oosan1/OriginalSMU_KKHS/User_Manual/HTML/前面パネル_SMUモード_留意点.png

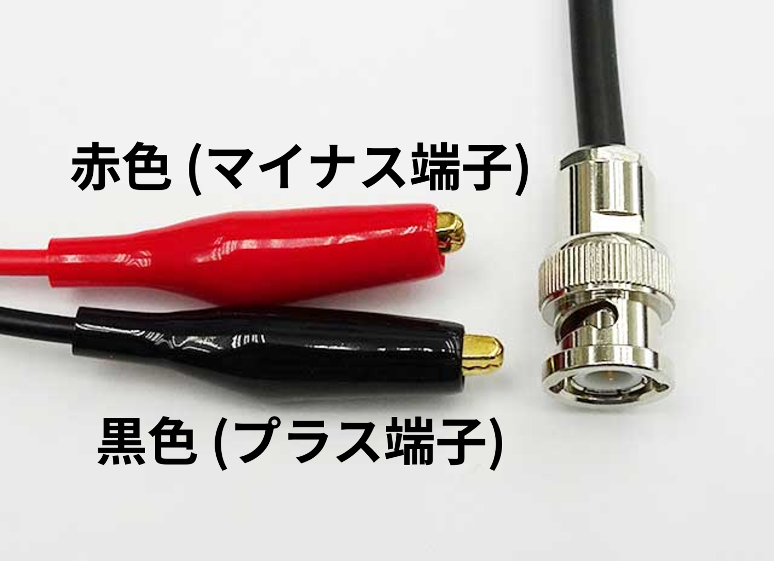
User_Manual/HTML/前面パネル_SMUモード_留意点.png
