oosan1/OriginalSMU_KKHS/User_Manual/HTML/抵抗基盤.jpg

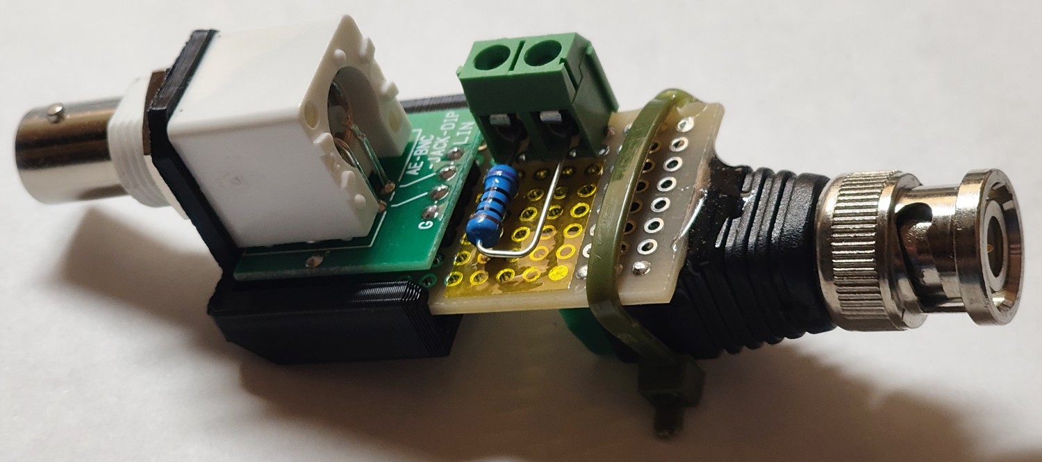
User_Manual/HTML/抵抗基盤.jpg
