oosan1/OriginalSMU_KKHS/Documents/フォルダ・ファイル構造.md

oldと付いているフォルダはもう使われていないデータが入っている。特に説明はしない。

## .gitignore
バージョン管理の対象外フォルダ・ファイルを指定している。
## README.md
githubで表示した時に最初に表示される内容。

# .git
バージョン管理のために自動的に作成されるフォルダ。特に気にしなくて良い。
# Case
ケースの3Dプリント用データが入っている。
# Circuit
回路図全般が入っている。
## PrintedCircuit3
最も新しい回路図とプリント基板用データが入っている。
# Cliant
クライアントに関するプログラムが入っている。
## Web
Webクライアントに関するプログラムが入っている。
# Documents
プログラムなどに関する説明データが入っている。
# microcomputer
ファームウェアに関するプログラムが入っている。
## C_C++
### SMUcontrol
ファームウェアのC/C++版のデータが入っている。最新バージョンで、クライアントとの通信にも対応している。
## python
ファームウェアのMicroPython版のデータが入っている。途中でC/C++に移行したため、基本的なシリアル通信とDAC制御、IVカーブ測定などの機能しかない。ただ、開発初期のプログラムであるということと、シンプルであることから、参考にはなると思う。
# User_Manual
IMPACTの取り扱い説明書のデータが入っている。
## HTML
HTML版
## PDF
PDF版
