oosan1/OriginalSMU_KKHS/Documents/フォルダ・ファイル構造.pdf

フォルダ・ファイル構造.md | 2026-04-03

1 / 2

oldと付いているフォルダはもう使われていないデータが⼊っている。特に説明はしない。

## .gitignore

バージョン管理の対象外フォルダ・ファイルを指定している。

## README.md

githubで表⽰した時に最初に表⽰される内容。

# .git

バージョン管理のために⾃動的に作成されるフォルダ。特に気にしなくて良い。

# Case

ケースの3Dプリント⽤データが⼊っている。

# Circuit

回路図全般が⼊っている。

## PrintedCircuit3

最も新しい回路図とプリント基板⽤データが⼊っている。

# Client

クライアントに関するプログラムが⼊っている。

## Web

Webクライアントに関するプログラムが⼊っている。

# Documents

プログラムなどに関する説明データが⼊っている。

# microcomputer

ファームウェアに関するプログラムが⼊っている。

## C_C++

フォルダ・ファイル構造.md | 2026-04-03

2 / 2

SMUcontrol

ファームウェアのC/C++版のデータが⼊っている。最新バージョンで、クライアントとの通信にも対応して いる。

## python

ファームウェアのMicroPython版のデータが⼊っている。途中でC/C++に移⾏したため、基本的なシリアル 通信とDAC制御、IVカーブ測定などの機能しかない。ただ、開発初期のプログラムであるということと、シ ンプルであることから、参考にはなると思う。

# User_Manual

IMPACTの取り扱い説明書のデータが⼊っている。

## HTML

HTML版

## PDF

PDF版
