oosan1/OriginalSMU_KKHS/Documents/元データ/ドキュメントガイド.md

# フォルダ・ファイル構造
プロジェクトフォルダ全体の構造と役割について書かれている。

# プログラム解説
IMPACTで使用されているプログラムの解説や、他のプロジェクトにも流用できるであろうプログラム上のテクニックが書かれている。 \
Web上の方が色もついていて見やすいのでおすすめ。 \
Web上 - [https://qiita.com/akaharaimori555/private/044836d0a609eaf0e2f4](https://qiita.com/akaharaimori555/private/044836d0a609eaf0e2f4)

# IMPACT開発ガイド
IMPACTの開発を始める手順が書かれている。

# IMPACTシステムフローの見方
名前のまま \
Web上 - [https://viewer.diagrams.net/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](https://viewer.diagrams.net/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)

# IMPACTシステムフロー
IMPACTで使用されているプログラムのフローチャート。ただし、測定に関係する所を抜粋している。
