oosan1/OriginalSMU_KKHS/Documents/0_最初に読む_ドキュメントガイド.pdf

ドキュメントガイド.md | 2026-04-03

1 / 1

# フォルダ・ファイル構造

プロジェクトフォルダ全体の構造と役割について書かれている。

# プログラム解説

IMPACTで使⽤されているプログラムの解説や、他のプロジェクトにも流⽤できるであろうプログラム上のテ クニックが書かれている。
Web上の⽅が⾊もついていて⾒やすいのでおすすめ。
Web上 - https://qiita.com/akaharaimori555/private/044836d0a609eaf0e2f4

# IMPACT開発ガイド

IMPACTの開発を始める⼿順が書かれている。

# IMPACTシステムフローの⾒⽅

名前のまま
Web上 - https://viewer.diagrams.net/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 (https://viewer.diagrams.net/?tags=%7B%7D&lightbox=1&highlight=0000ff&edit=_blank&layers=1&nav=1&dark=auto)

# IMPACTシステムフロー

IMPACTで使⽤されているプログラムのフローチャート。ただし、測定に関係する所を抜粋している。
