oosan1/OriginalSMU_KKHS/Documents/IMPACT開発ガイド.pdf

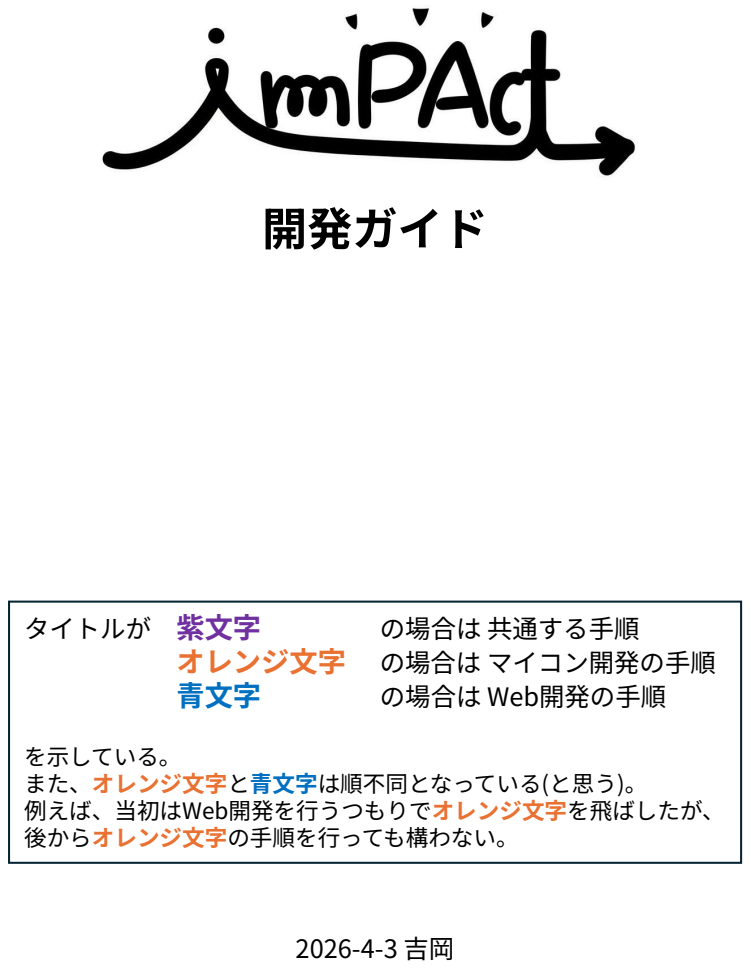
[picture p9: page 1]
タイトルが 紫文字; の場合は 共通する手順; 青文字; の場合は Web開発の手順

オレンジ文字 の場合は マイコン開発の手順

を示している。
また、オレンジ文字と青文字は順不同となっている(と思う)。
例えば、当初はWeb開発を行うつもりでオレンジ文字を飛ばしたが、
後からオレンジ文字の手順を行っても構わない。

0.動作環境
以下から続くガイドはこの動作環境に基づいている。
プロセッサ | Intel(R) Core(TM) Ultra 5 226V (2.10 GHz)
エディション | Windows 11 Home
バージョン | 25H2
インストール日 2026/03/24
OS ビルド 26200.8037
エクスペリエンスWindows 機能エクスペリエンス パック 1000.26100.300.0

注意！！！ ============================================== ユーザー名が日本語の場合、諸ツールのインストールに失敗する。 その場合は別途、ユーザ名が英数字で構成されたユーザーを作成し、そ のユーザーに切り替えて作業を行うこと。
ユーザー名の確認方法↓

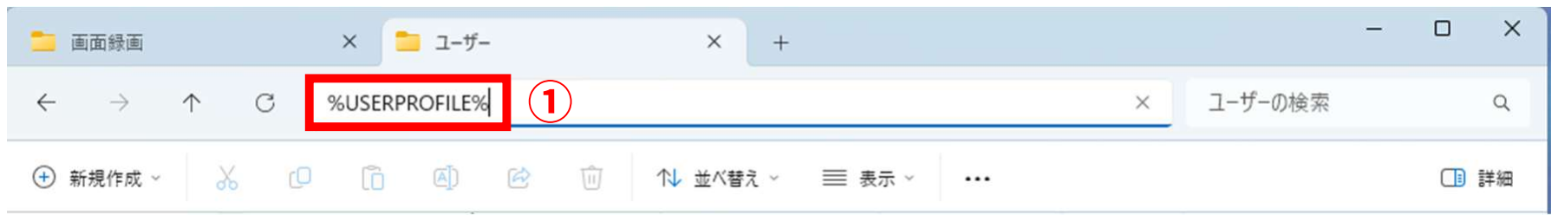
[picture p10: figure]

エクスプローラーに「%USERPROFILE%」と入力してEnterを押す

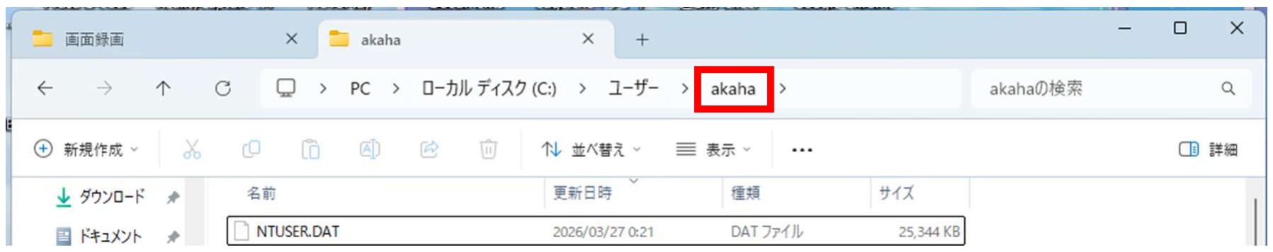
[picture p11: figure]

ユーザー > (ユーザー名) と表示される。この場合であれば「akaha」がユーザー名

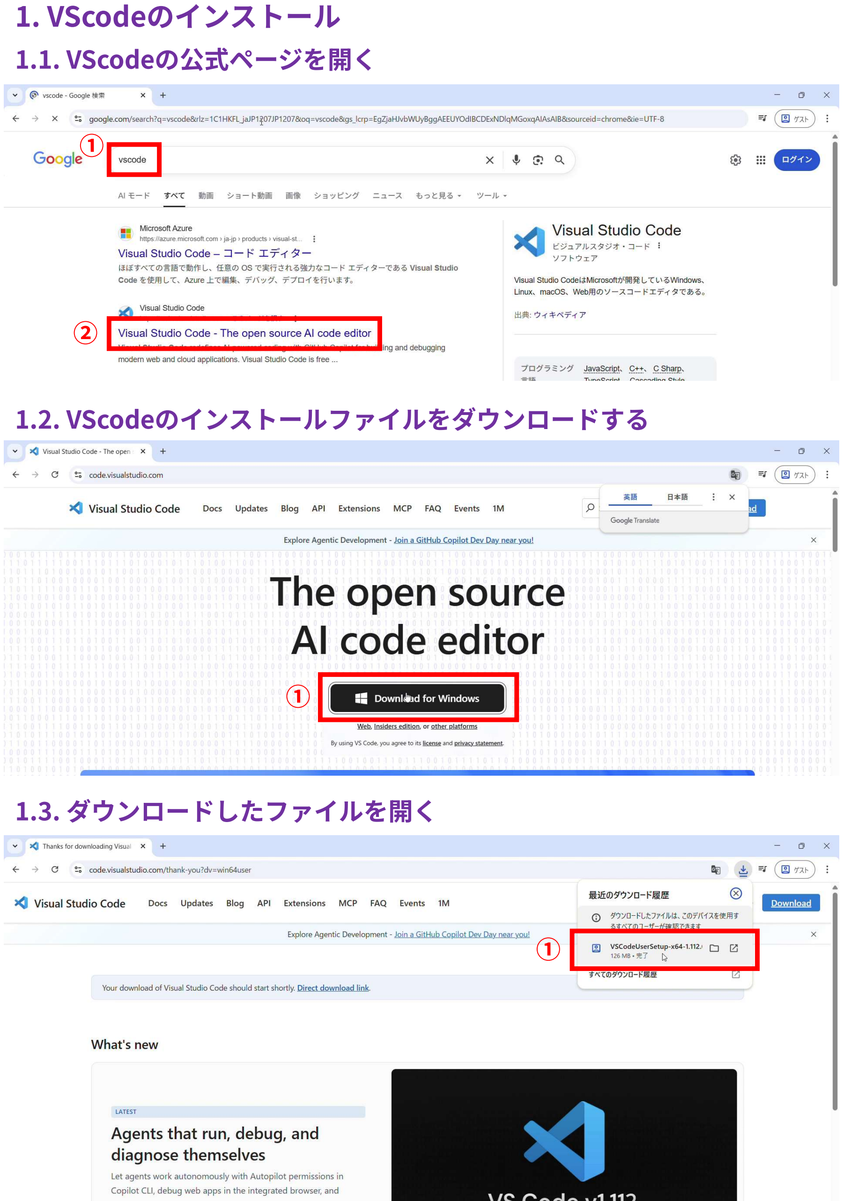
[picture p12: page 3]

### 1. VScodeのインストール

### 1.1. VScodeの公式ページを開く

➀

➁

### 1.2. VScodeのインストールファイルをダウンロードする

➀

### 1.3. ダウンロードしたファイルを開く

➀

1 2

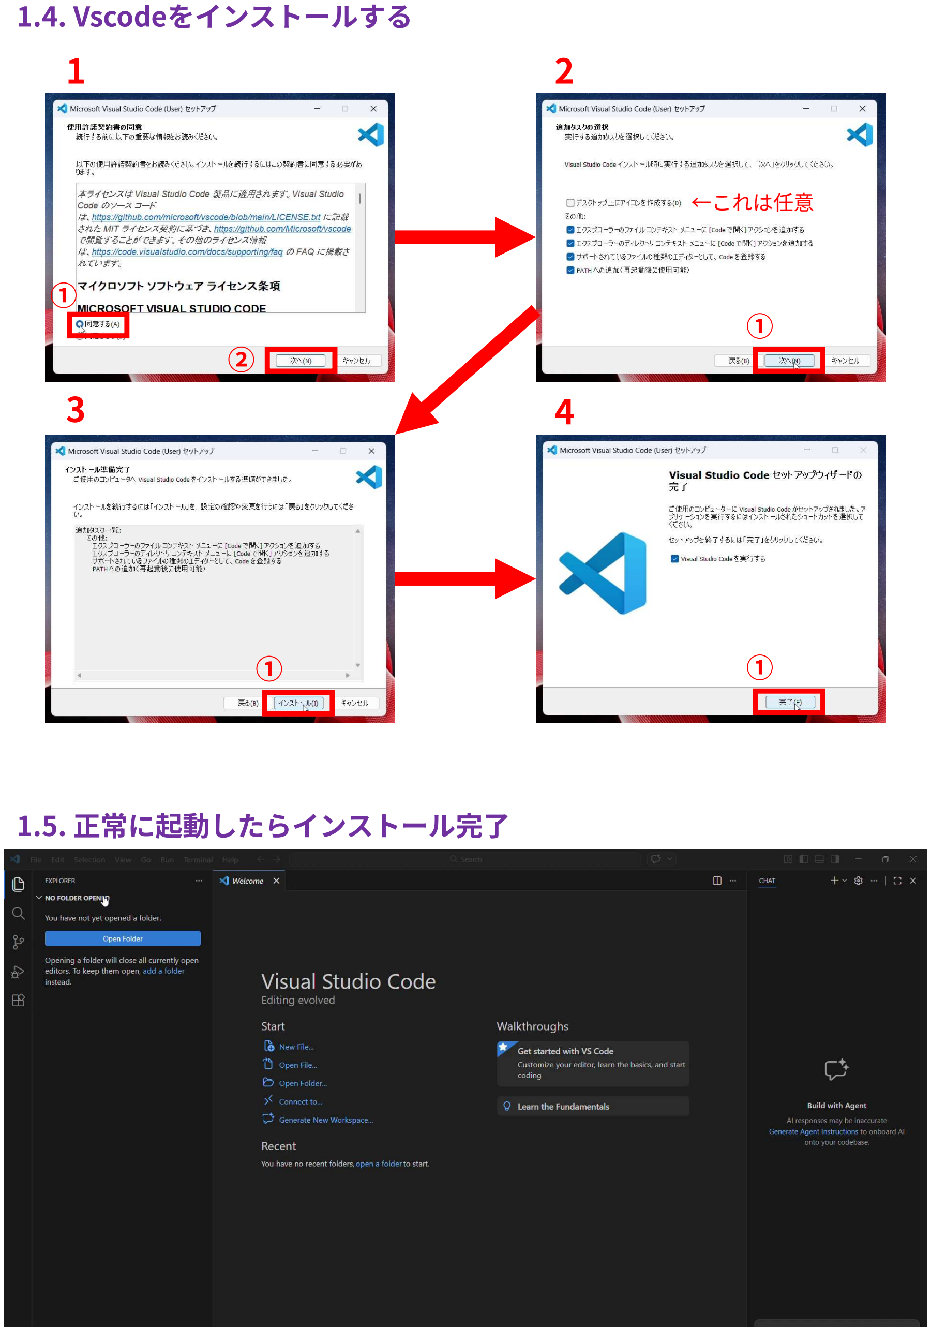
[picture p13: page 4]

### 1.4. Vscodeをインストールする

➀
➁

➀

➀ | ➀

←これは任意

3 4

### 1.5. 正常に起動したらインストール完了

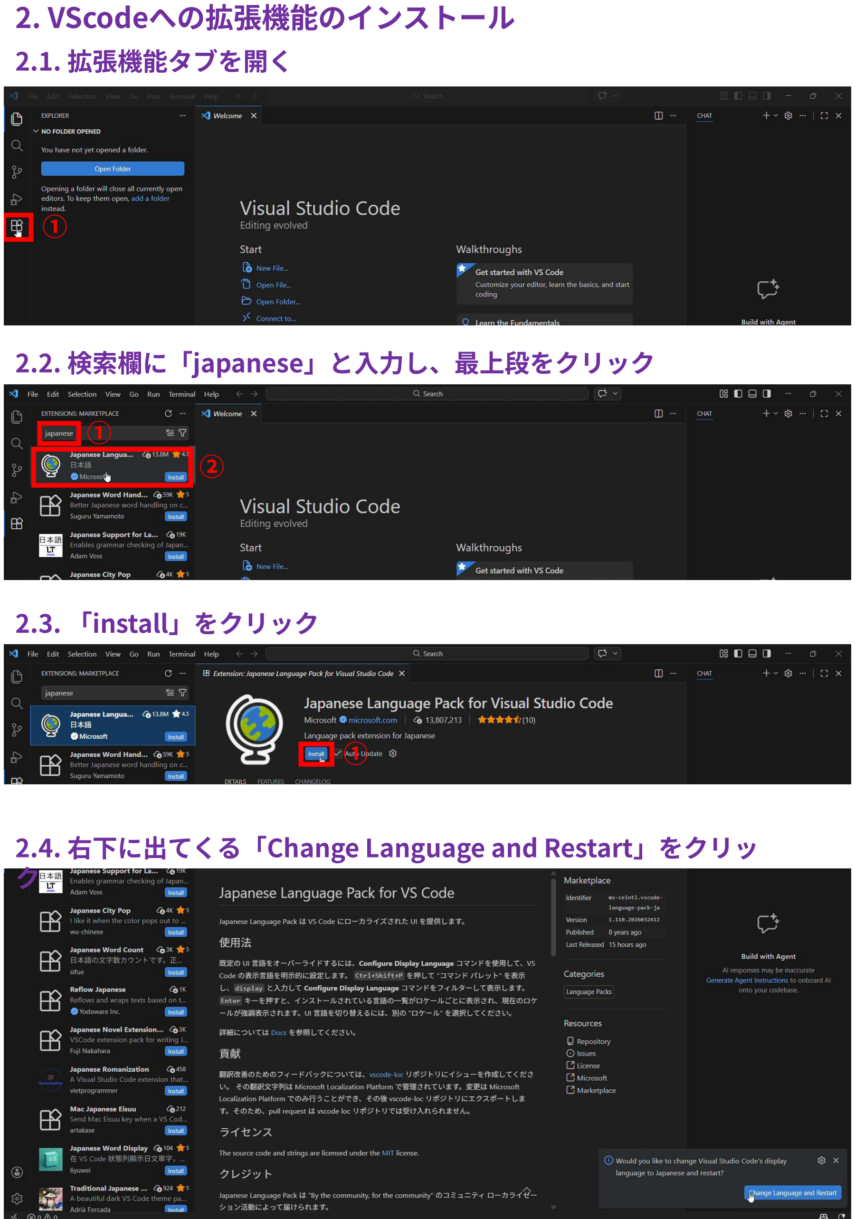
[picture p14: page 5]

### 2. VScodeへの拡張機能のインストール

### 2.1. 拡張機能タブを開く

➀

### 2.2. 検索欄に「japanese」と入力し、最上段をクリック

➀
➁
2.3. 「install」をクリック

➀

### 2.4. 右下に出てくる「Change Language and Restart」をクリッ

ク

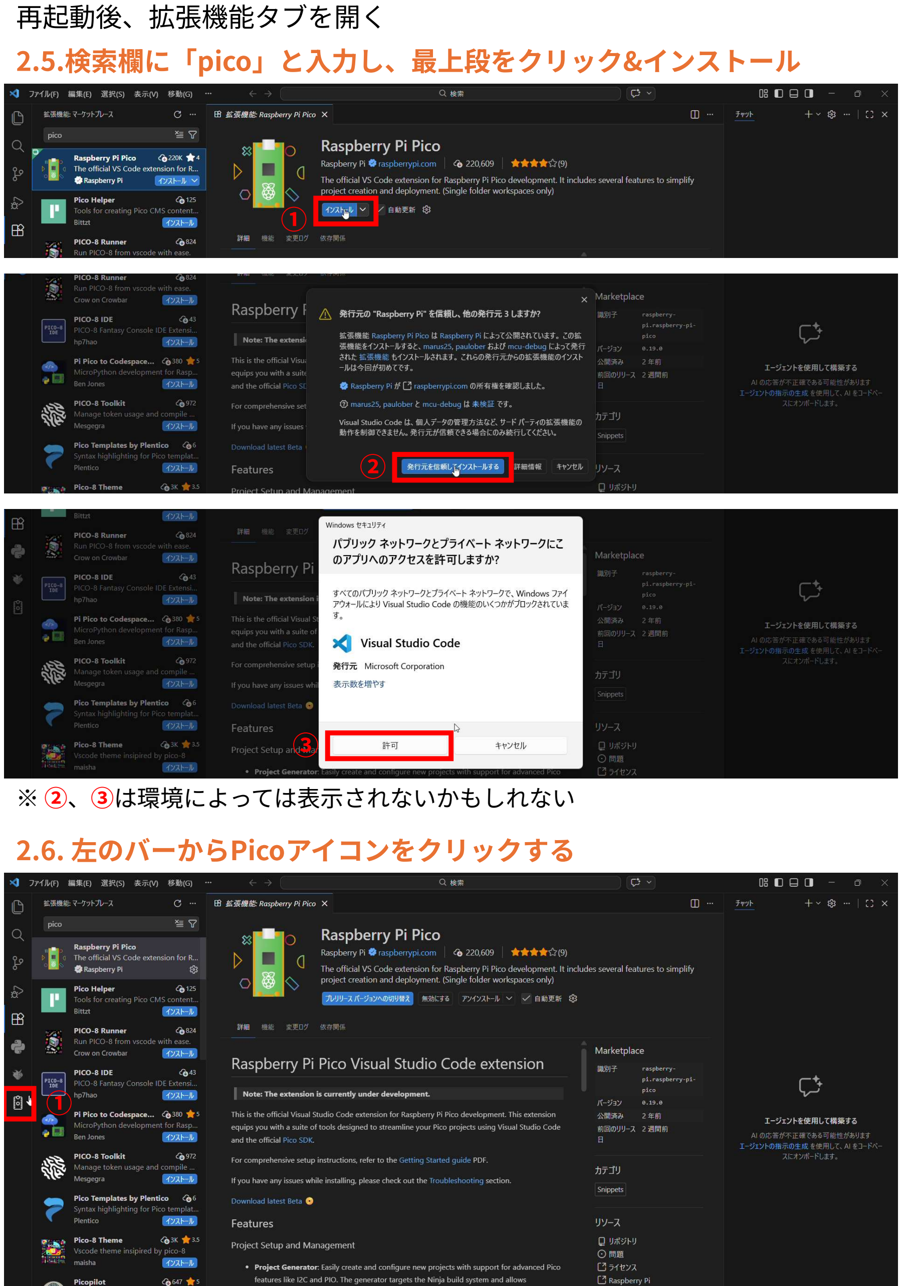
[picture p15: page 6]

2.5.検索欄に「pico」と入力し、最上段をクリック&インストール

再起動後、拡張機能タブを開く

➀

➁

➂
※ ➁、➂は環境によっては表示されないかもしれない

### 2.6. 左のバーからPicoアイコンをクリックする

➀

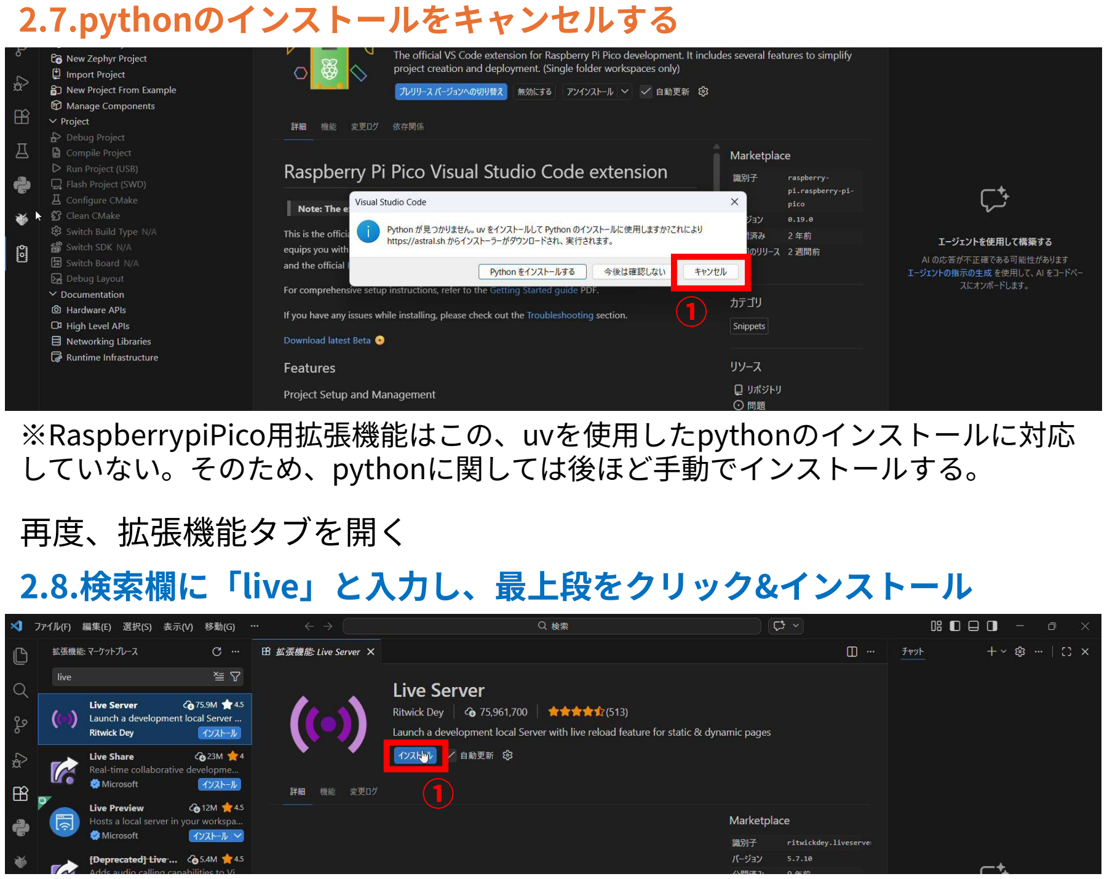
[picture p16: page 7]

2.7.pythonのインストールをキャンセルする

➀

※RaspberrypiPico用拡張機能はこの、uvを使用したpythonのインストールに対応 していない。そのため、pythonに関しては後ほど手動でインストールする。 再度、拡張機能タブを開く
2.8.検索欄に「live」と入力し、最上段をクリック&インストール

➀

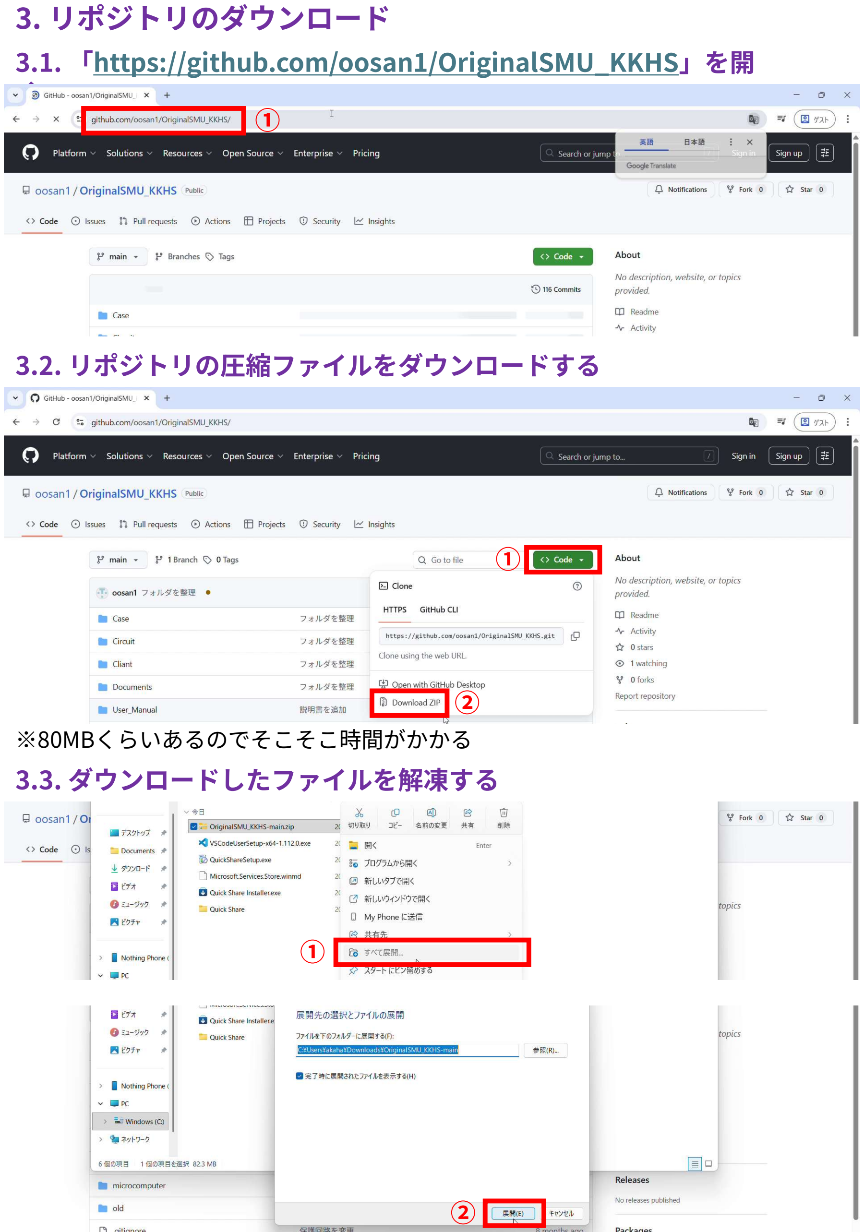
[picture p17: page 8]

### 3. リポジトリのダウンロード

3.1. 「https://github.com/oosan1/OriginalSMU_KKHS」を開 く
➀

### 3.2. リポジトリの圧縮ファイルをダウンロードする

➀

➁
※80MBくらいあるのでそこそこ時間がかかる

### 3.3. ダウンロードしたファイルを解凍する

➀

➁

### 3.4. 解凍したフォルダの”中身”を適当な場所に移動する。

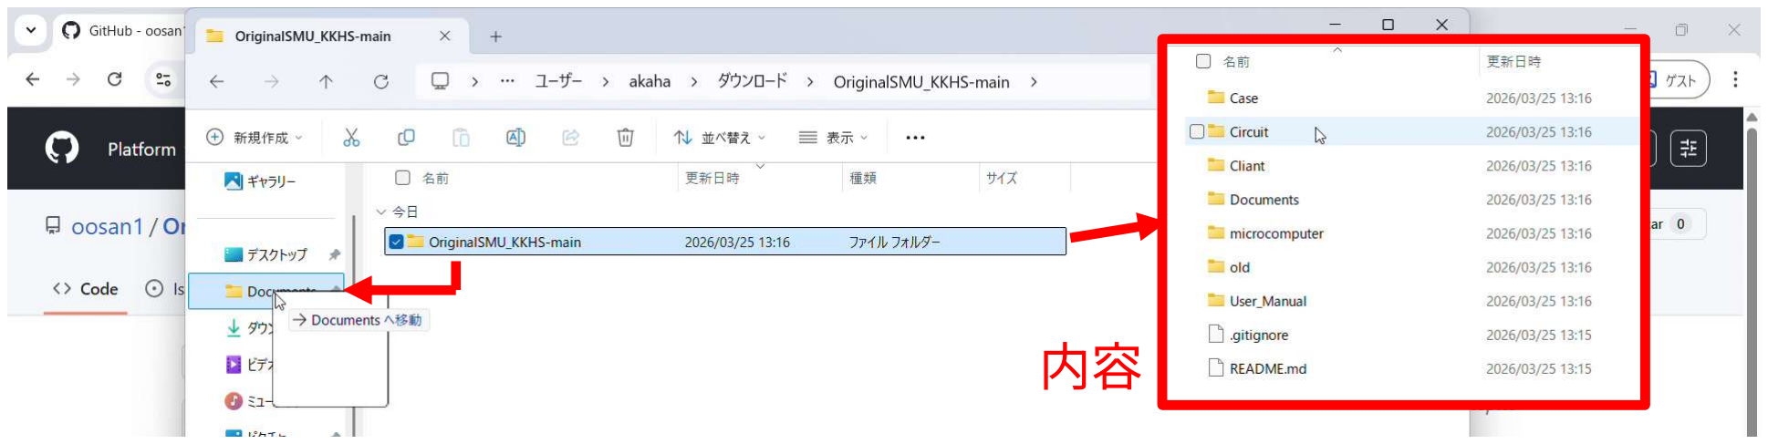
[picture p18: figure]
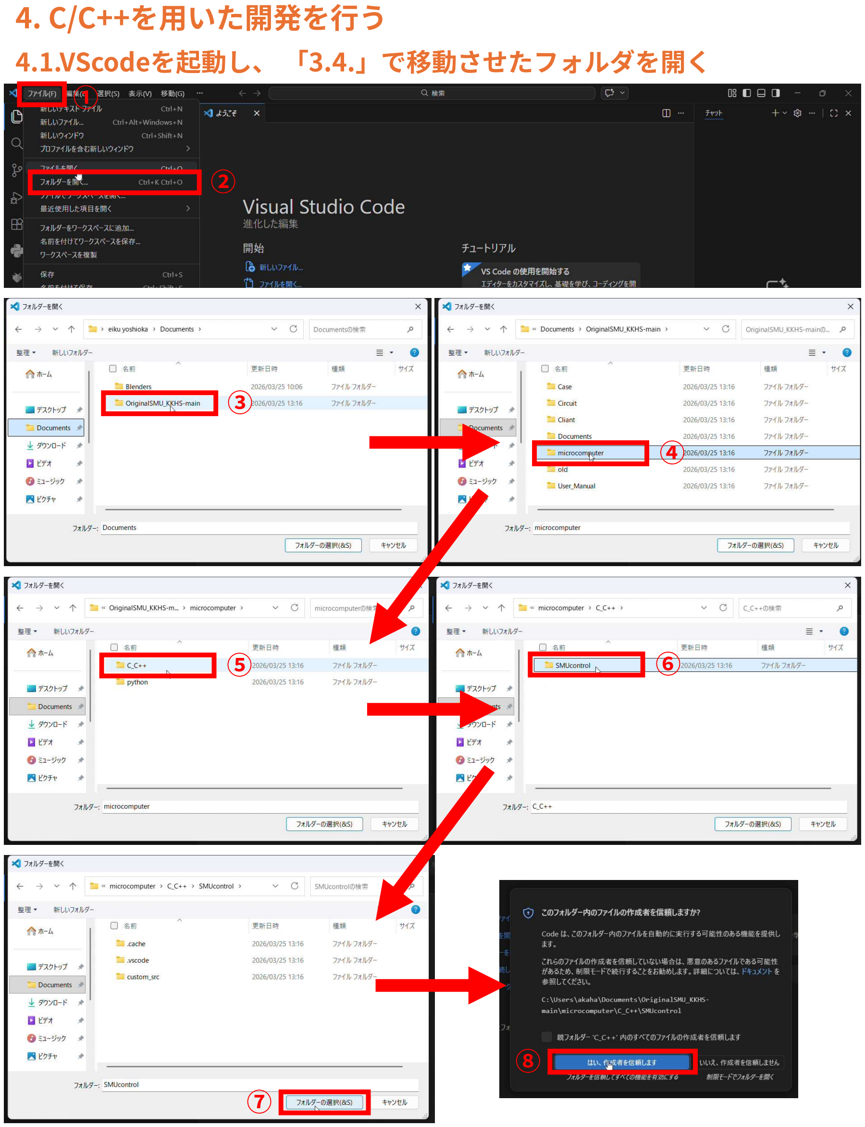
[picture p19: page 10]

### 4. C/C++を用いた開発を行う

4.1.VScodeを起動し、 「3.4.」で移動させたフォルダを開く ➀

➁

➂
➃
➄ | ➅

➆

➇

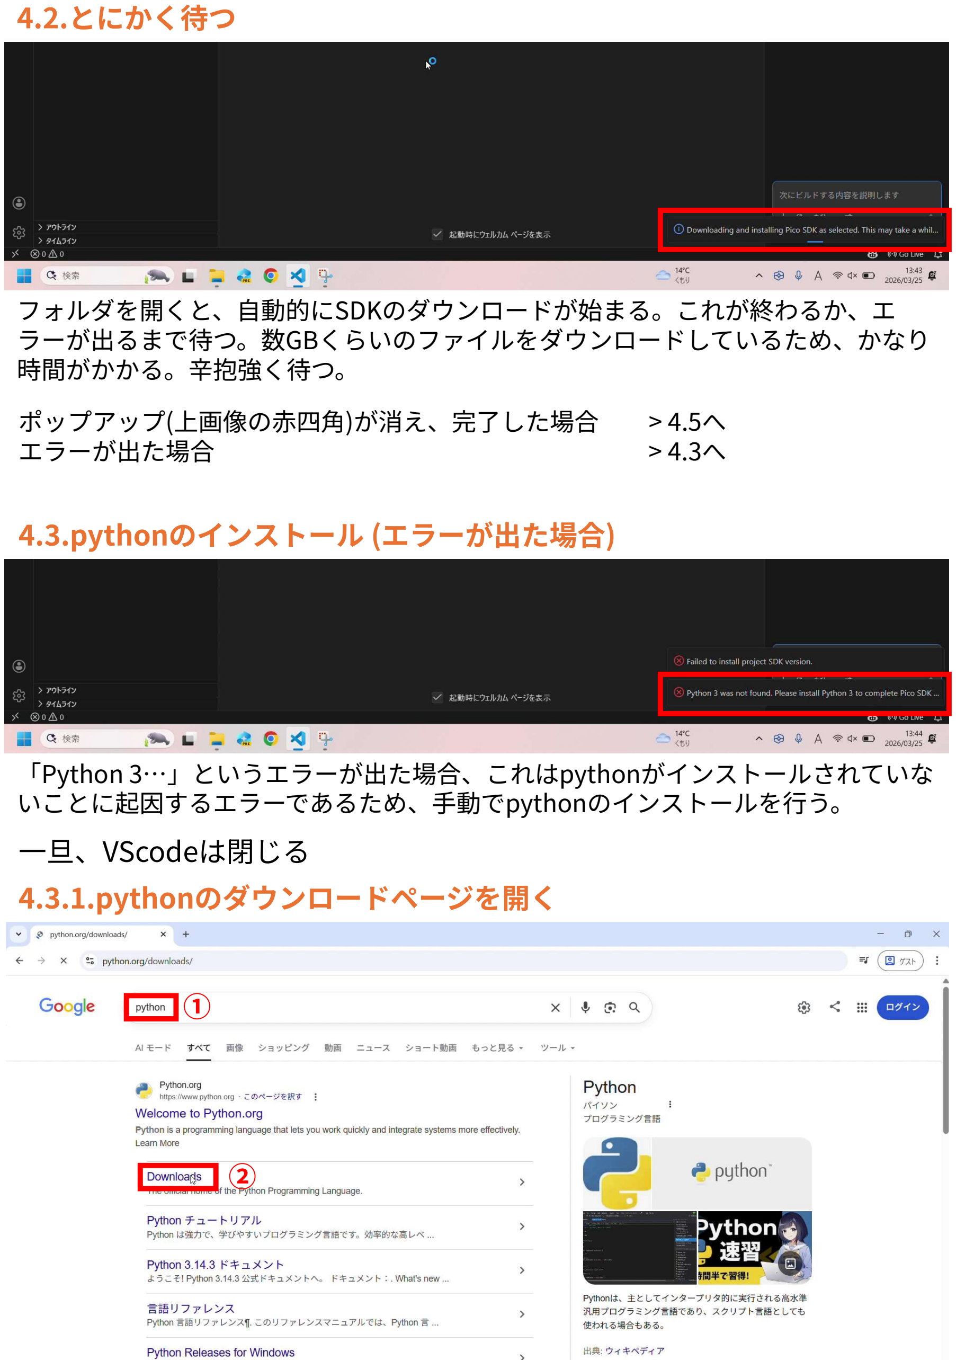
[picture p20: page 11]

4.2.とにかく待つ

フォルダを開くと、自動的にSDKのダウンロードが始まる。これが終わるか、エ ラーが出るまで待つ。数GBくらいのファイルをダウンロードしているため、かなり 時間がかかる。辛抱強く待つ。

4.3.pythonのインストール (エラーが出た場合)

「Python 3⋯」というエラーが出た場合、これはpythonがインストールされていな いことに起因するエラーであるため、手動でpythonのインストールを行う。 一旦、VScodeは閉じる
4.3.1.pythonのダウンロードページを開く

➀

➁

ポップアップ(上画像の赤四角)が消え、完了した場合 | > 4.5へ
エラーが出た場合 | > 4.3へ

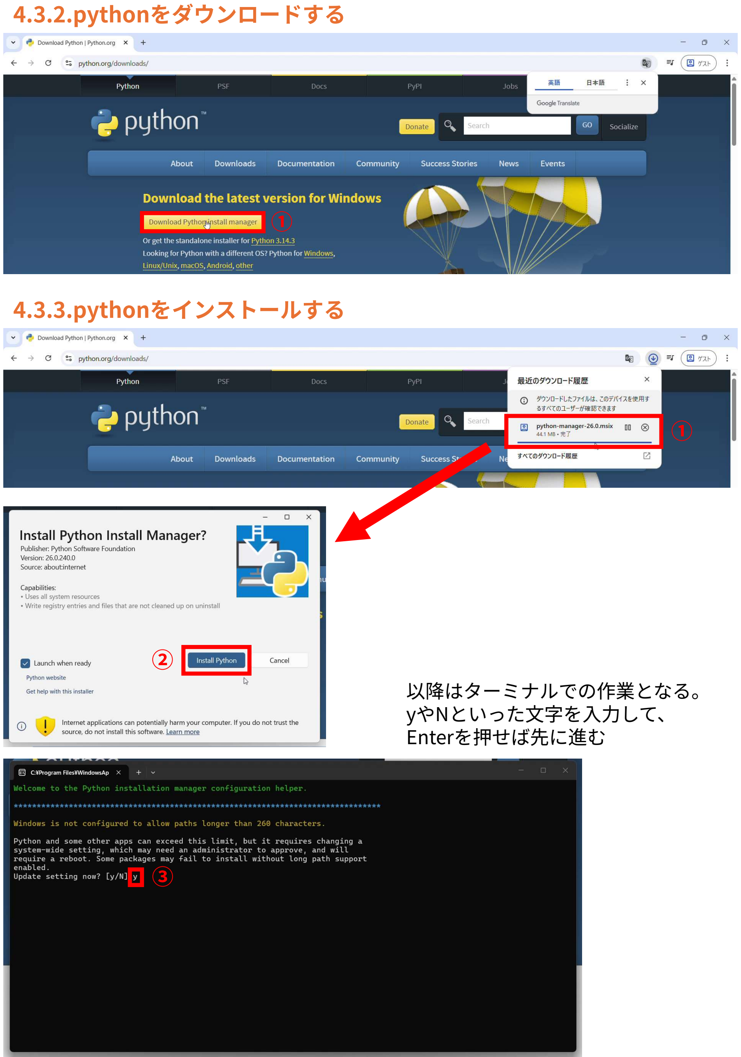
[picture p21: page 12]

4.3.2.pythonをダウンロードする

➀

4.3.3.pythonをインストールする

➀

➁

➂

以降はターミナルでの作業となる。
yやNといった文字を入力して、
Enterを押せば先に進む

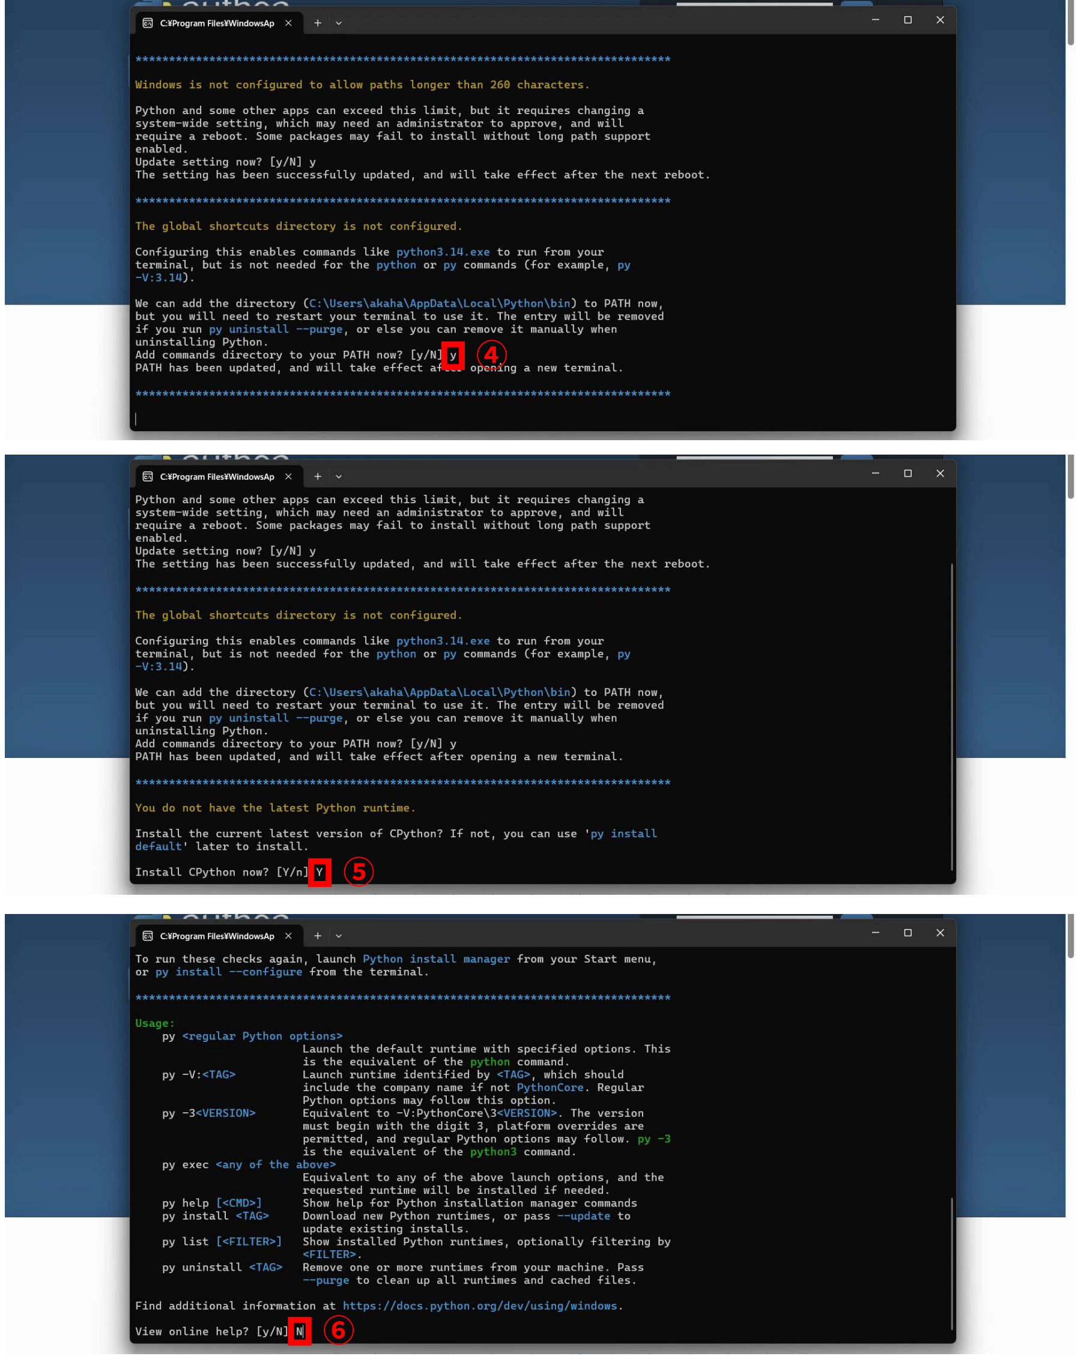
[picture p22: page 13]

➃

➄

➅

4.4.再度、SDKのダウンロードを行う
4.1と同じ手順でフォルダを開き、ひたすら待つ

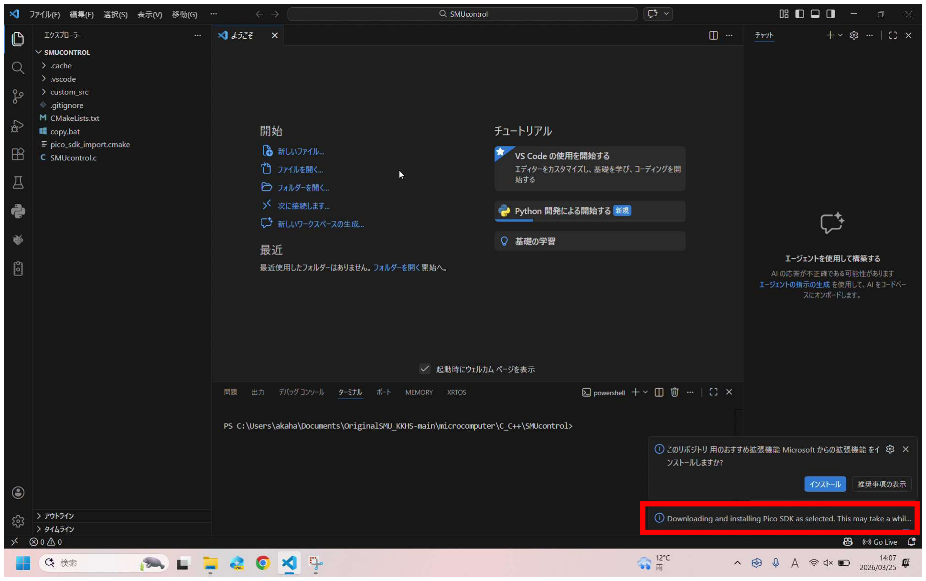
[picture p23: figure]

非常に時間がかかる。 もし、一晩待っても完了していない場合はユーザー名が日 本語でないか確認してほしい(0.動作環境を参照)。
ポップアップ(上画像の赤四角内)が完全に消えれば完了

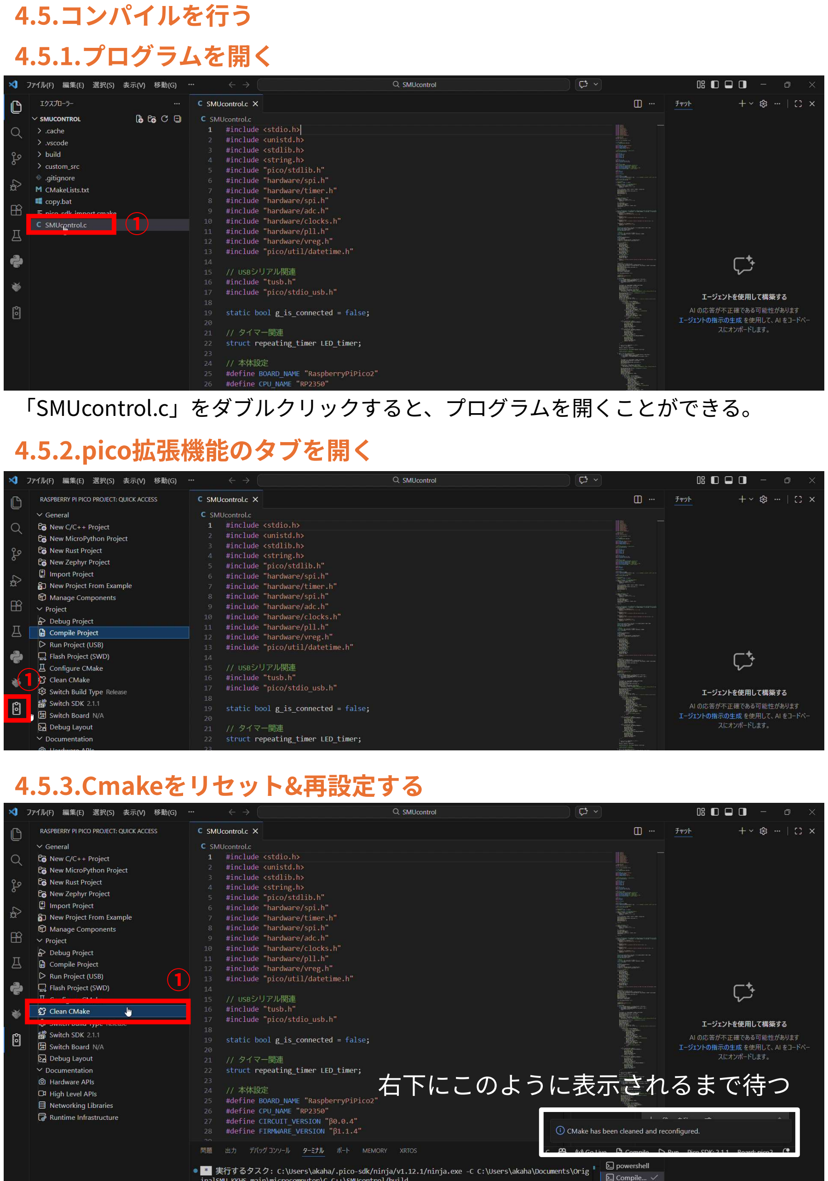
[picture p24: page 15]

4.5.コンパイルを行う
4.5.1.プログラムを開く

➀

「SMUcontrol.c」をダブルクリックすると、プログラムを開くことができる。 4.5.2.pico拡張機能のタブを開く

➀

4.5.3.Cmakeをリセット&再設定する

➀

右下にこのように表示されるまで待つ

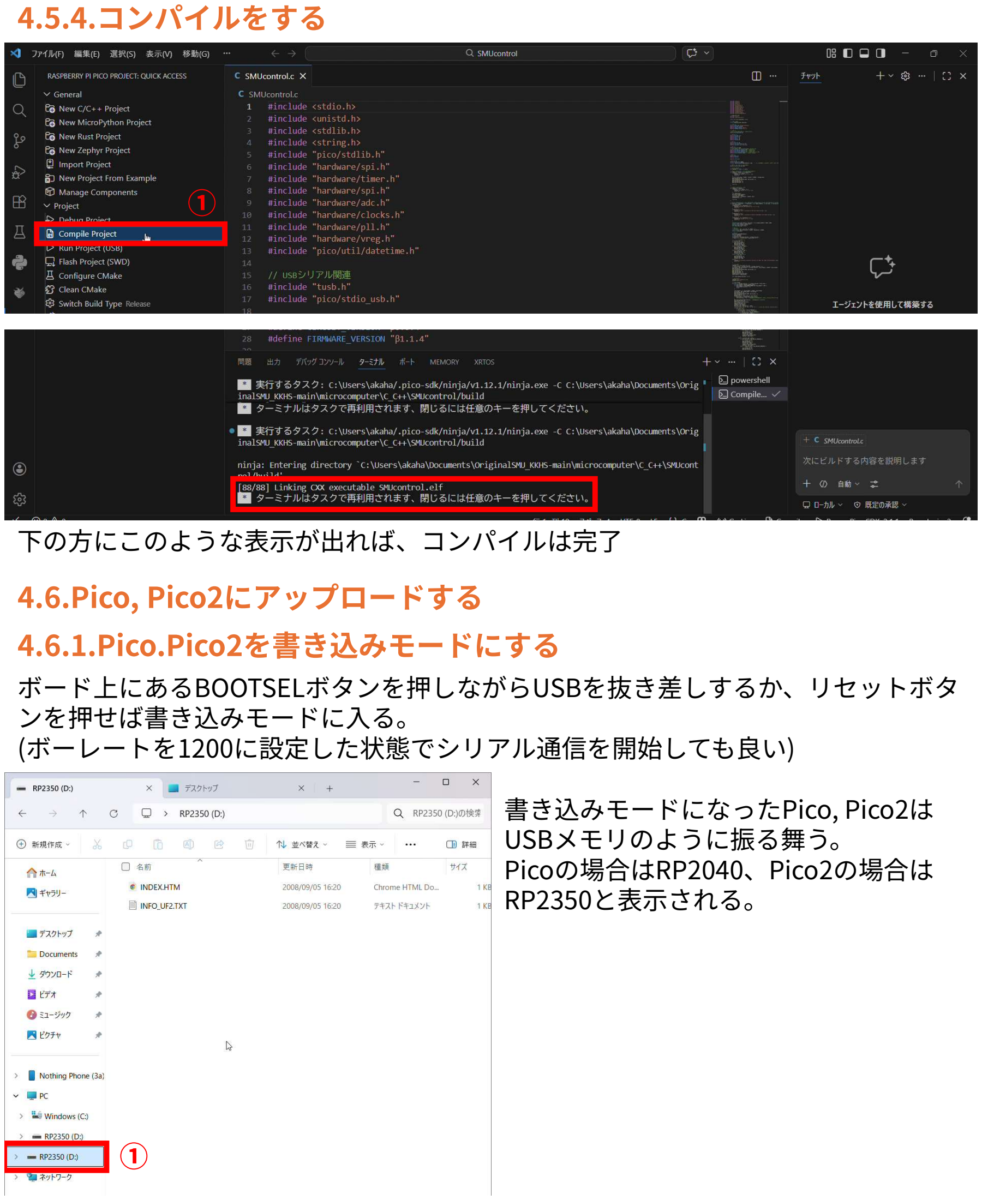
[picture p25: page 16]

4.5.4.コンパイルをする

➀

下の方にこのような表示が出れば、コンパイルは完了
4.6.Pico, Pico2にアップロードする
4.6.1.Pico.Pico2を書き込みモードにする ボード上にあるBOOTSELボタンを押しながらUSBを抜き差しするか、リセットボタ ンを押せば書き込みモードに入る。
(ボーレートを1200に設定した状態でシリアル通信を開始しても良い) 書き込みモードになったPico, Pico2は
USBメモリのように振る舞う。
Picoの場合はRP2040、Pico2の場合は
RP2350と表示される。

➀

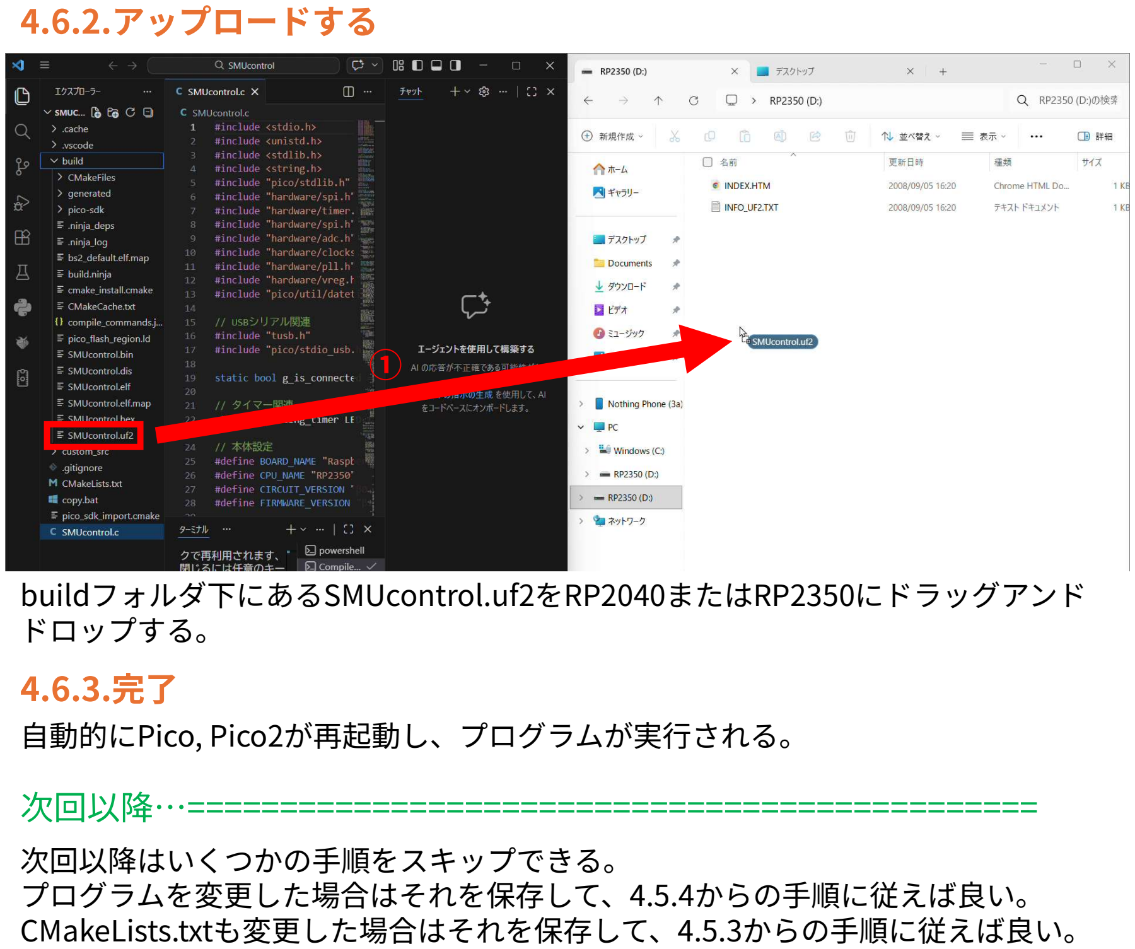
[picture p26: page 17]

4.6.2.アップロードする

➀

buildフォルダ下にあるSMUcontrol.uf2をRP2040またはRP2350にドラッグアンド ドロップする。
4.6.3.完了
自動的にPico, Pico2が再起動し、プログラムが実行される。 次回以降⋯============================================== 次回以降はいくつかの手順をスキップできる。
プログラムを変更した場合はそれを保存して、4.5.4からの手順に従えば良い。 CMakeLists.txtも変更した場合はそれを保存して、4.5.3からの手順に従えば良い。

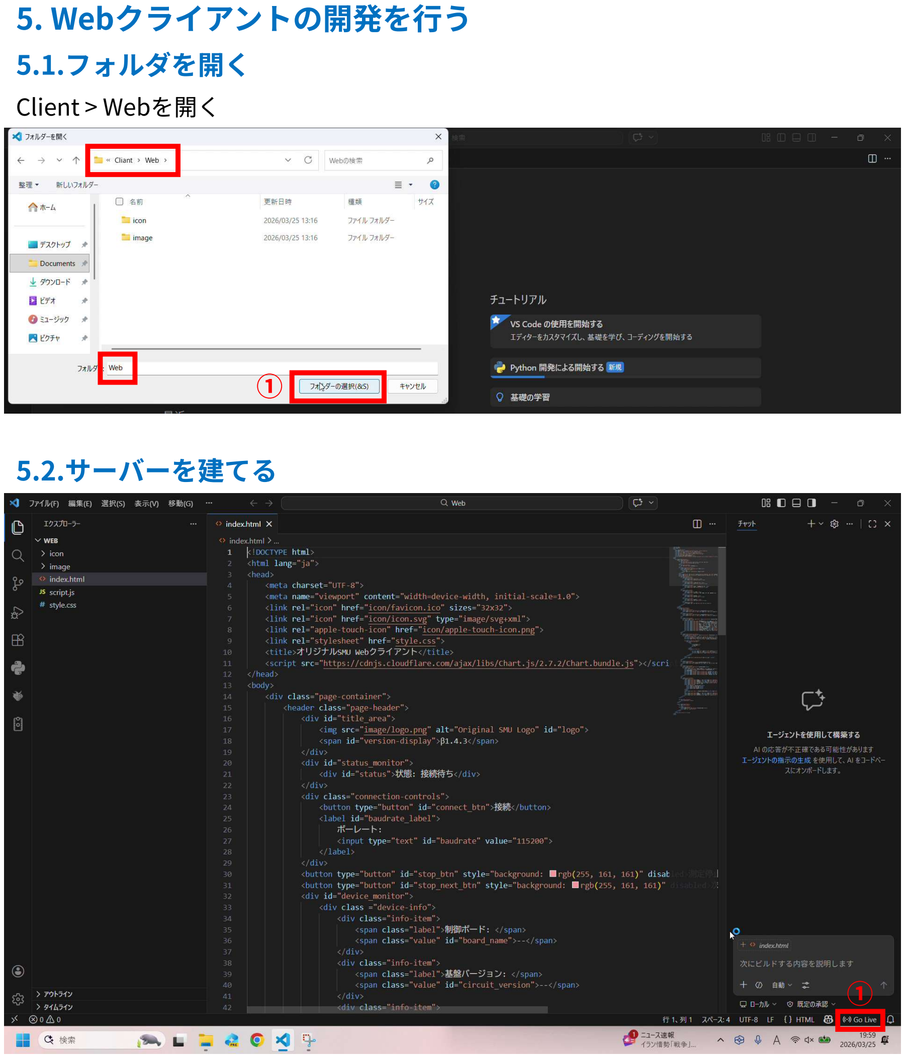
[picture p27: page 18]

### 5. Webクライアントの開発を行う

5.1.フォルダを開く
Client > Webを開く

➀

5.2.サーバーを建てる

➀

5.3.自動的にブラウザが開く

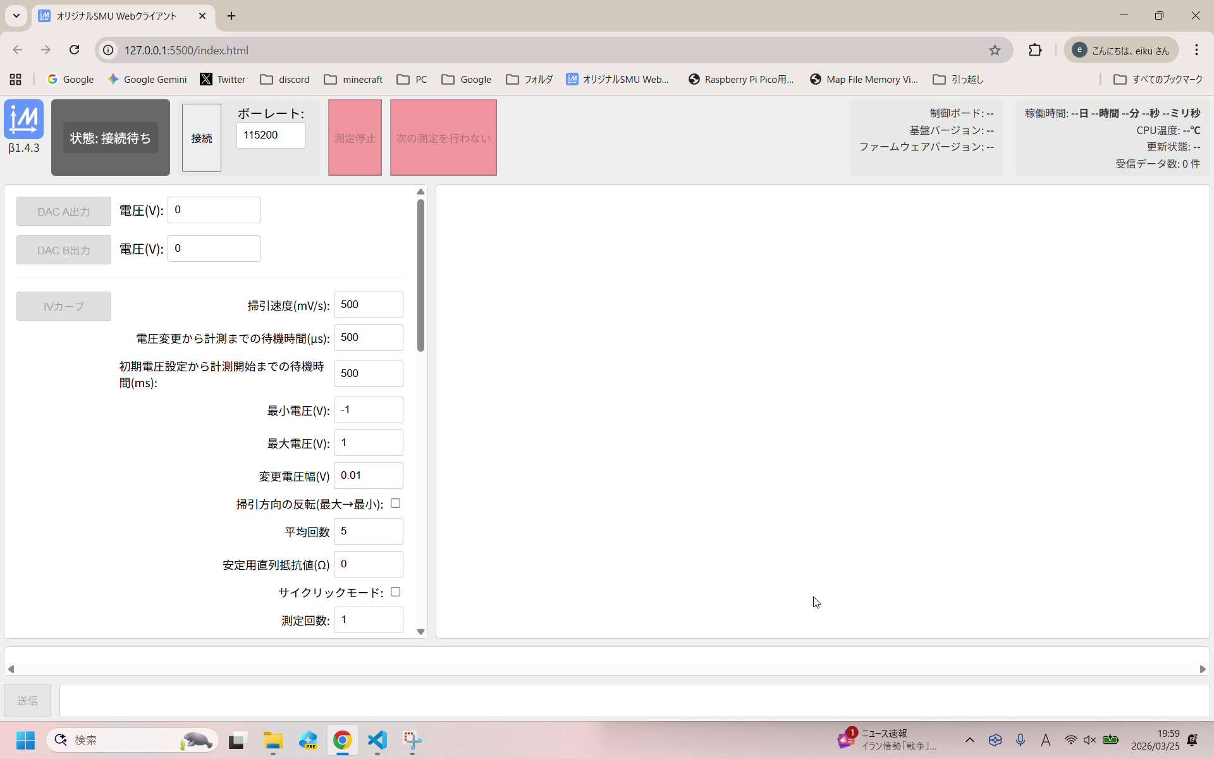
[picture p28: figure]

以降はVScodeを開いている限り、プログラムを変更すると自動でブラウザが再読み 込みされ、変更が反映される。
Vscodeを閉じた場合は、5.1から始める必要がある。
