oosan1/OriginalSMU_KKHS/Case/抵抗基盤カバーver4.3mf

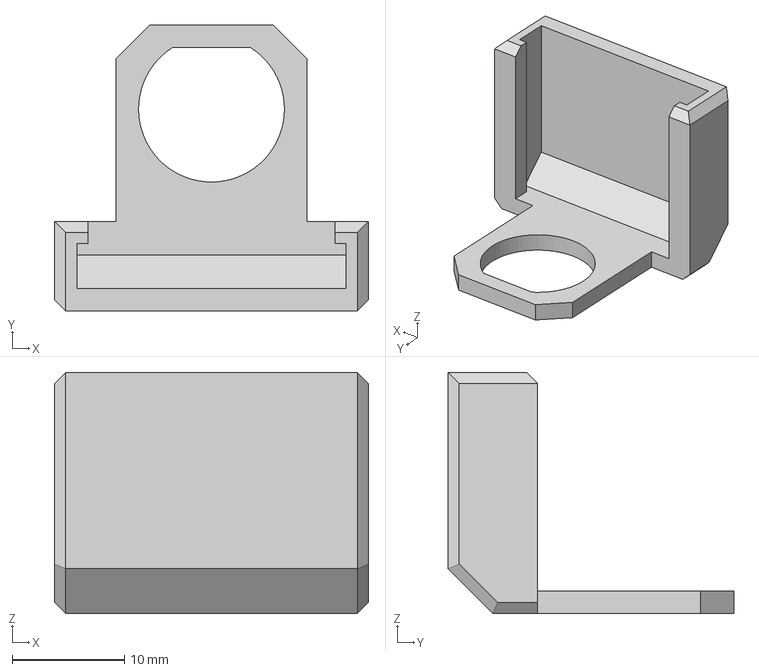
[picture p29: CAD file, 2026-03-12]
Case/抵抗基盤カバーver4.3mf
28.0 x 25.5 x 21.5 mm
