oosan1/OriginalSMU_KKHS/Circuit/PrintedCircuit3/TLP241A_F/DIP4_90deg.step

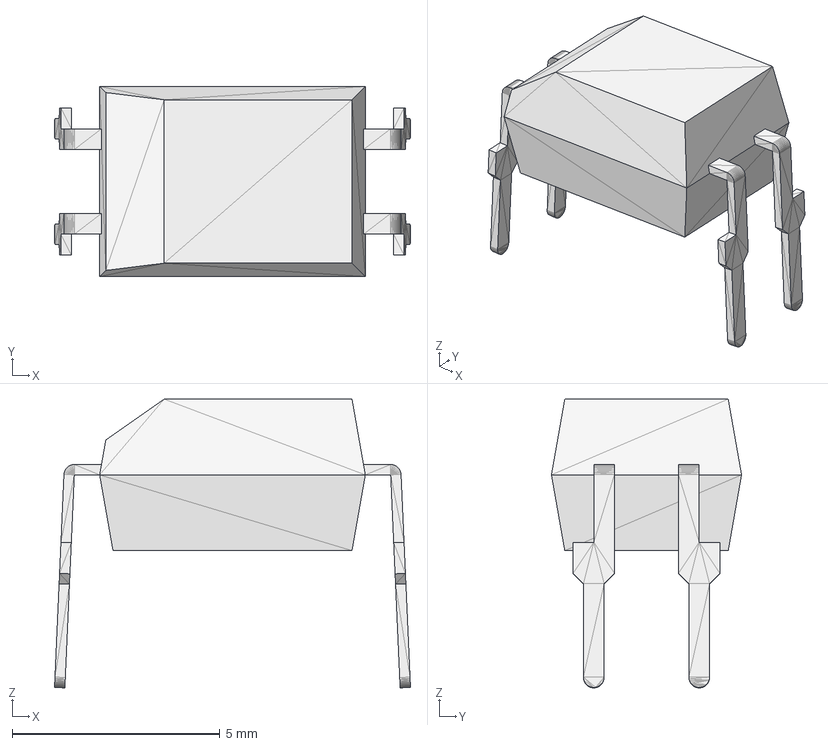
[picture p31: CAD file, 2025-06-22]
Circuit/PrintedCircuit3/TLP241A_F/DIP4_90deg.step
8.57 x 4.58 x 6.96 mm
