oosan1/OriginalSMU_KKHS/Case/ケース_側面_ver5.3mf

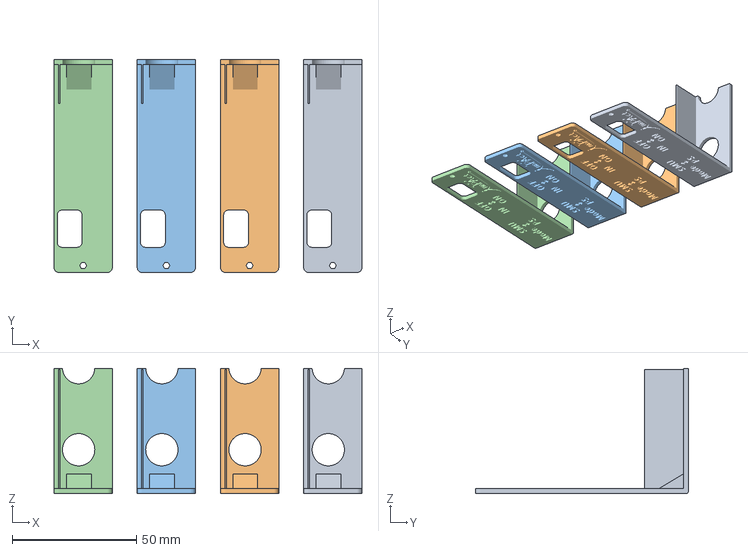
[picture p32: CAD file, 2026-03-12]
Case/ケース_側面_ver5.3mf
124.0 x 85.8 x 50.5 mm
ボディ6 x 4
