oosan1/OriginalSMU_KKHS/Circuit/PrintedCircuit3/足テスト_r5.4_d0.5.3mf

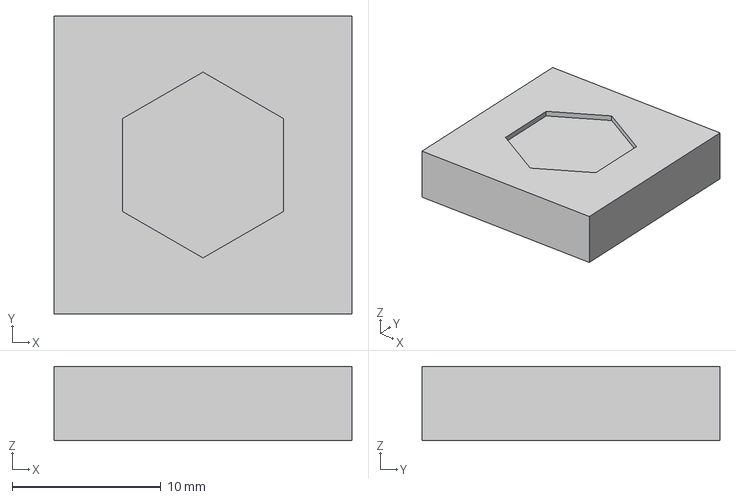
[picture p33: CAD file, 2026-03-12]
Circuit/PrintedCircuit3/足テスト_r5.4_d0.5.3mf
20.0 x 20.0 x 5.00 mm
