oosan1/OriginalSMU_KKHS/Case/ケース_メイン_ver4.3mf

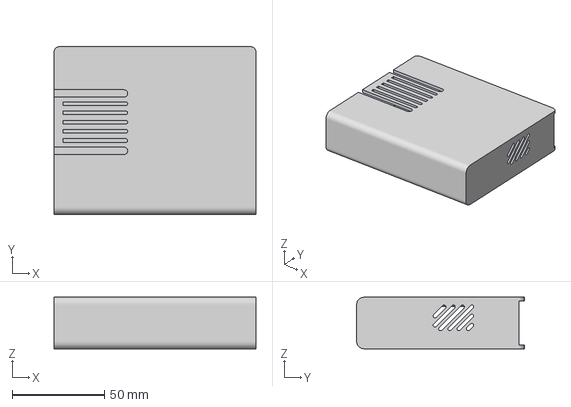
[picture p34: CAD file, 2026-03-12]
Case/ケース_メイン_ver4.3mf
109.6 x 91.0 x 28.0 mm
