oosan1/OriginalSMU_KKHS/Case/v4_case_huta_typeB.3mf

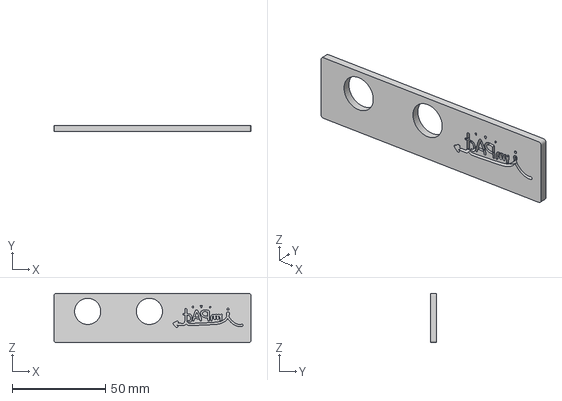
[picture p35: CAD file, 2025-09-23]
Case/v4_case_huta_typeB.3mf
105.4 x 3.00 x 26.4 mm
