oosan1/OriginalSMU_KKHS/Case/v3_case_top.3mf

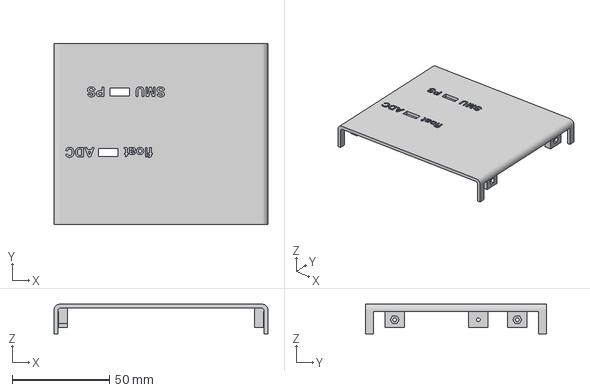
[picture p37: CAD file, 2025-07-24]
Case/v3_case_top.3mf
110.1 x 93.1 x 15.3 mm
