oosan1/OriginalSMU_KKHS/Case/v3_case_under.3mf

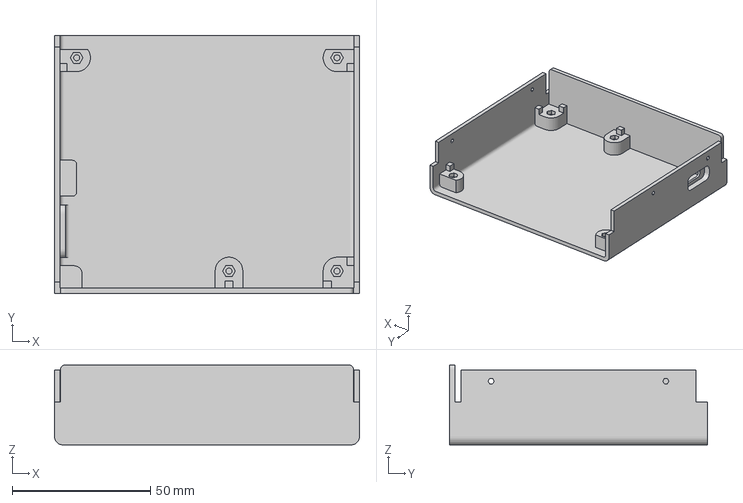
[picture p38: CAD file, 2025-07-24]
Case/v3_case_under.3mf
110.1 x 93.1 x 28.8 mm
