oosan1/OriginalSMU_KKHS/Circuit/PrintedCircuit3/SMU_ver0-0-4.step

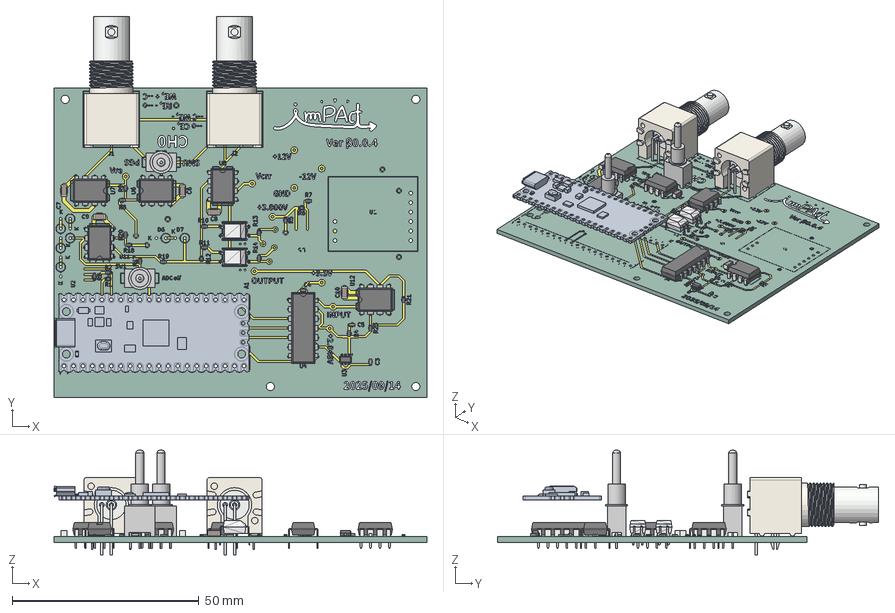
[picture p39: CAD file, 2026-03-12]
Circuit/PrintedCircuit3/SMU_ver0-0-4.step
100.0 x 102.3 x 28.0 mm
R_0603_1608Metric x 20
DIP4_90deg x 2
C_1206_3216Metric x 5
C_0603_1608Metric x 3
BNC_3D x 2
DIP-8_W7.62mm x 5
DIP-14_W7.62mm
SOT-23-6
switch_3D x 2
PICO_REF_BOARD
PICO_REF_USB
PICO_REF_SWITCH
PICO_REF_MICROCONTROLLER
PICO_REF_LED
PICO_REF_COMP_1
PICO_REF_COMP_2
PICO_REF_COMP_3 x 2
PICO_REF_COMP_4
PICO_REF_COMP_5
PICO_REF_COMP_6
PICO_REF_COMP_7
PICO_REF_INDUCTOR
SMU_copper
SMU_silkscreen
SMU_PCB
