oosan1/OriginalSMU_KKHS/Circuit/PrintedCircuit3/ケースチェック1_0.25mmアライメント.stl

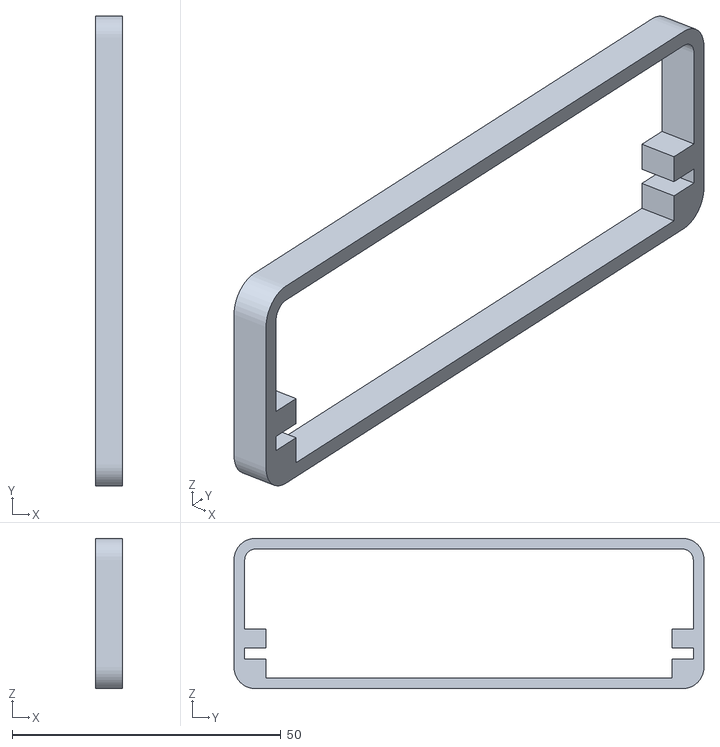
[picture p40: CAD file, 2026-03-12]
Circuit/PrintedCircuit3/ケースチェック1_0.25mmアライメント.stl
5.00 x 87.5 x 28.0
