oosan1/OriginalSMU_KKHS/Circuit/PrintedCircuit3/ケース_側面_ver4.3mf

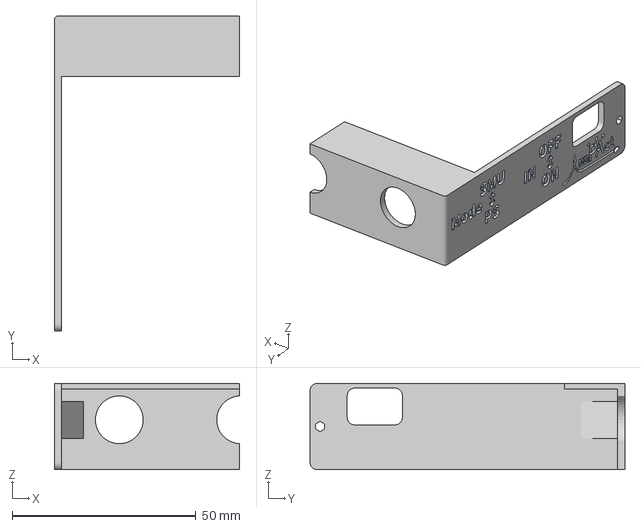
[picture p41: CAD file, 2026-03-12]
Circuit/PrintedCircuit3/ケース_側面_ver4.3mf
50.5 x 85.8 x 23.5 mm
