oosan1/OriginalSMU_KKHS/Case/SMU_case v2.3mf

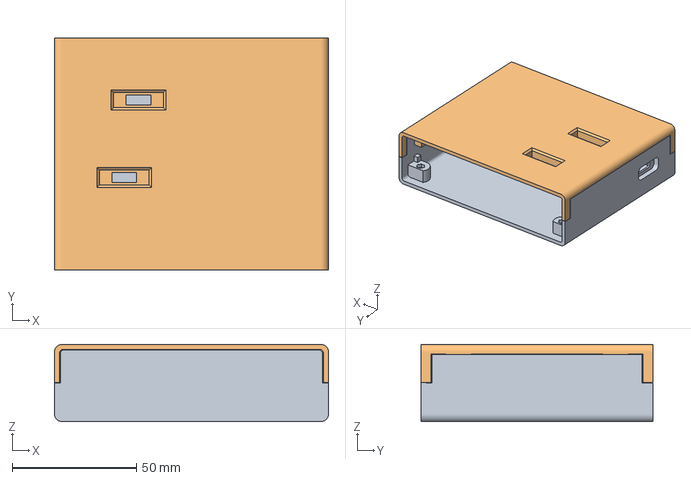
[picture p42: CAD file, 2025-07-12]
Case/SMU_case v2.3mf
110.1 x 93.1 x 31.0 mm
ボディ1
ボディ2
