oosan1/OriginalSMU_KKHS/Circuit/PrintedCircuit3/ケースチェック3_XZ0.25_Y0.3.3mf.3mf

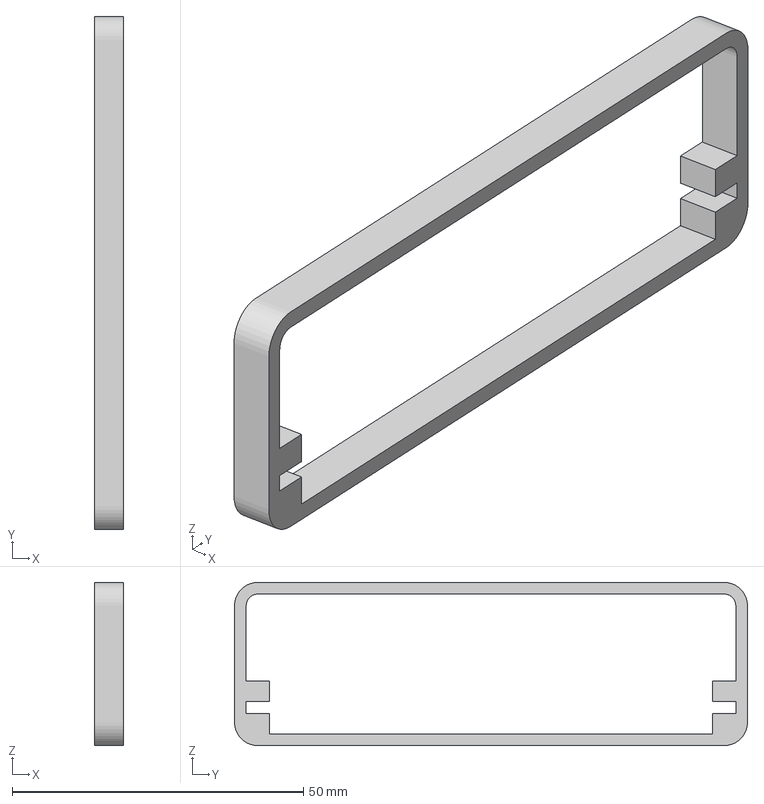
[picture p43: CAD file, 2026-03-12]
Circuit/PrintedCircuit3/ケースチェック3_XZ0.25_Y0.3.3mf.3mf
5.00 x 88.0 x 28.0 mm
