oosan1/OriginalSMU_KKHS/Circuit/PrintedCircuit3/RP2350_Plus_Pin_3D.step

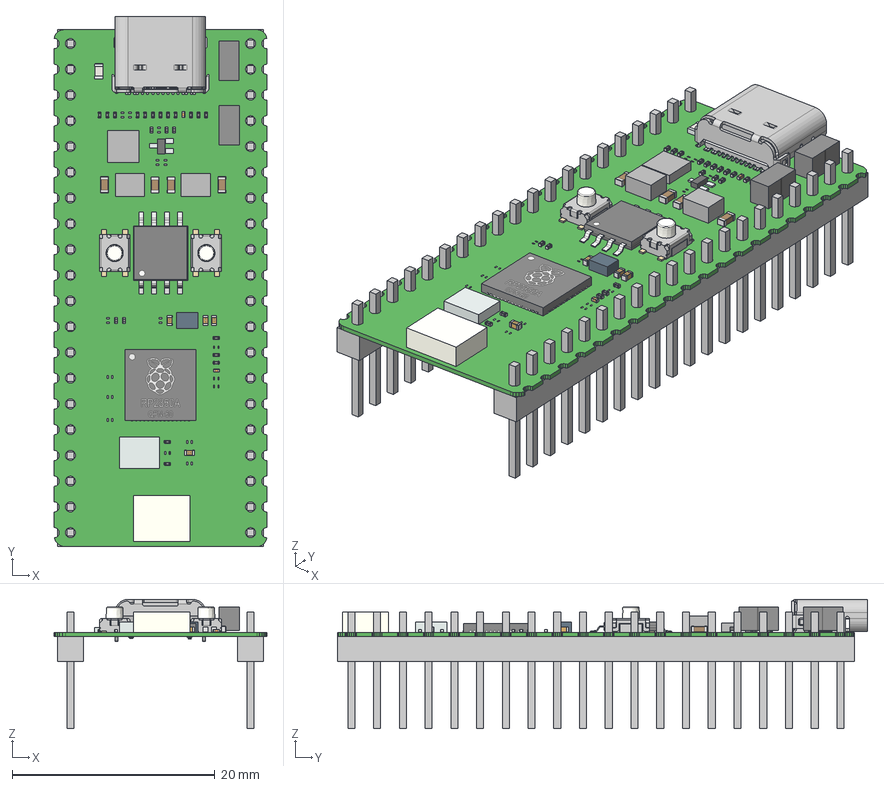
[picture p44: CAD file, 2025-09-23]
Circuit/PrintedCircuit3/RP2350_Plus_Pin_3D.step
21.0 x 52.3 x 12.7 mm
Board
3_1_A x 4
Anschl_X_FCsse_1 x 22
K_X_F6rper_1 x 22
User_Library-Chip_Cap_MLCC_0201_(0603) x 18
Extruded
User_Library-RP2350A
Legs_Seite_2
Legs_Seite_1
Extruded_1
Extruded_2
Extruded_3
Extruded_4
Extruded_5
Extruded_6 x 2
ts-1185ec-a-e-a-1 x 2
Extruded_7 x 2
CAPC1608(0603) x 4
Extruded_8
Extruded_9
Extruded_10 x 2
Extruded_11
