oosan1/OriginalSMU_KKHS/Circuit/PrintedCircuit3/logo.dxf

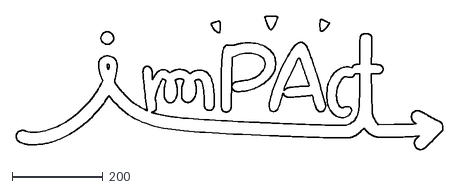
[picture p45: CAD file, 2025-07-14]
Circuit/PrintedCircuit3/logo.dxf
940.3 x 293.9
