oosan1/OriginalSMU_KKHS/Circuit/PrintedCircuit3/switch_3D.step

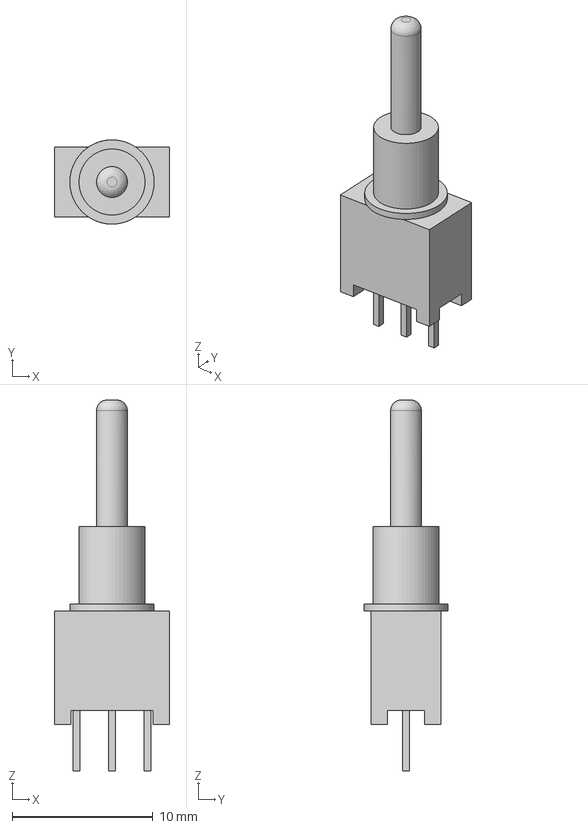
[picture p46: CAD file, 2025-07-12]
Circuit/PrintedCircuit3/switch_3D.step
8.20 x 6.00 x 26.4 mm
