oosan1/OriginalSMU_KKHS/Circuit/PrintedCircuit3/BNC_3D.step

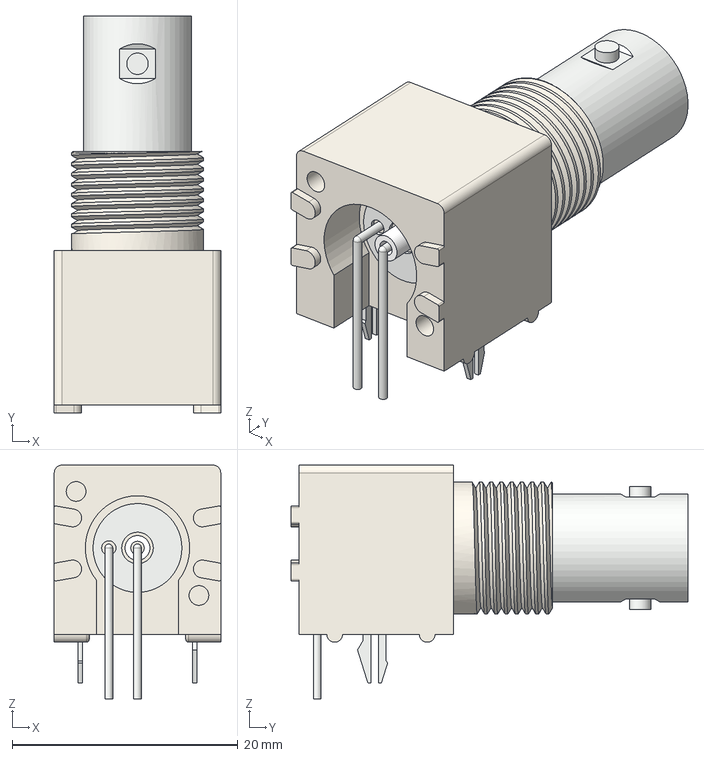
[picture p47: CAD file, 2025-07-12]
Circuit/PrintedCircuit3/BNC_3D.step
14.8 x 35.2 x 20.7 mm
