oosan1/OriginalSMU_KKHS/(list of files, cad)

Other CAD files:
Circuit/PrintedCircuit3/抵抗基盤カバーver3.3mf
Circuit/PrintedCircuit3/ケース_メイン_ver3.3mf
Circuit/PrintedCircuit3/足テスト_r5.2_d0.5.3mf
Case/SMU_case_2.3mf
Case/SMU_case_1.3mf
Circuit/PrintedCircuit3/ケースチェック2_XZ0.25_Y0.26.3mf
Case/old/ケース_メイン_ver1.3mf
Case/old/ケース_メイン_ver2.3mf
Case/old/ケース_メイン_ver3.3mf
Case/old/ケース_側面_ver1.3mf
Case/old/ケース_側面_ver3.3mf
Case/old/ケースチェック2_XZ0.25_Y0.26.3mf
Case/old/抵抗基盤カバーver1.3mf
Case/old/抵抗基盤カバーver2.3mf
Case/old/抵抗基盤カバーver3.3mf
Case/old/足テスト_r5.2_d0.5.3mf
Case/v2_case_huta.3mf
Case/v2_case_top.3mf
Case/v2_case_under.3mf
Case/v3_case_huta.3mf
Circuit/PrintedCircuit3/73100-0131.STEP
Circuit/PrintedCircuit3/TLP241A_F/DIP4_90deg.stl
Circuit/PrintedCircuit3/ケース_メイン_ver1.3mf
Circuit/PrintedCircuit3/ケース_メイン_ver2.3mf
Circuit/PrintedCircuit3/ケース_側面_ver1.3mf
Circuit/PrintedCircuit3/ケース_側面_ver3.3mf
Circuit/PrintedCircuit3/抵抗基盤カバーver1.3mf
Circuit/PrintedCircuit3/抵抗基盤カバーver2.3mf
Circuit/old/PrintedCircuit2/SMU/TLP241A_F/DIP4_90deg.stl
Circuit/old/PrintedCircuit2/SMU2/TLP241A_F/DIP4_90deg.stl
Circuit/old/PrintedCircuit2/SMU3/73100-0131.STEP
Circuit/old/PrintedCircuit2/SMU3/SMU.step
Circuit/old/PrintedCircuit2/SMU3/TLP241A_F/DIP4_90deg.stl
old/Case/SMU_case_1.3mf
old/Case/SMU_case_2.3mf
old/Case/v2_case_huta.3mf
old/Case/v2_case_top.3mf
old/Case/v2_case_under.3mf
old/Case/v3_case_huta.3mf
