oosan1/OriginalSMU_KKHS/Circuit/PrintedCircuit3/unnamed.jpg

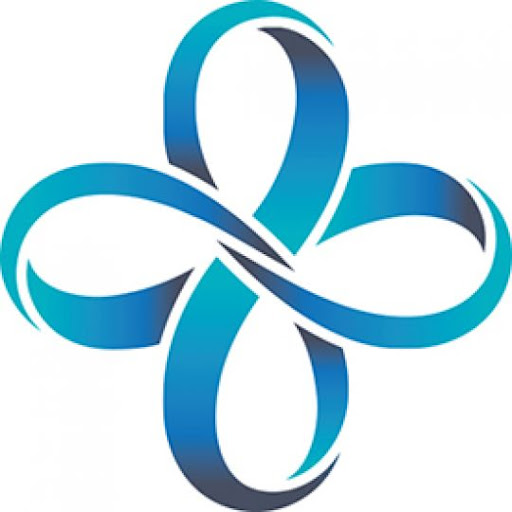
Circuit/PrintedCircuit3/unnamed.jpg
