oosan1/OriginalSMU_KKHS/User_Manual/HTML/IMG_2924.png

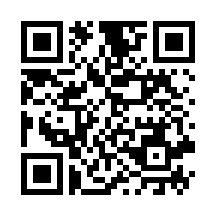
User_Manual/HTML/IMG_2924.png
