oosan1/OriginalSMU_KKHS/User_Manual/HTML/ソフト_connection.png

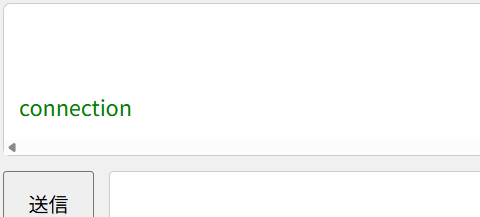
User_Manual/HTML/ソフト_connection.png
