oosan1/OriginalSMU_KKHS/User_Manual/HTML/ソフト_csv保存.png

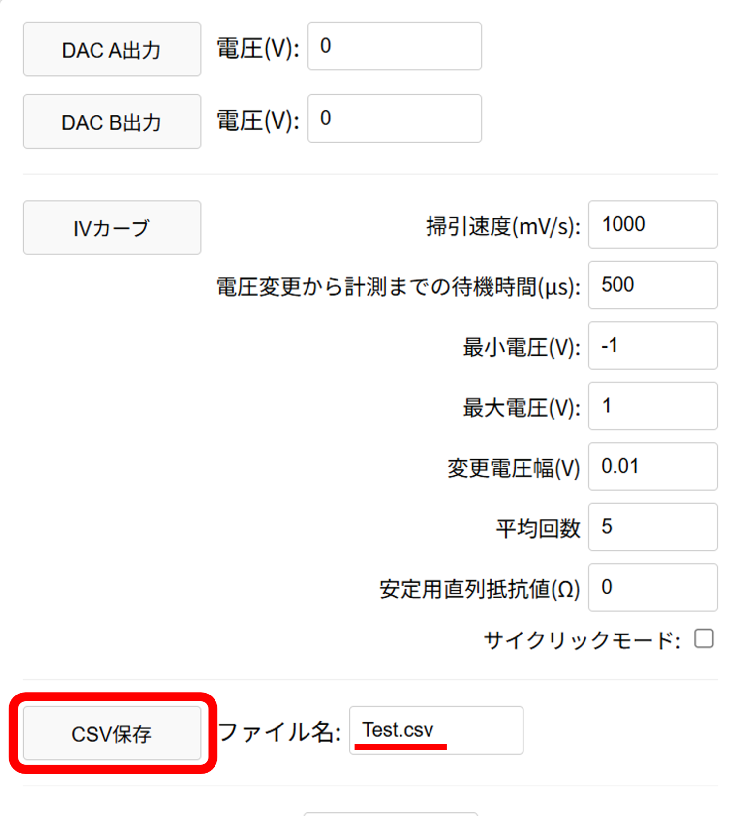
User_Manual/HTML/ソフト_csv保存.png
