oosan1/OriginalSMU_KKHS/User_Manual/HTML/ソフト_disconnection.png

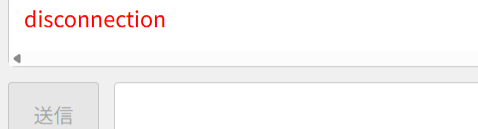
User_Manual/HTML/ソフト_disconnection.png
