oosan1/OriginalSMU_KKHS/User_Manual/HTML/ソフト_IVカーブ_結果確認.png

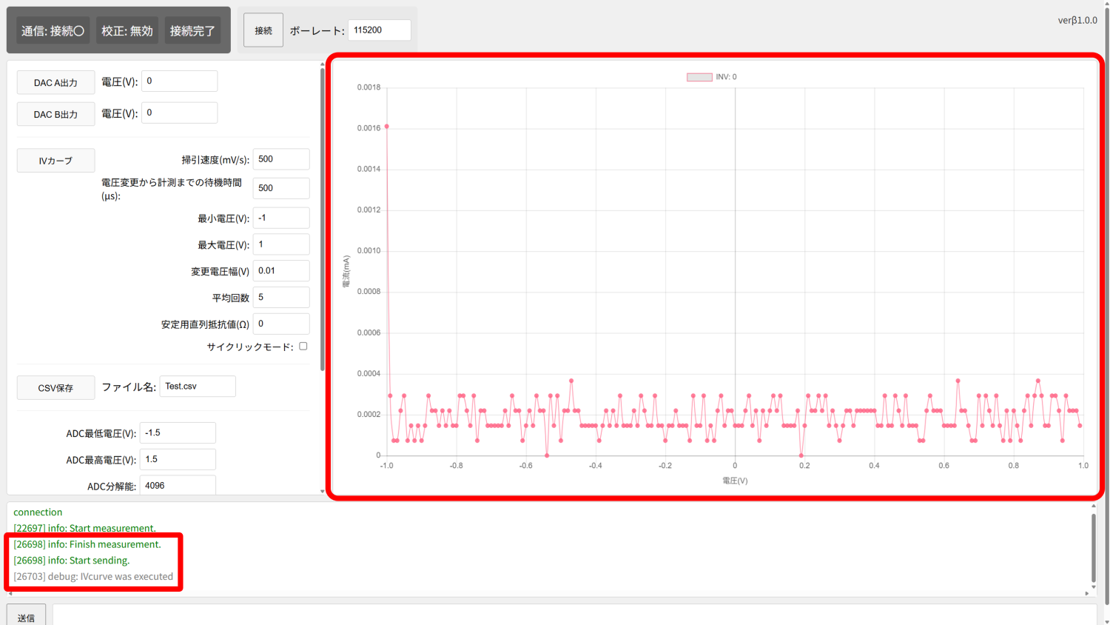
User_Manual/HTML/ソフト_IVカーブ_結果確認.png
