oosan1/OriginalSMU_KKHS/User_Manual/HTML/ソフト_IVカーブをクリック.png

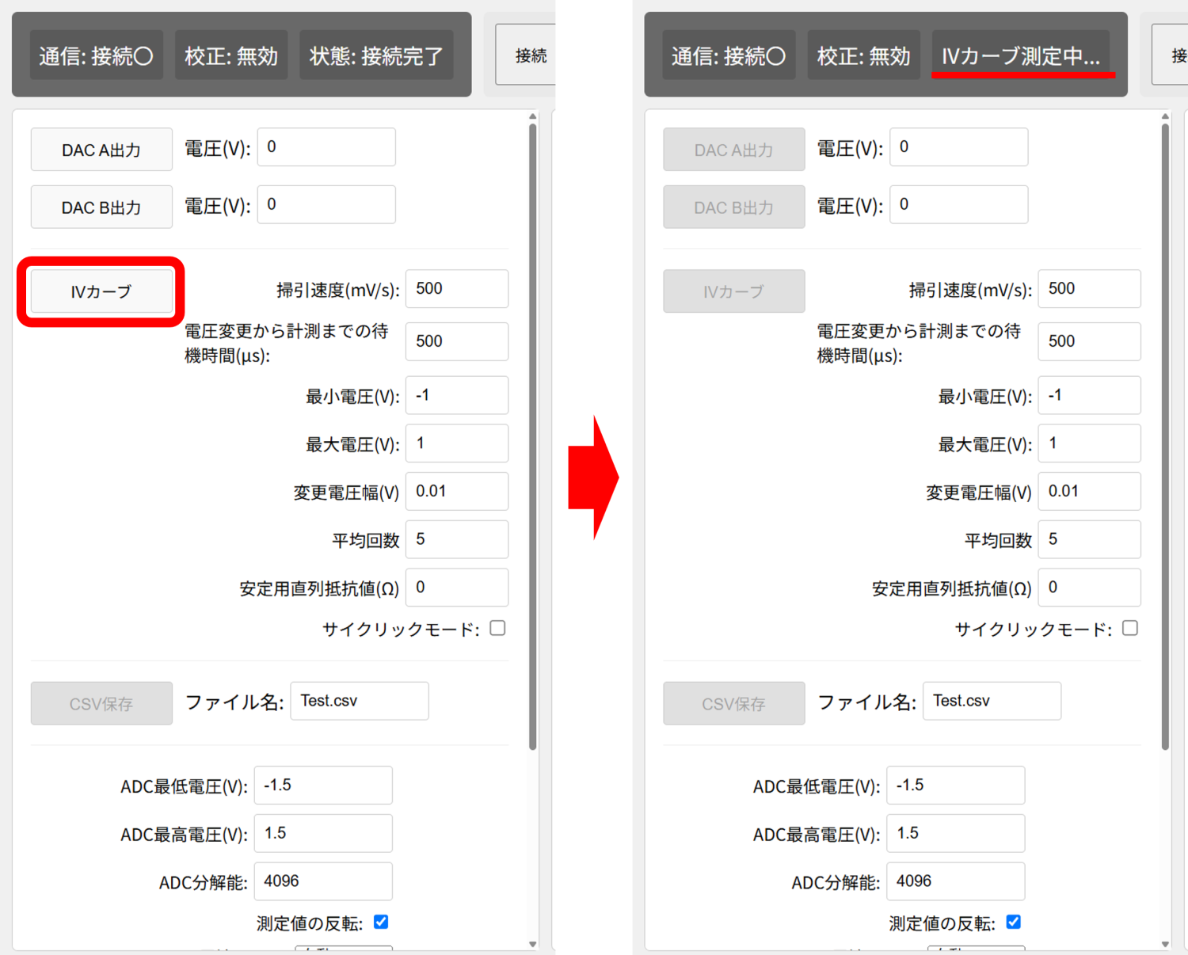
User_Manual/HTML/ソフト_IVカーブをクリック.png
