oosan1/OriginalSMU_KKHS/User_Manual/HTML/ソフト_シリアル通信の許可.png

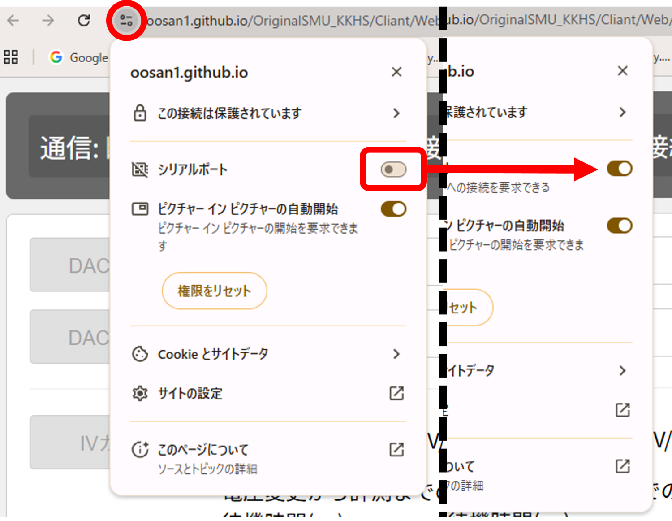
User_Manual/HTML/ソフト_シリアル通信の許可.png
