oosan1/OriginalSMU_KKHS/User_Manual/HTML/ソフト_同時接続エラー.png

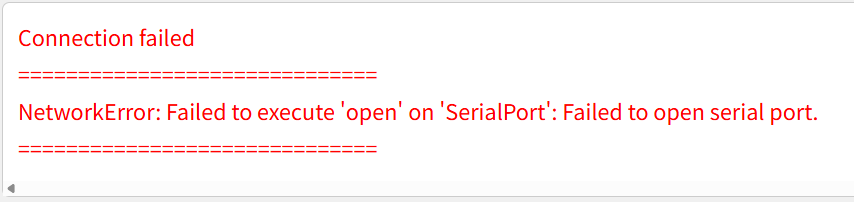
User_Manual/HTML/ソフト_同時接続エラー.png
