oosan1/OriginalSMU_KKHS/User_Manual/HTML/ソフト_接続ダイアログ.png

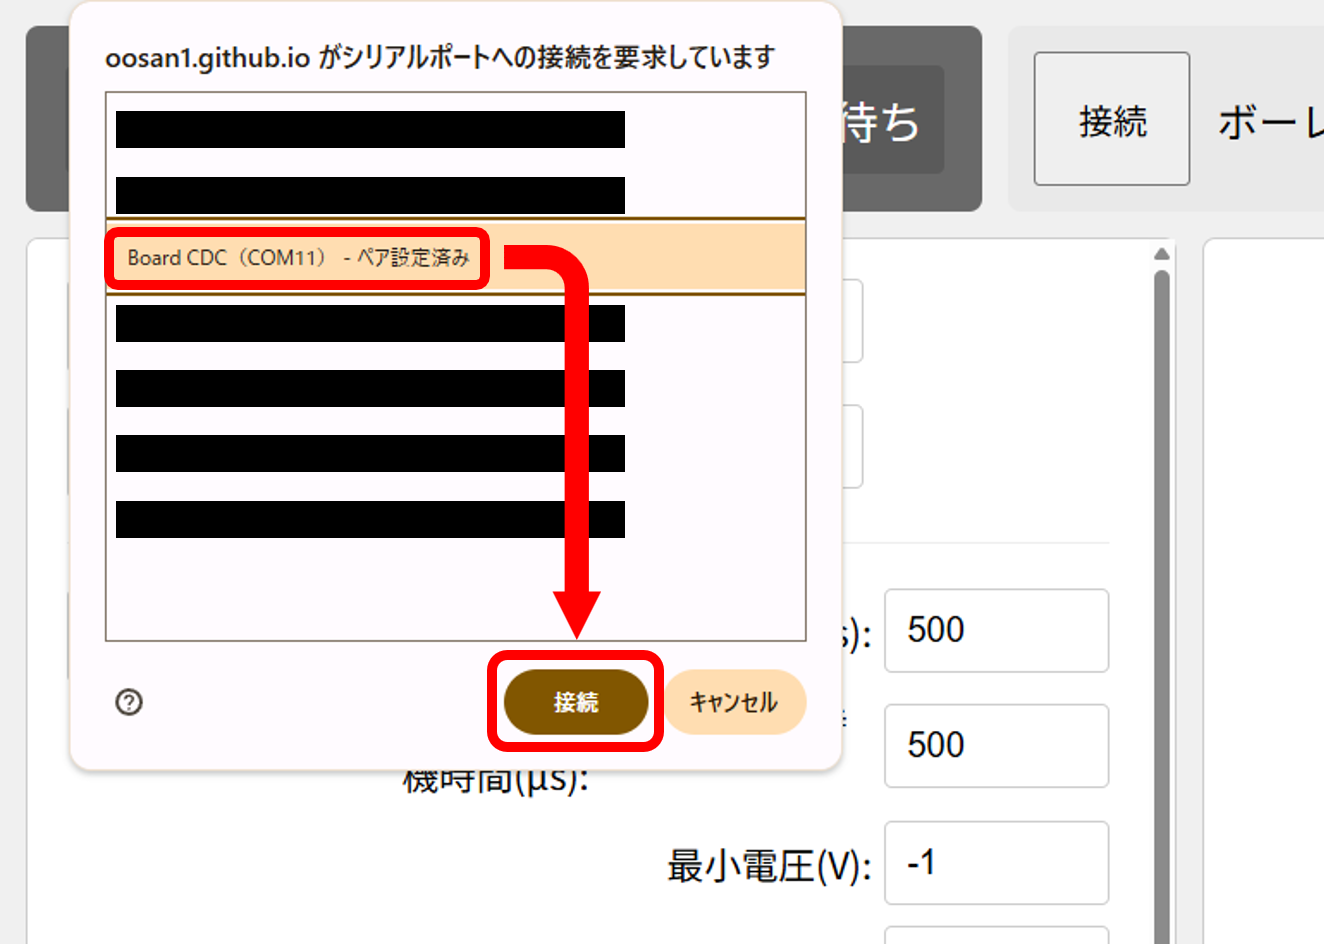
User_Manual/HTML/ソフト_接続ダイアログ.png
