oosan1/OriginalSMU_KKHS/User_Manual/HTML/ソフト_接続ボタン.png

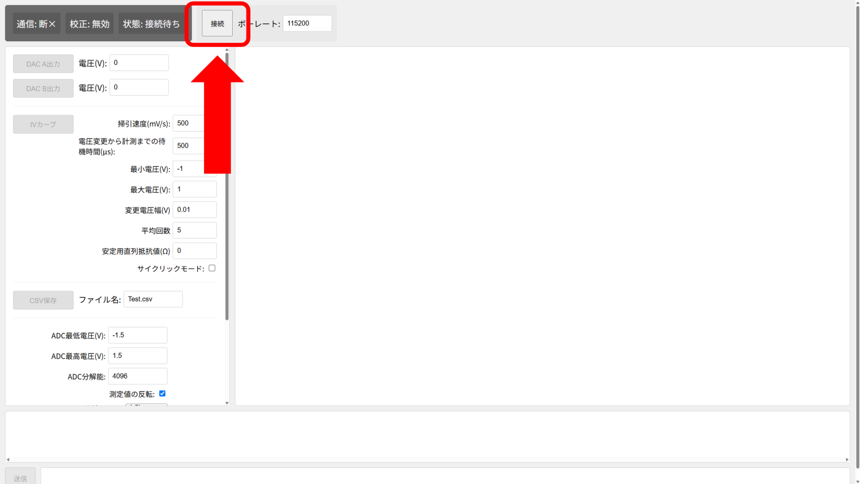
User_Manual/HTML/ソフト_接続ボタン.png
