oosan1/OriginalSMU_KKHS/User_Manual/HTML/ソフト_権限エラー.png

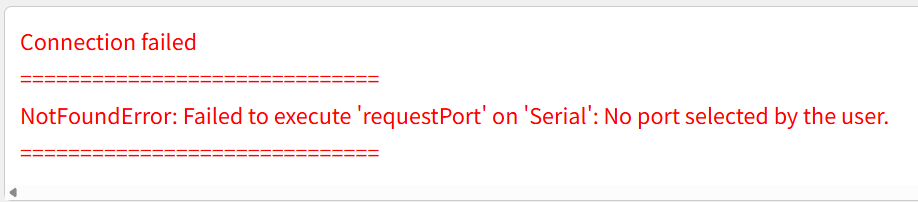
User_Manual/HTML/ソフト_権限エラー.png
