oosan1/OriginalSMU_KKHS/User_Manual/HTML/ソフト_画面構成.png

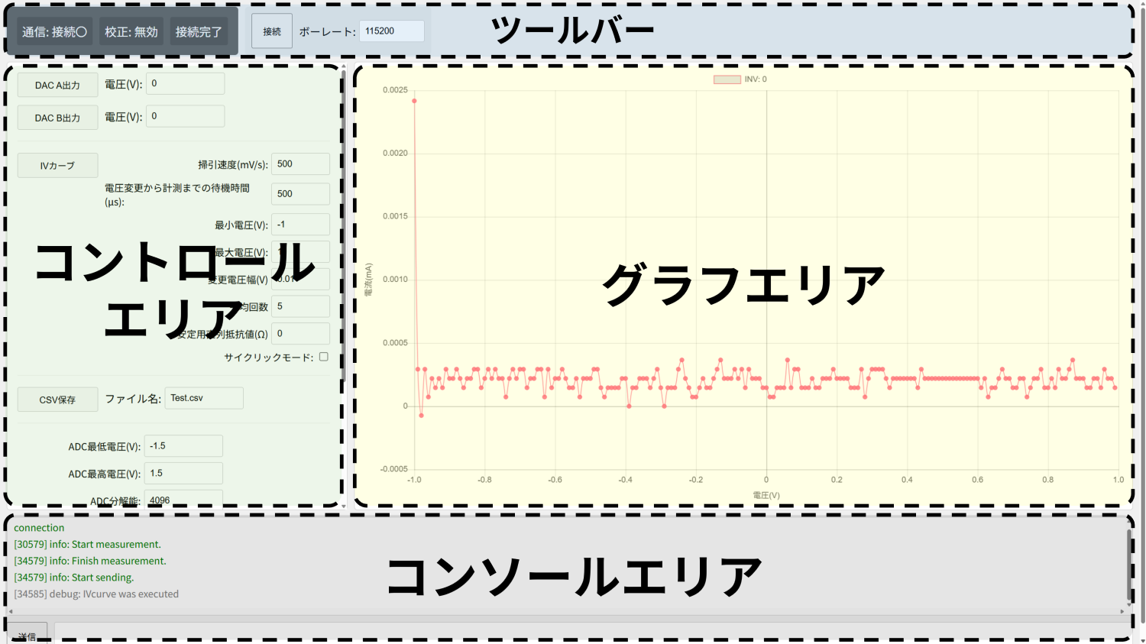
User_Manual/HTML/ソフト_画面構成.png
