oosan1/OriginalSMU_KKHS/User_Manual/HTML/テクニカル_BNCナットの差し込み.png

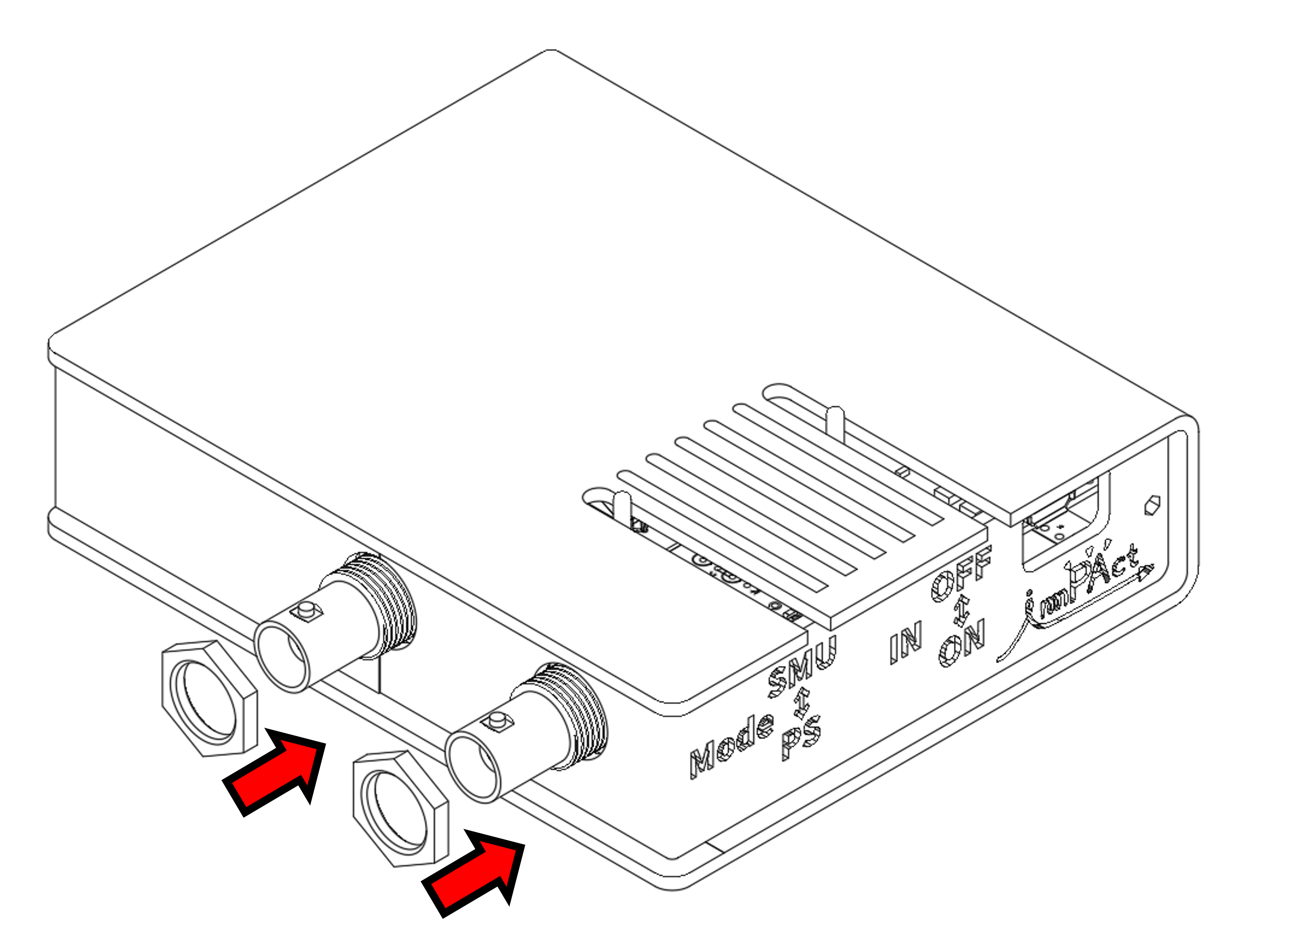
User_Manual/HTML/テクニカル_BNCナットの差し込み.png
