oosan1/OriginalSMU_KKHS/User_Manual/HTML/テクニカル_基盤の差し込み.png

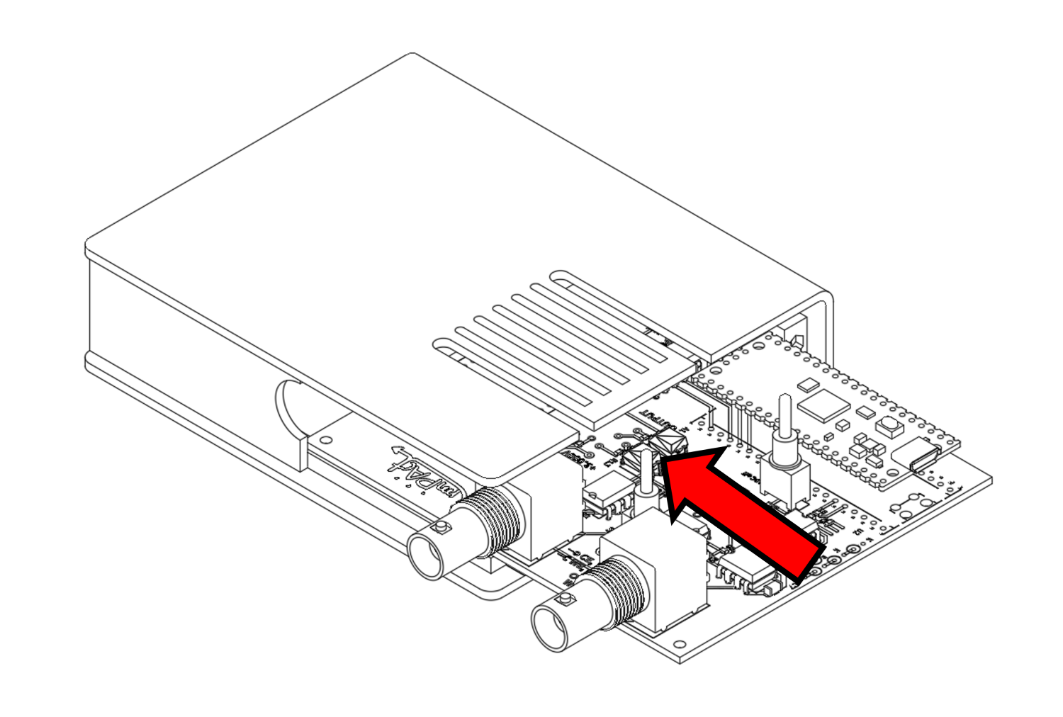
User_Manual/HTML/テクニカル_基盤の差し込み.png
