oosan1/OriginalSMU_KKHS/User_Manual/HTML/上面パネル.png

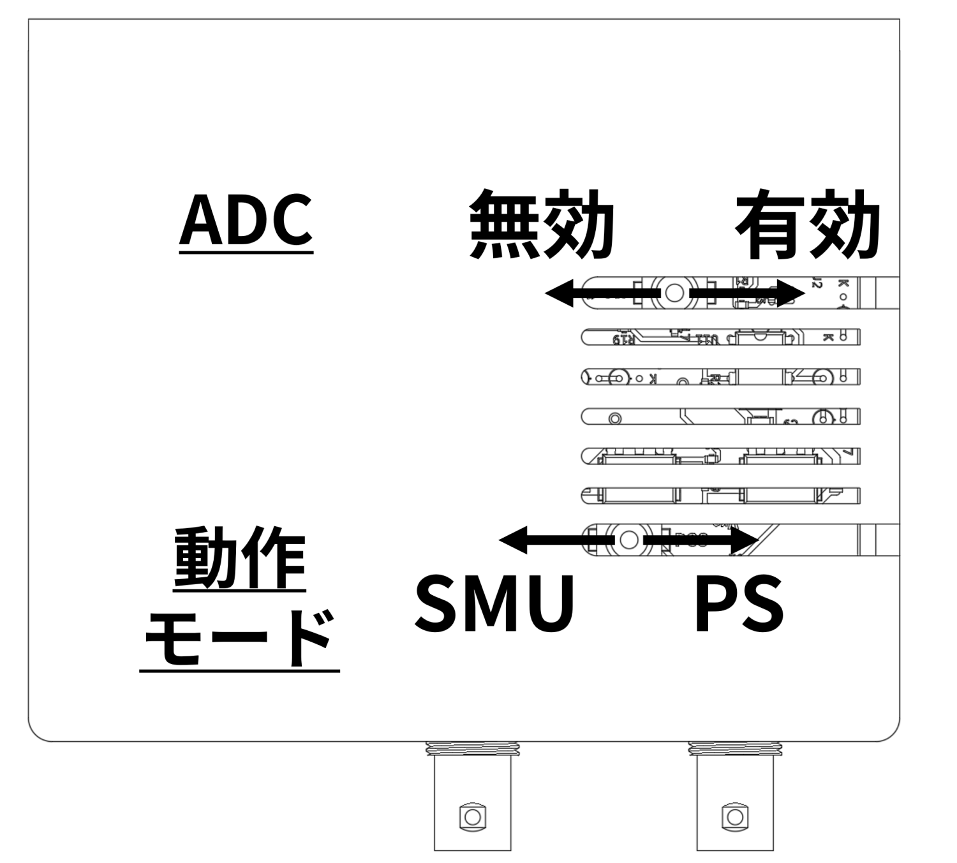
User_Manual/HTML/上面パネル.png
