oosan1/OriginalSMU_KKHS/User_Manual/HTML/前面パネル.png

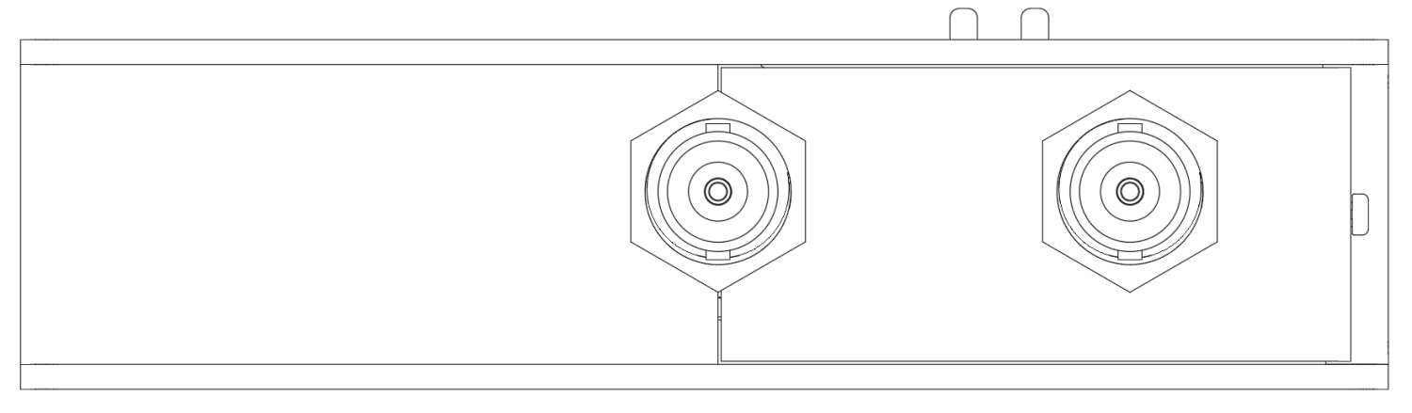
User_Manual/HTML/前面パネル.png
