oosan1/OriginalSMU_KKHS/User_Manual/HTML/前面パネル_PSモード.png

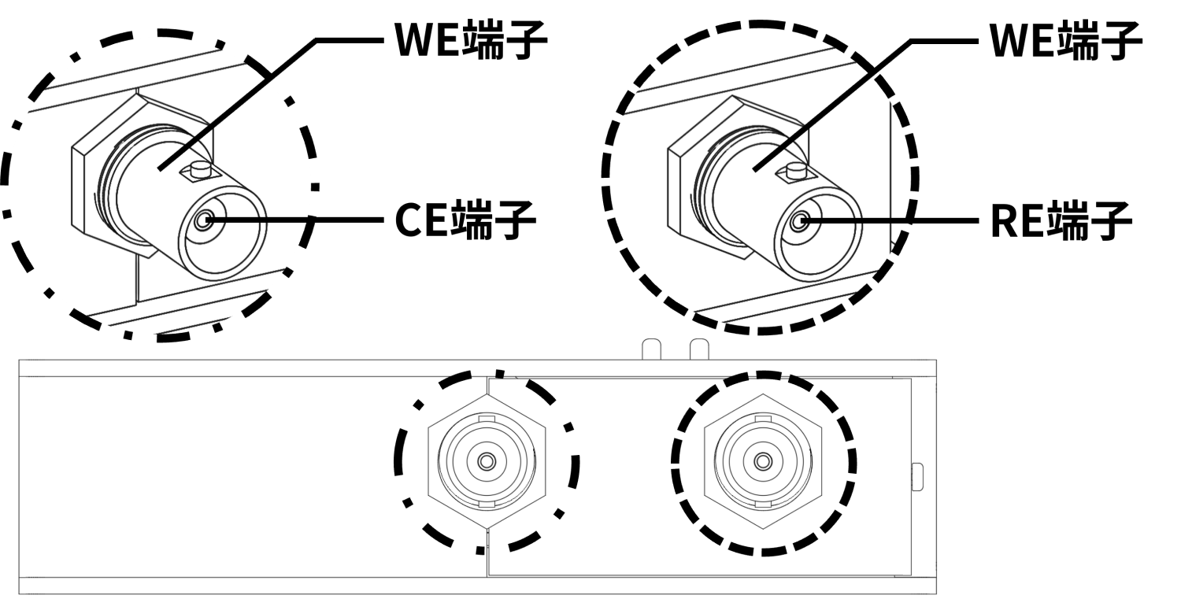
User_Manual/HTML/前面パネル_PSモード.png
