oosan1/OriginalSMU_KKHS/User_Manual/HTML/前面パネル_SMUモード.png

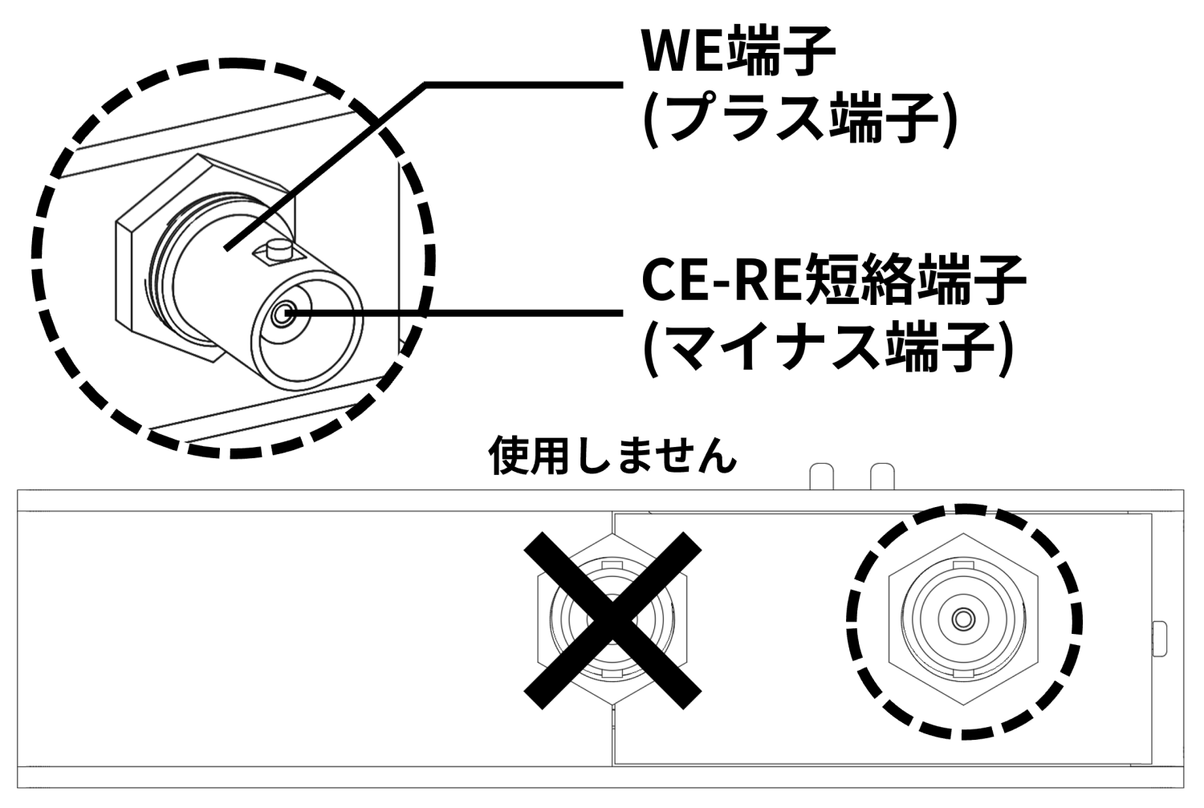
User_Manual/HTML/前面パネル_SMUモード.png
