oosan1/OriginalSMU_KKHS/User_Manual/HTML/右面パネル.png

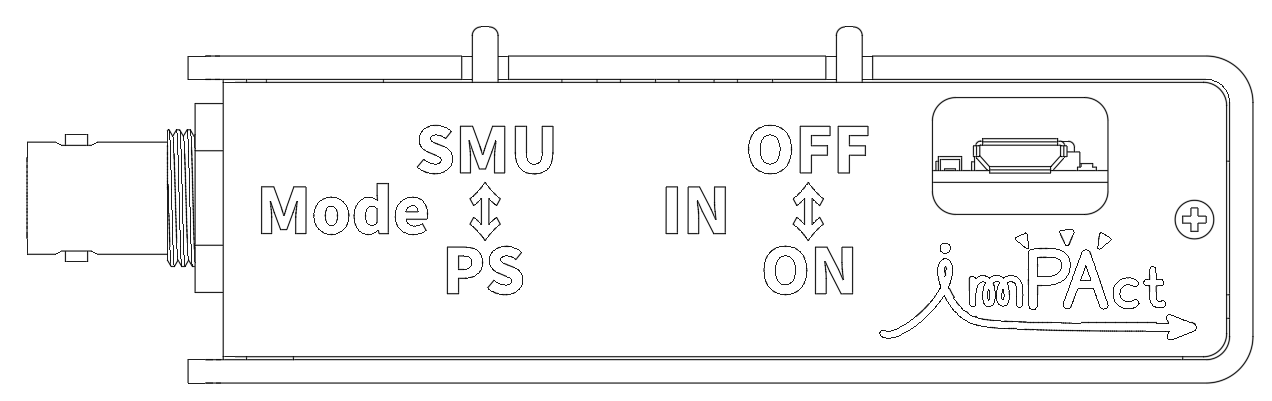
User_Manual/HTML/右面パネル.png
