oosan1/OriginalSMU_KKHS/User_Manual/HTML/抵抗基盤_取り付け方.jpg

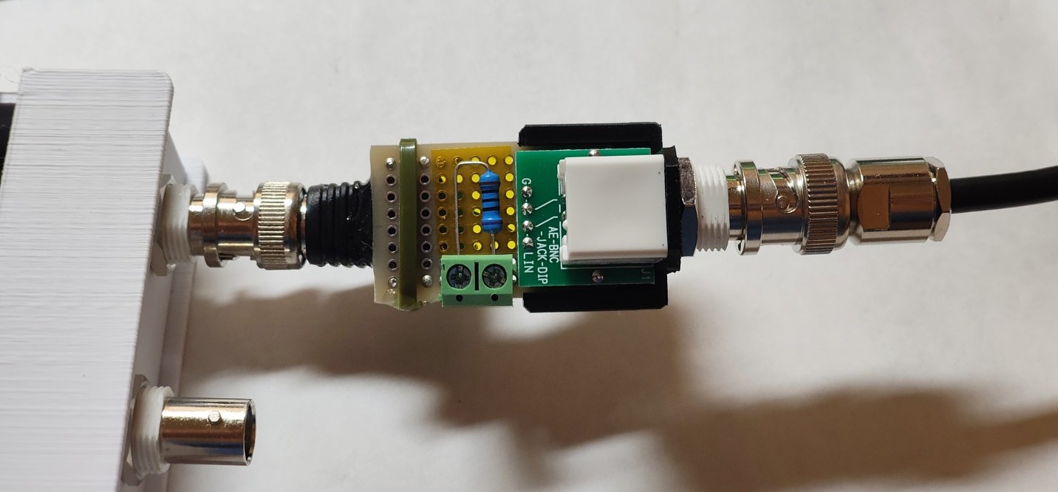
User_Manual/HTML/抵抗基盤_取り付け方.jpg
