oosan1/OriginalSMU_KKHS/User_Manual/PDF/IMPACT_取扱説明書.pdf

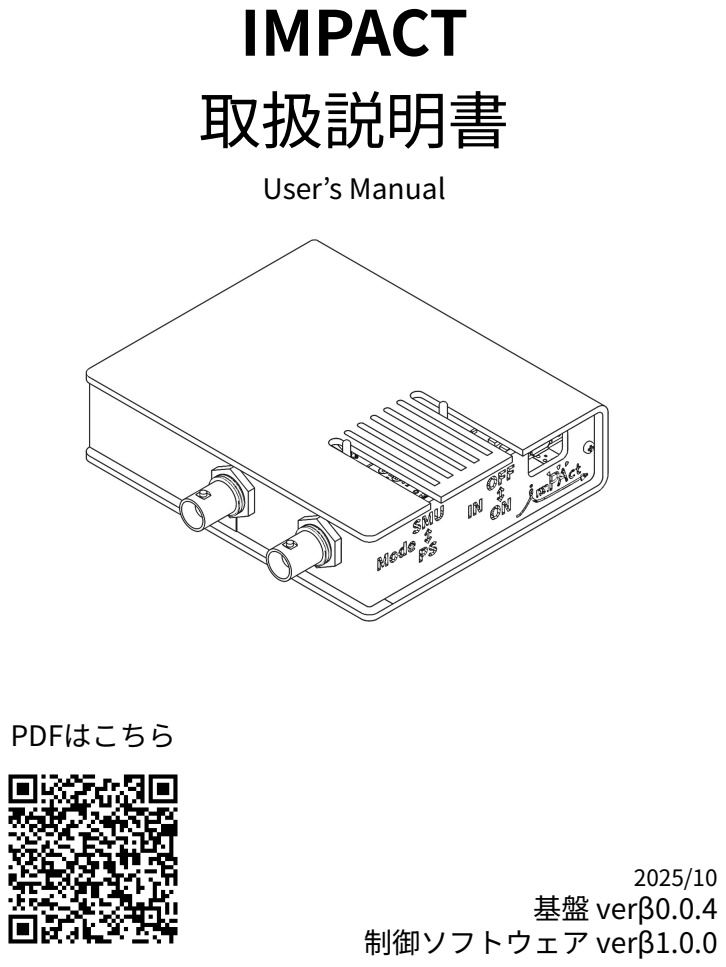
[picture p71: page 1]
2025/10 基盤 verβ0.0.4 制御ソフトウェア verβ1.0.0; User’s Manual; PDFはこちら

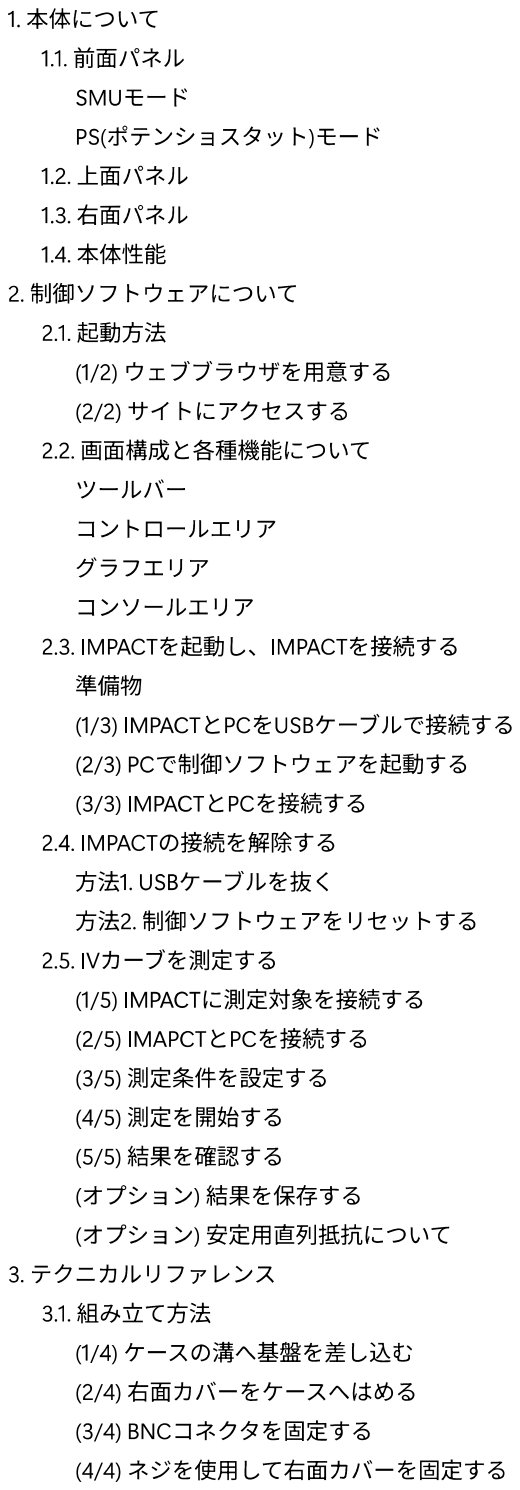
[picture p72: page 2]

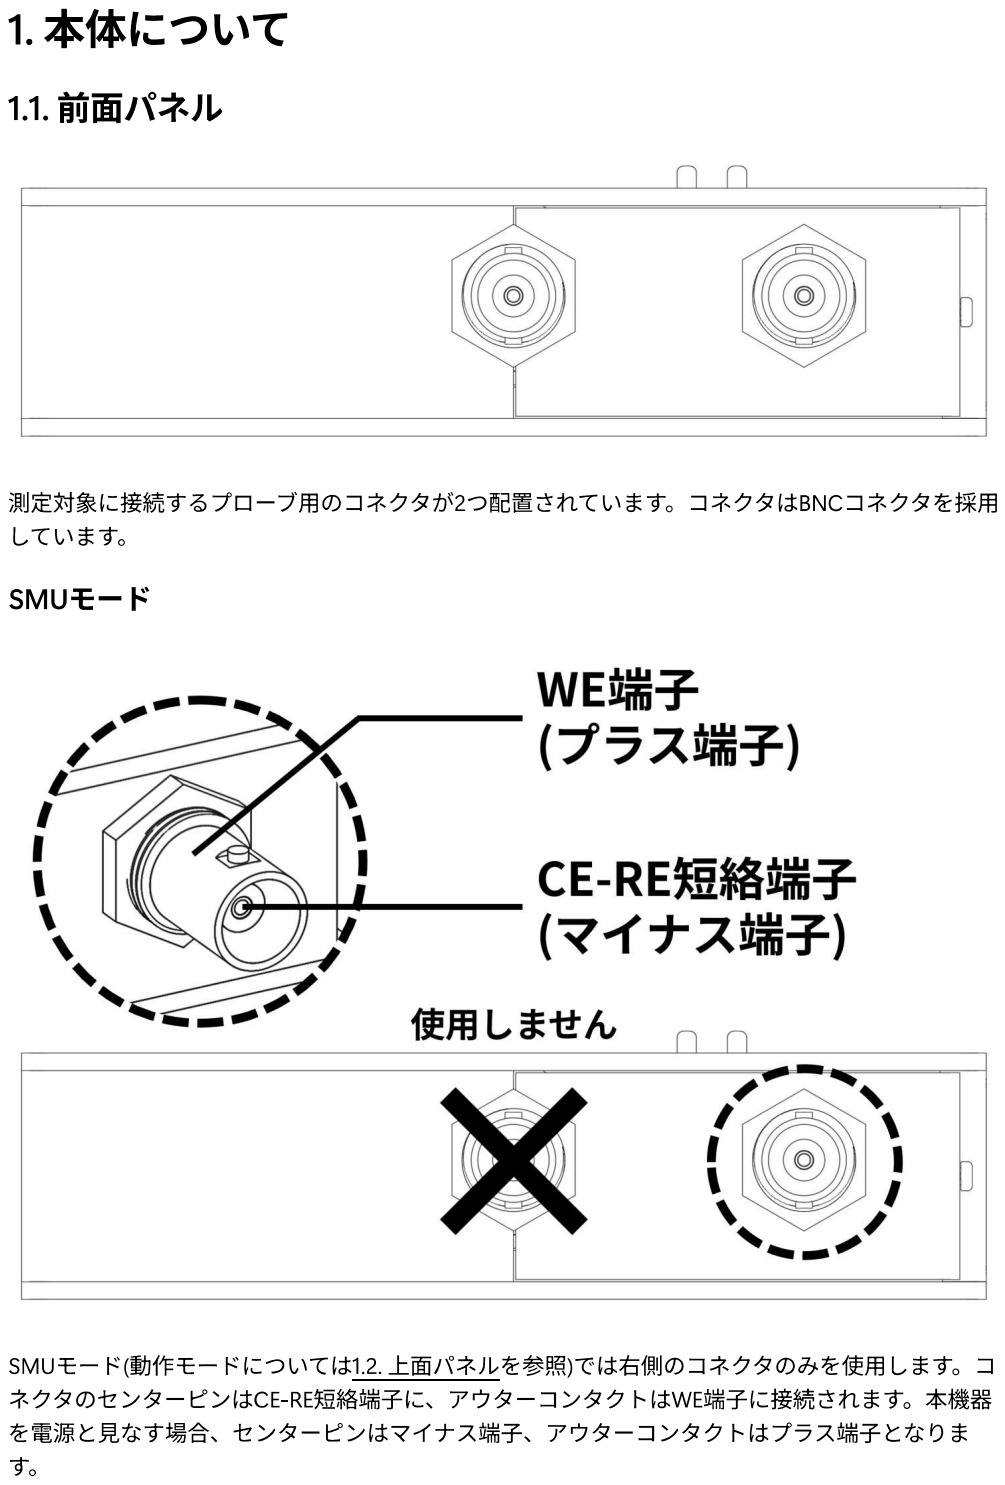
[picture p73: page 3]

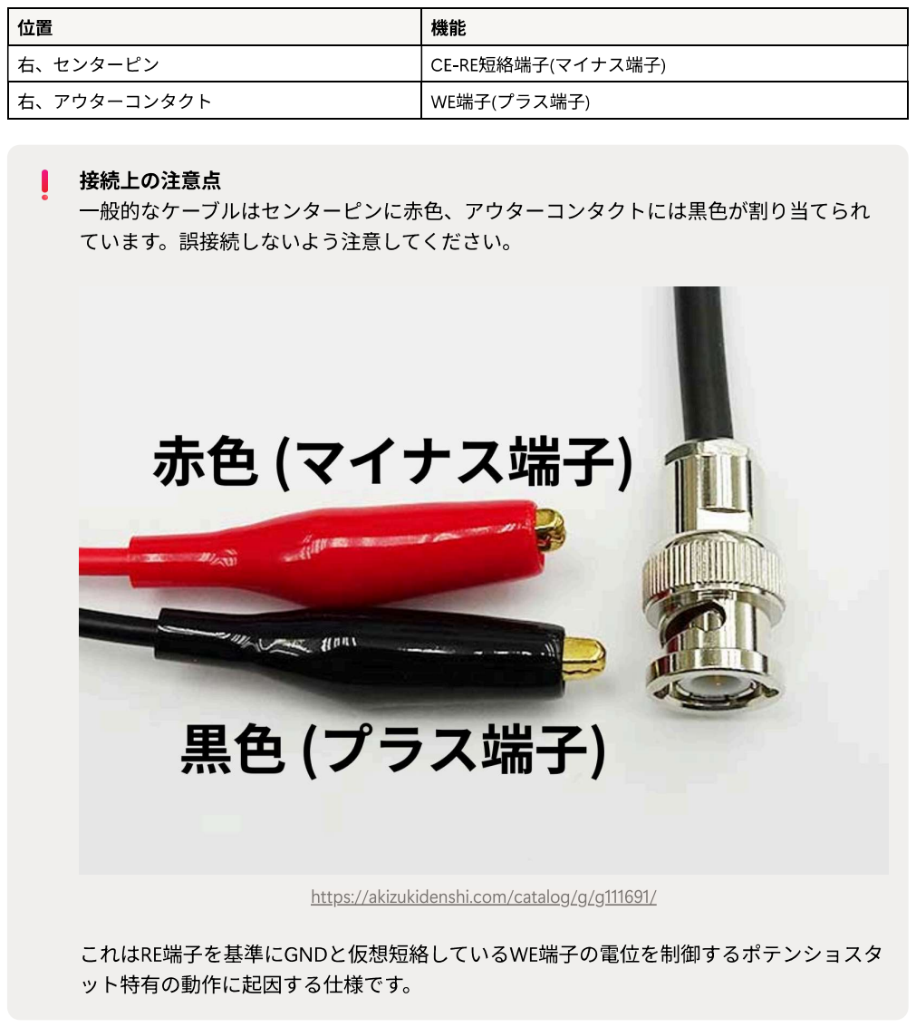
[picture p74: page 4]

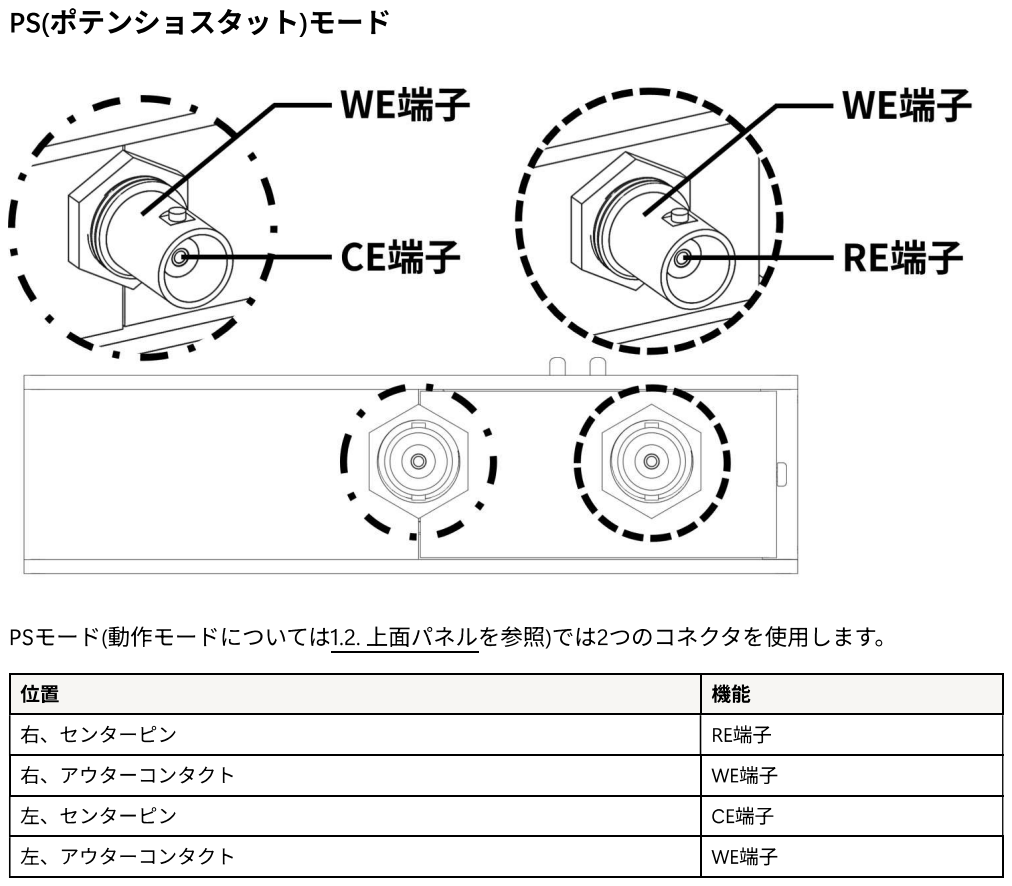
[picture p75: page 5]

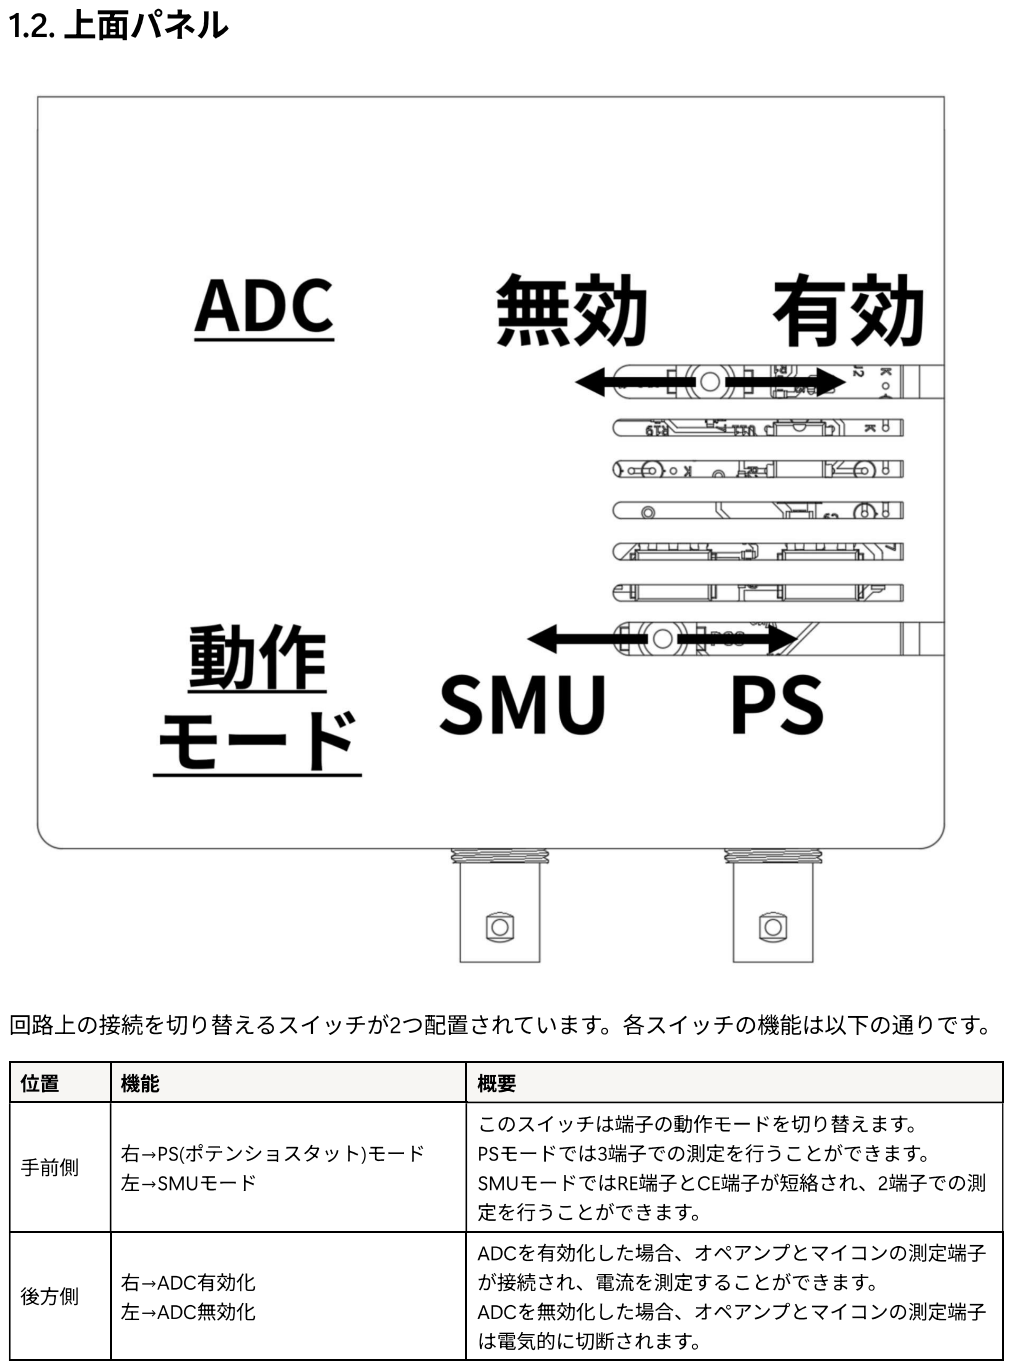
[picture p76: page 6]

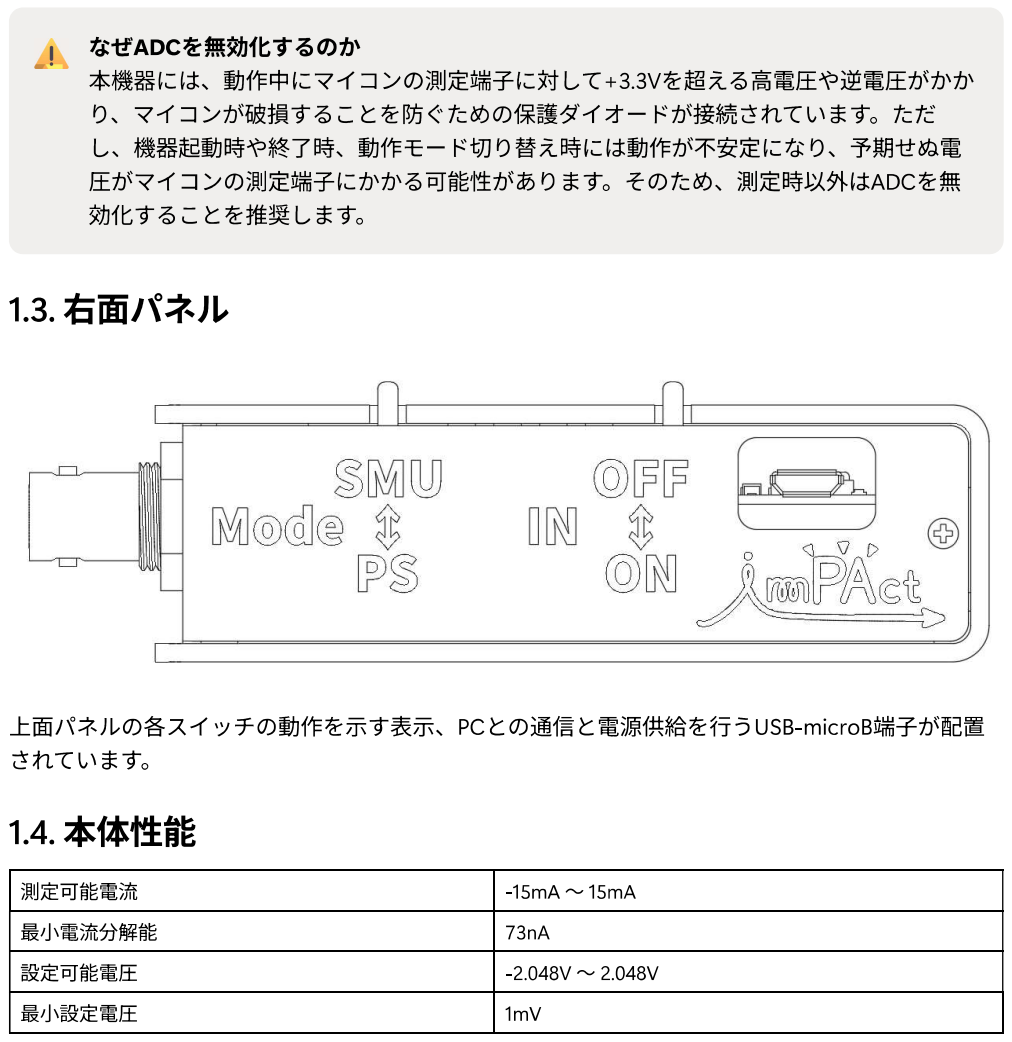
[picture p77: page 7]

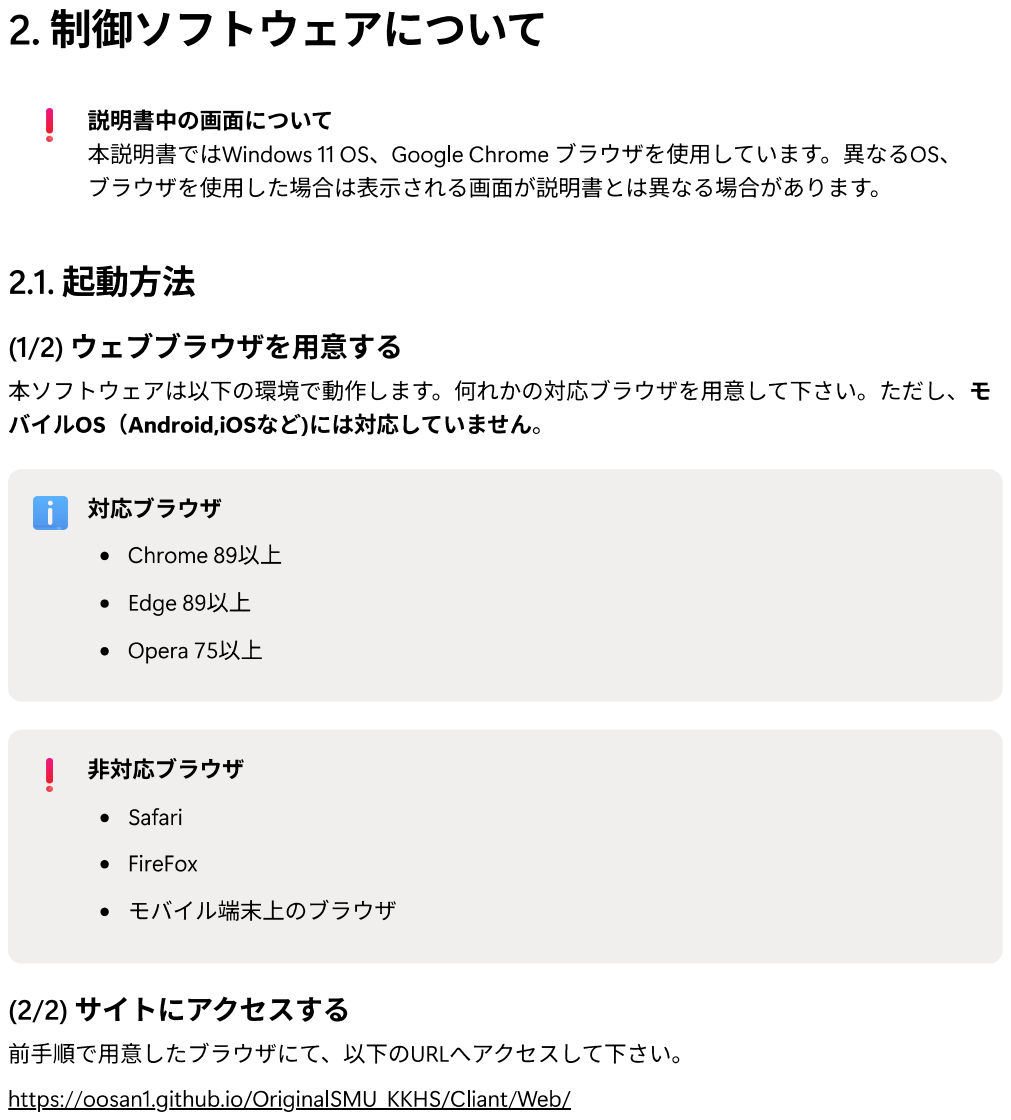
[picture p78: page 8]

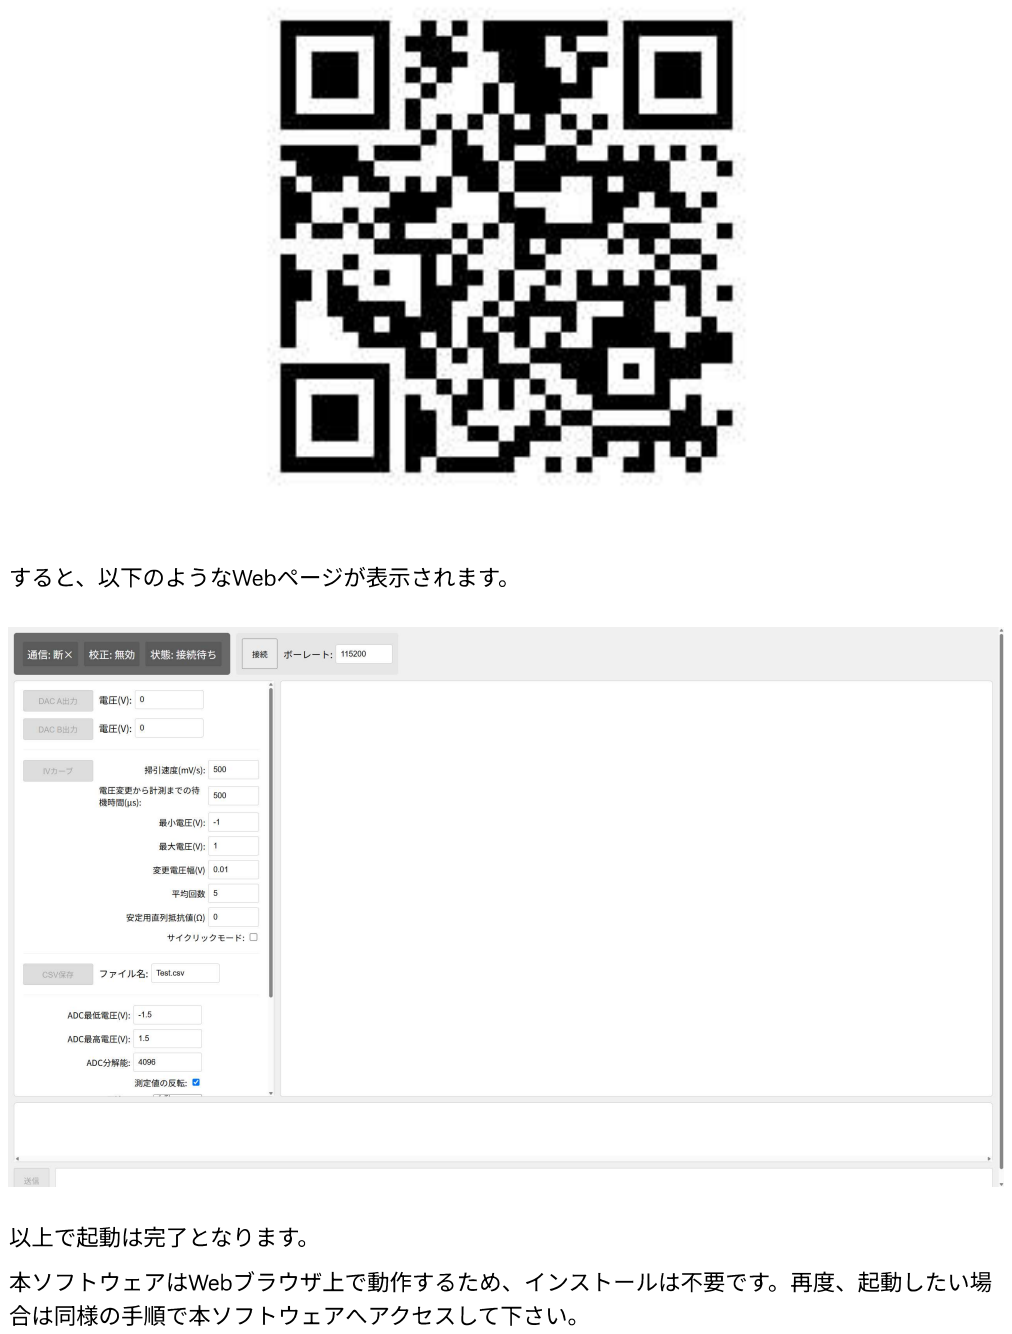
[picture p79: page 9]

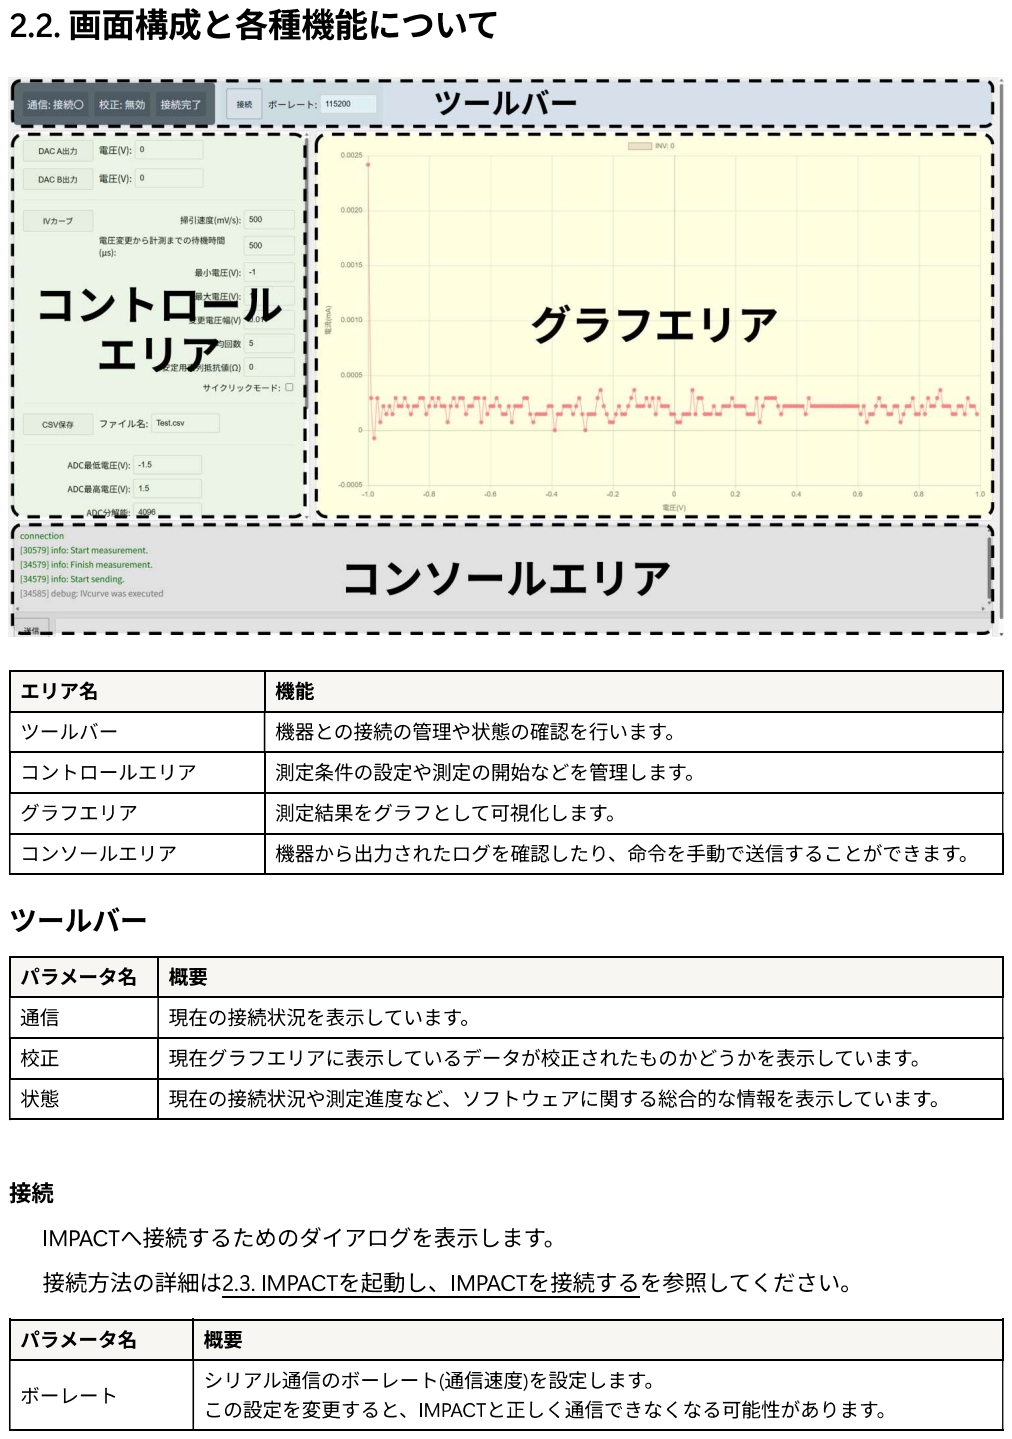
[picture p80: page 10]

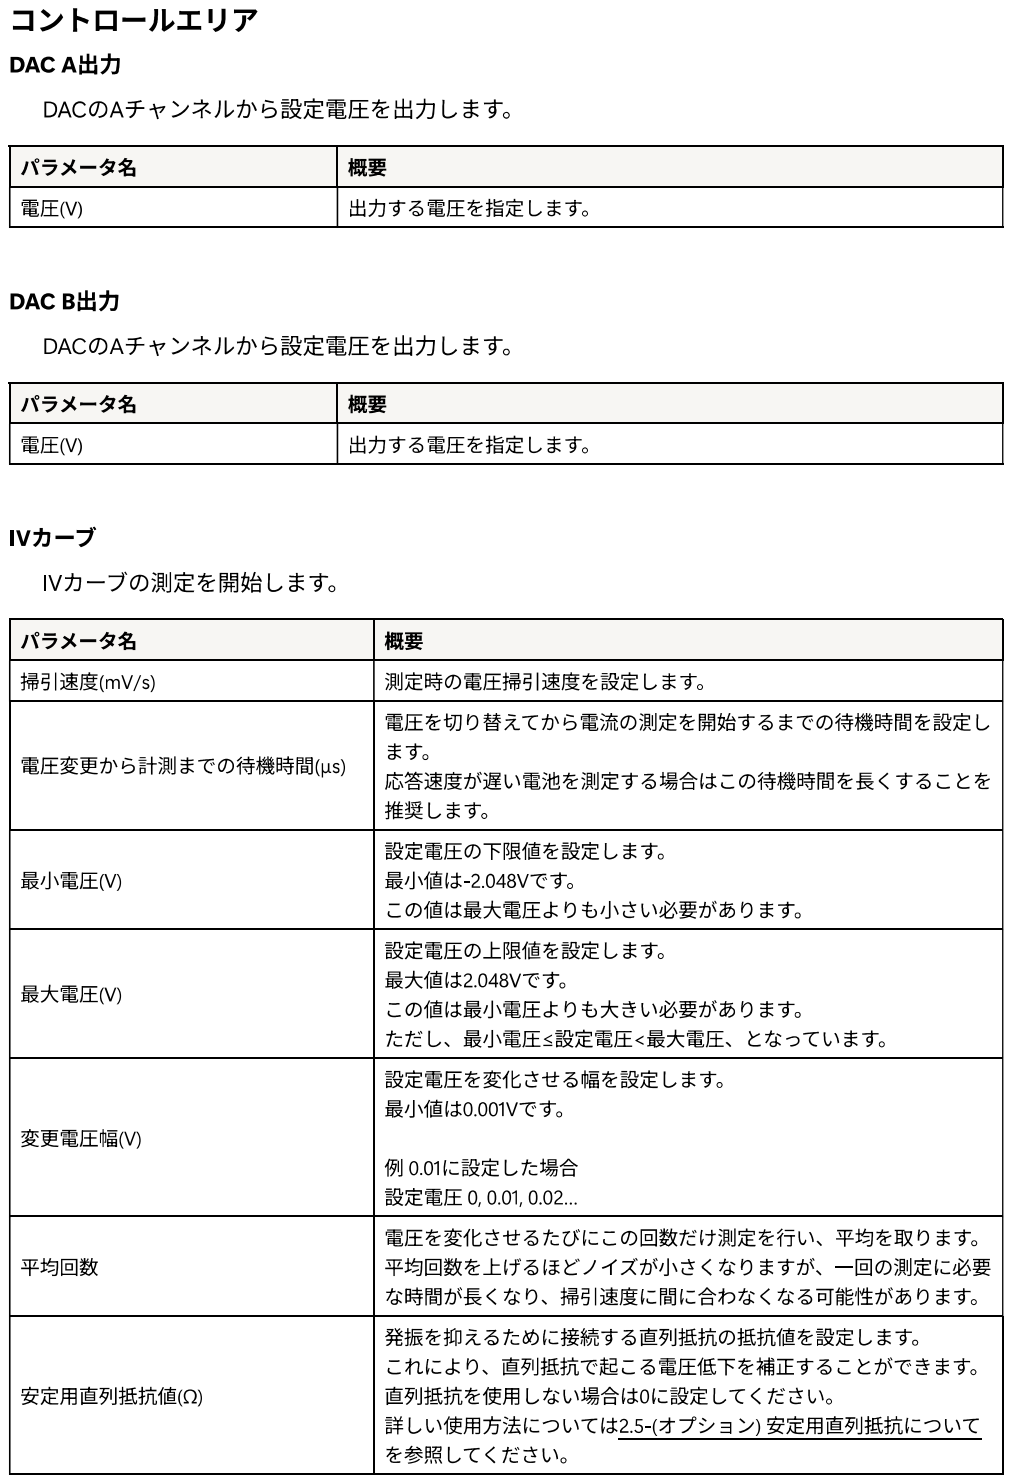
[picture p81: page 11]

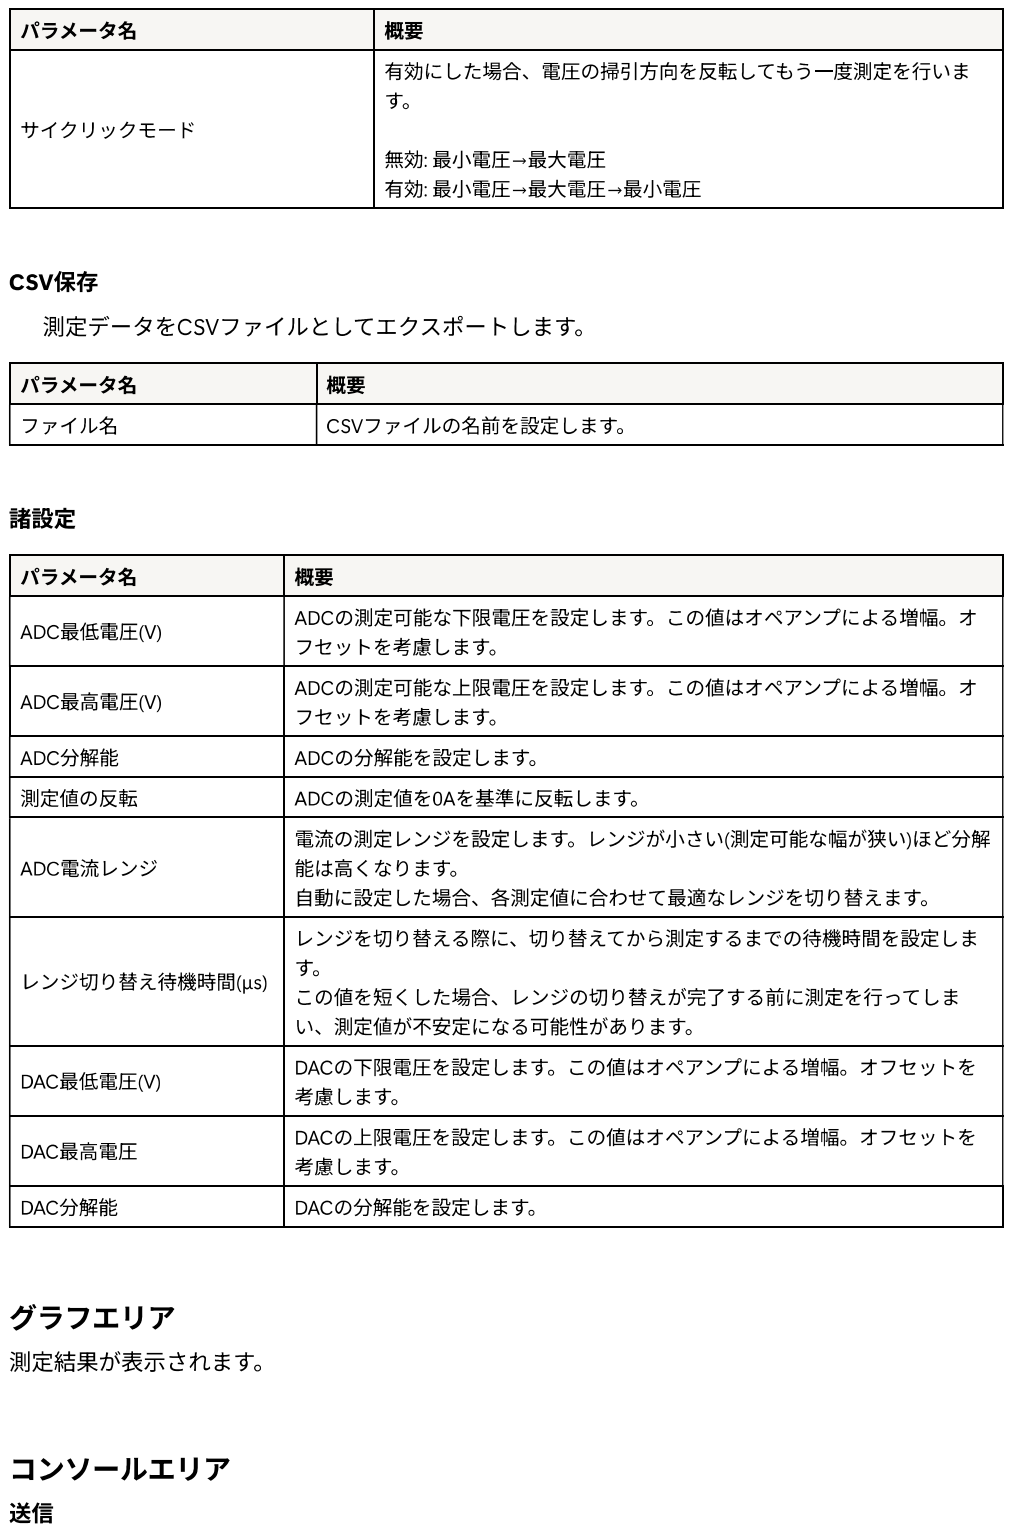
[picture p82: page 12]

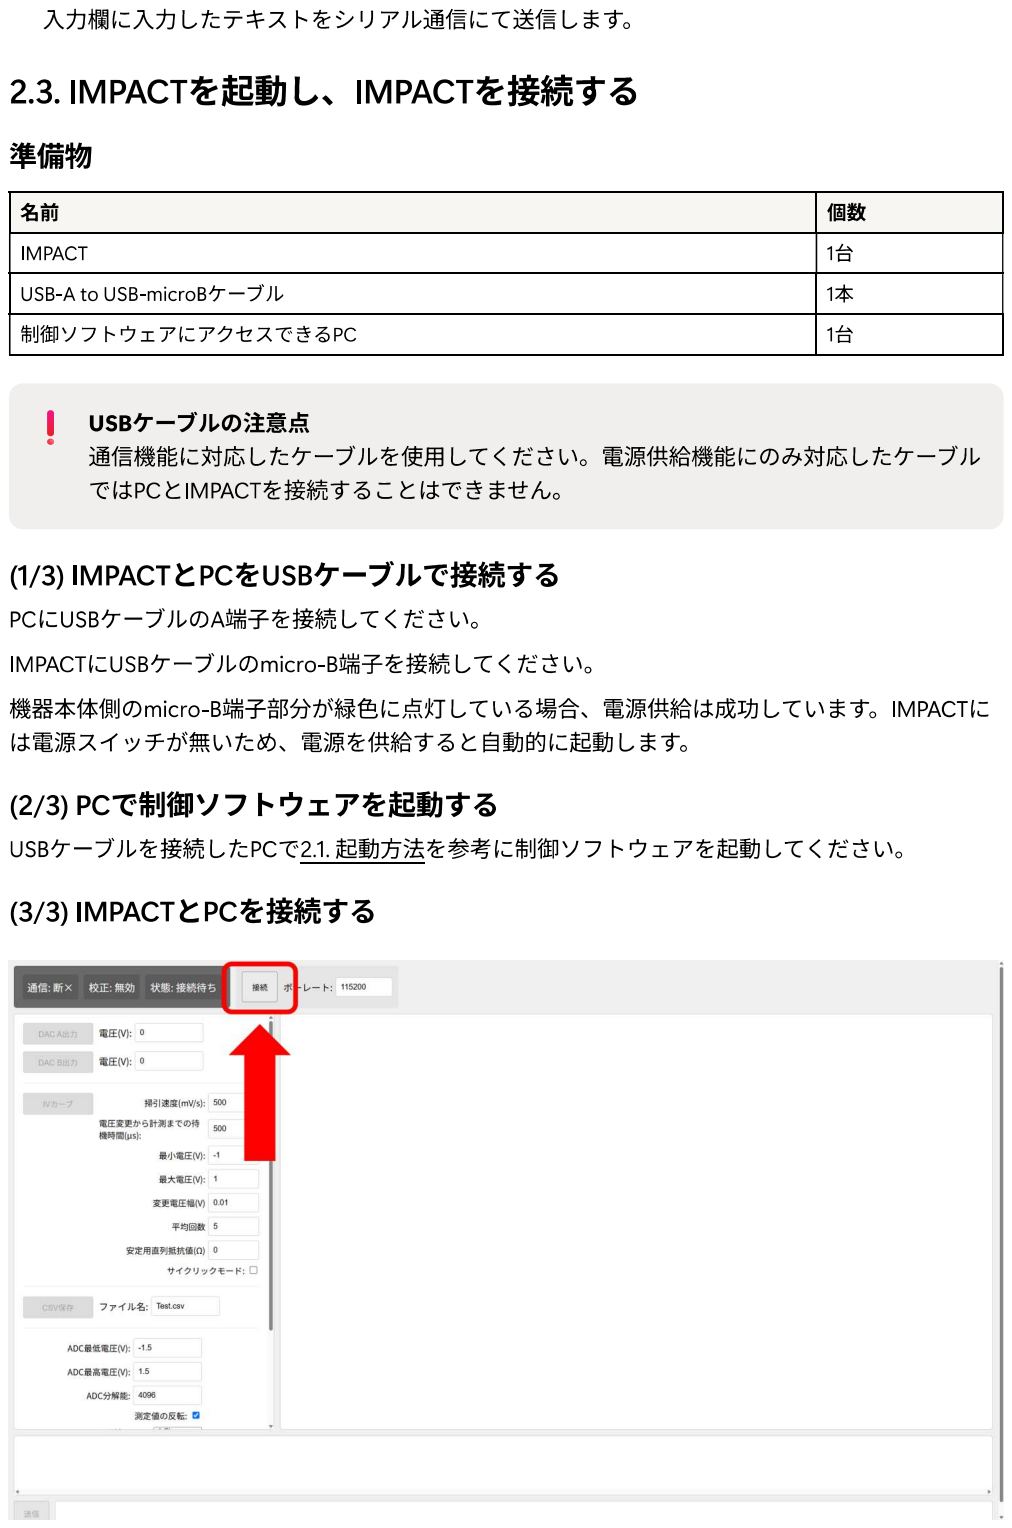
[picture p83: page 13]

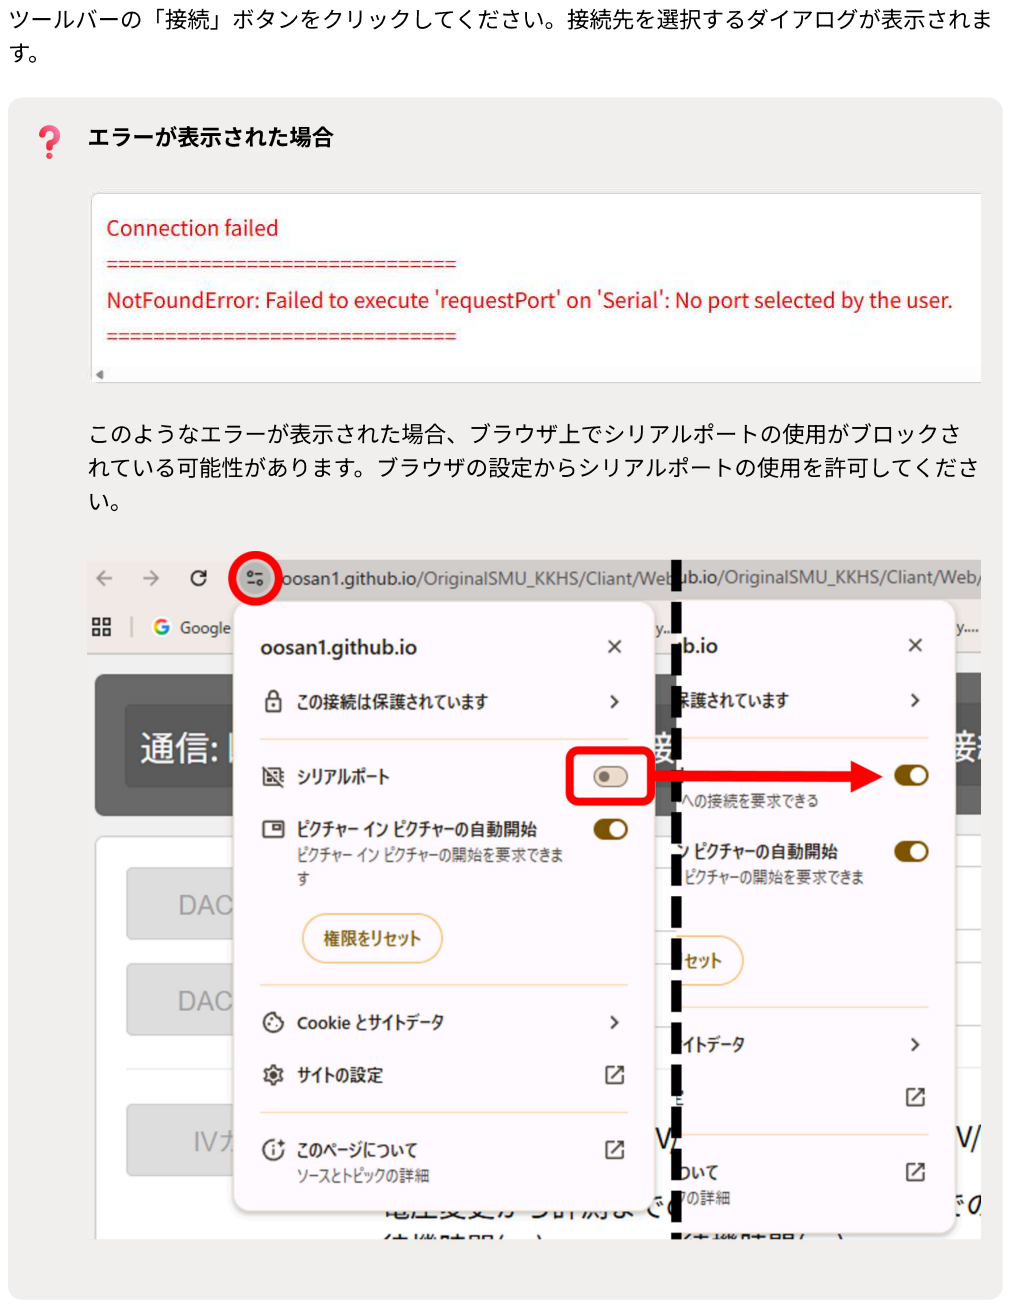
[picture p84: page 14]

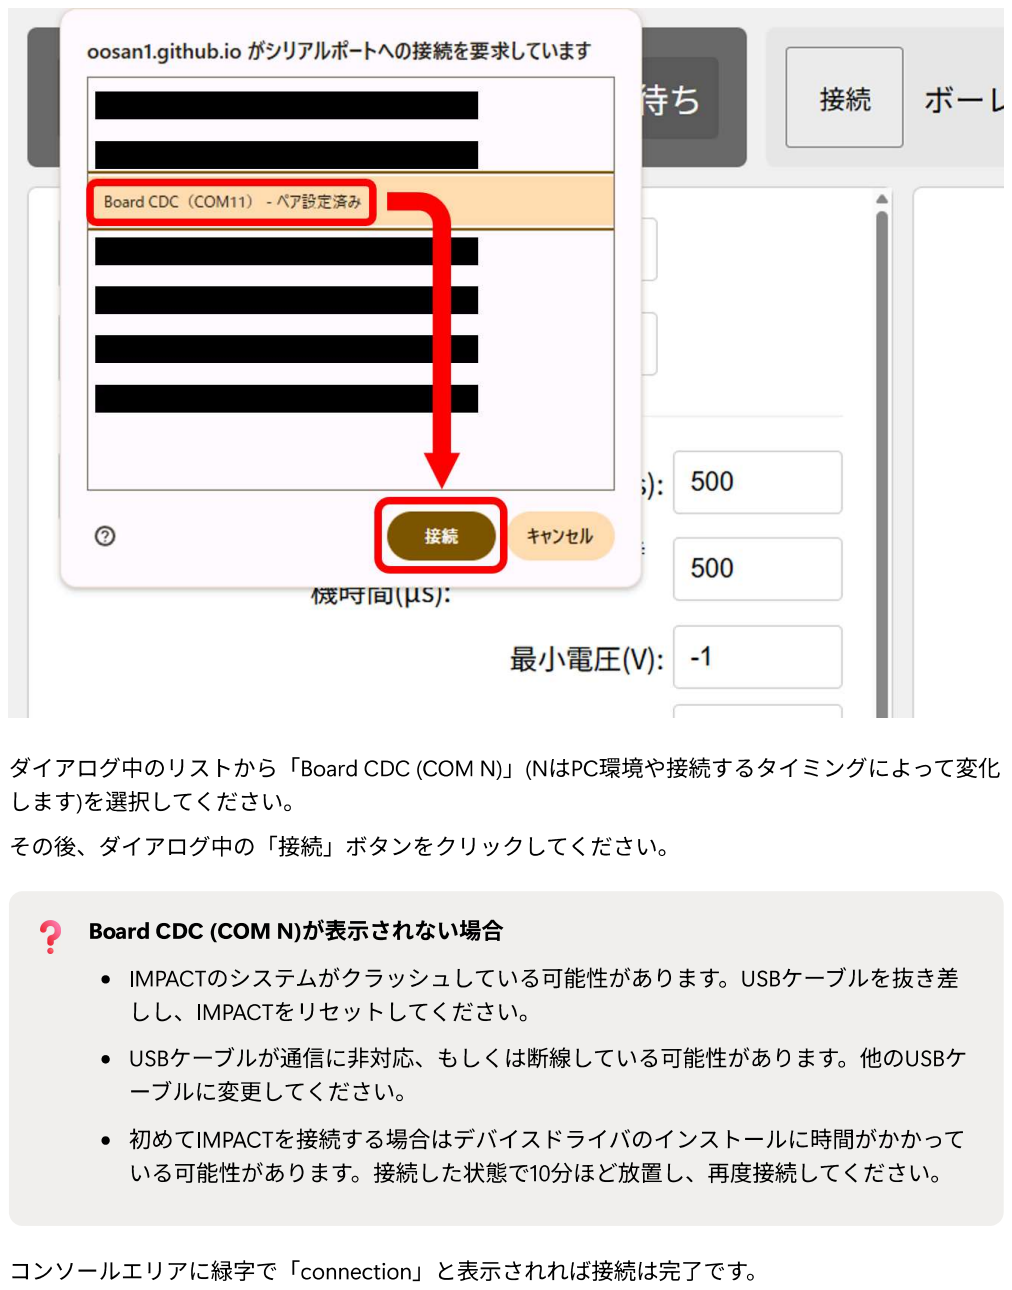
[picture p85: page 15]

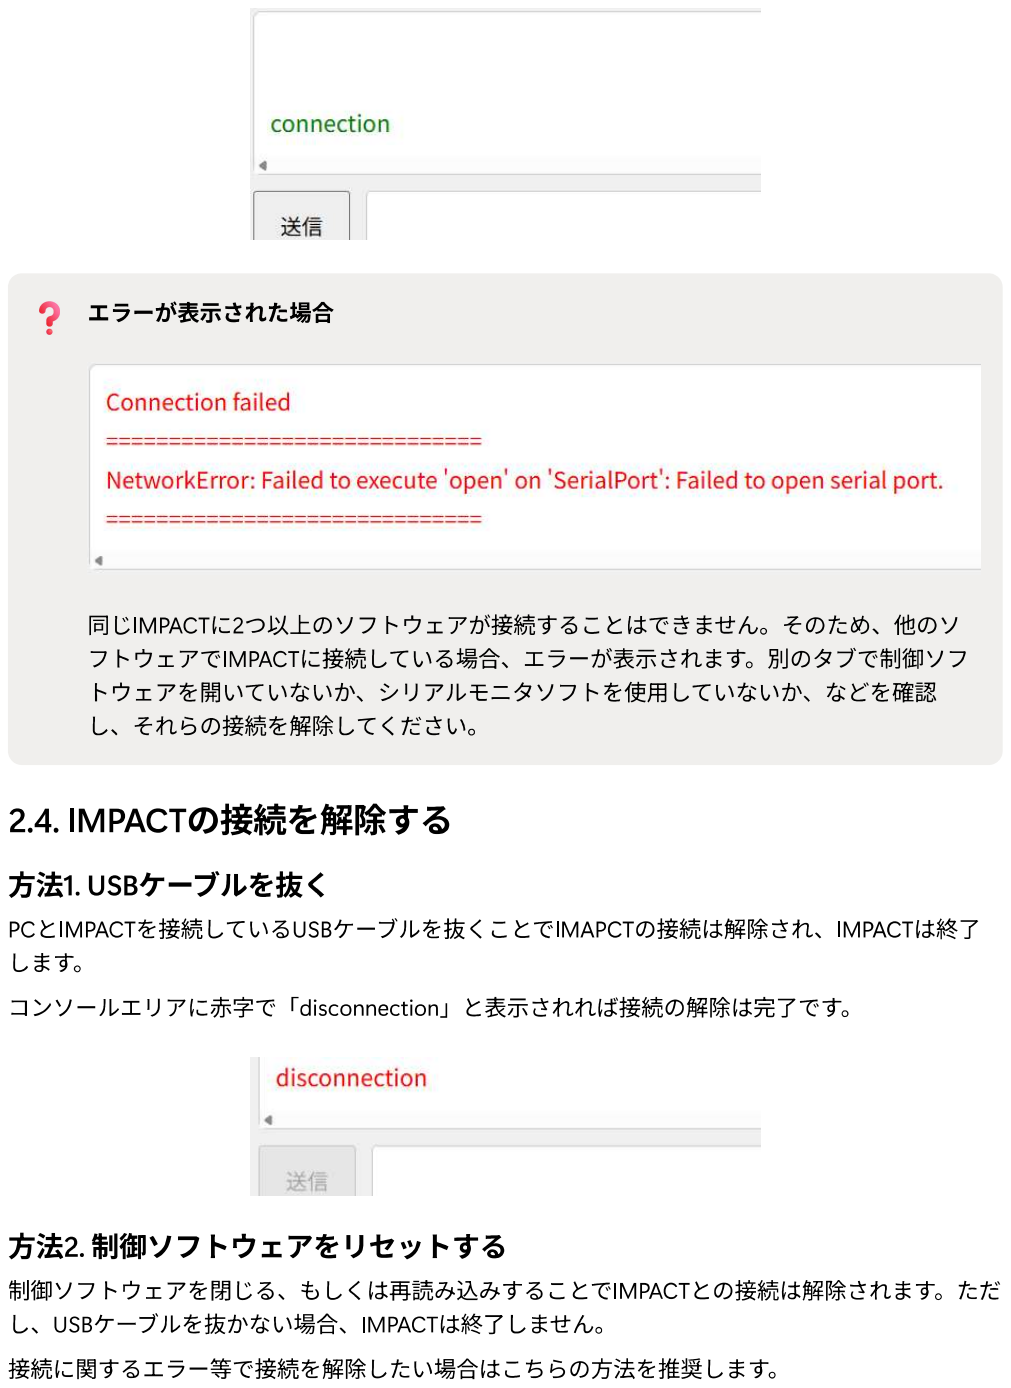
[picture p86: page 16]

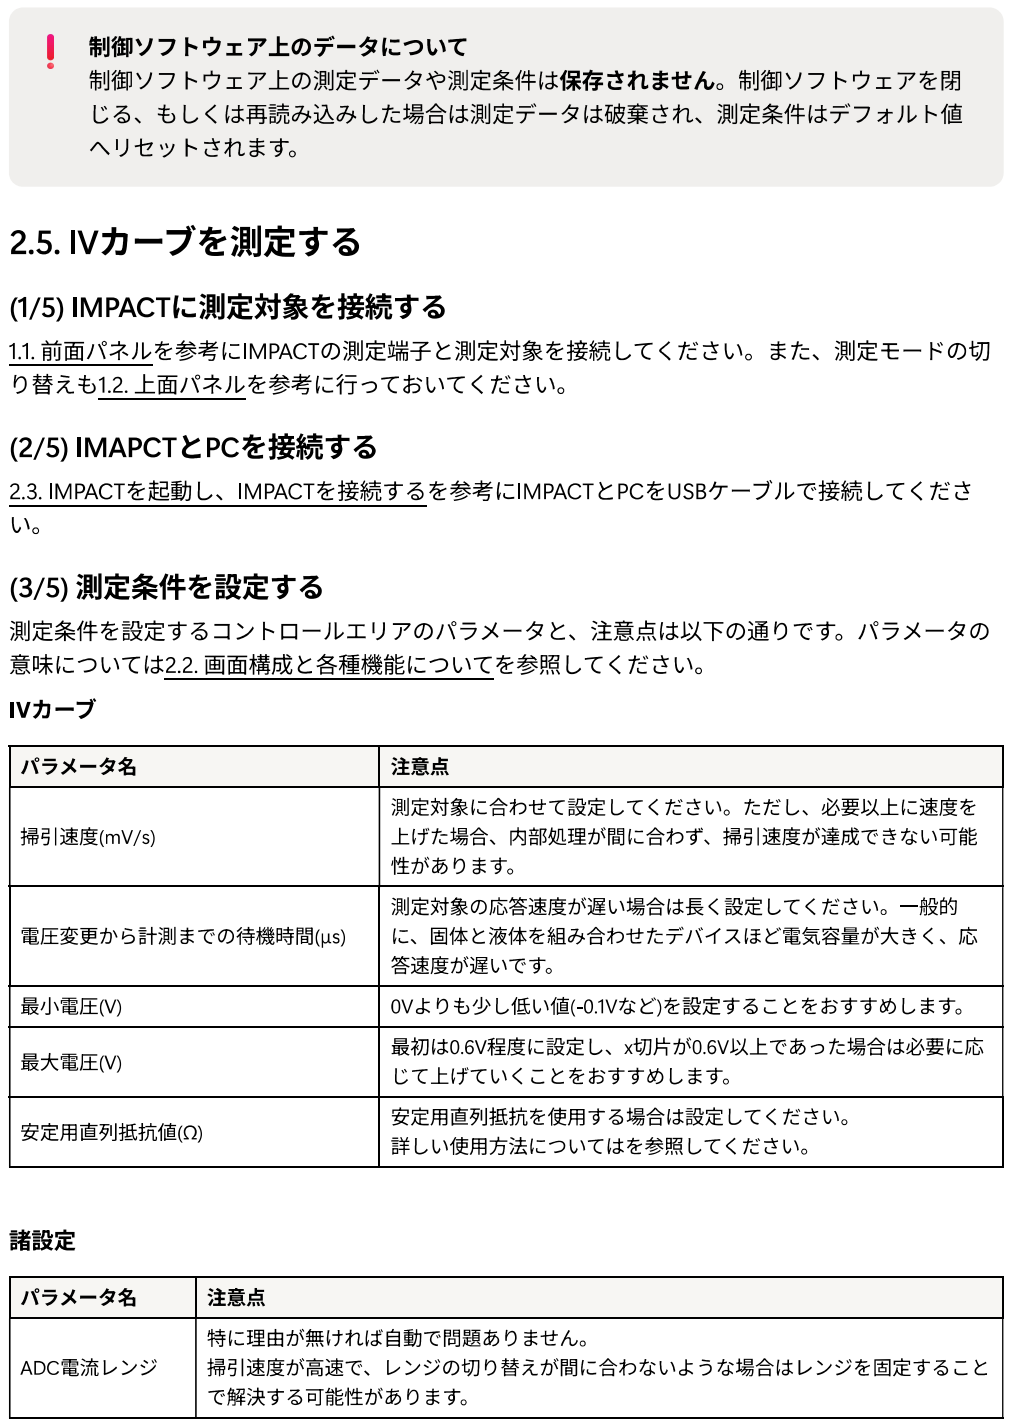
[picture p87: page 17]

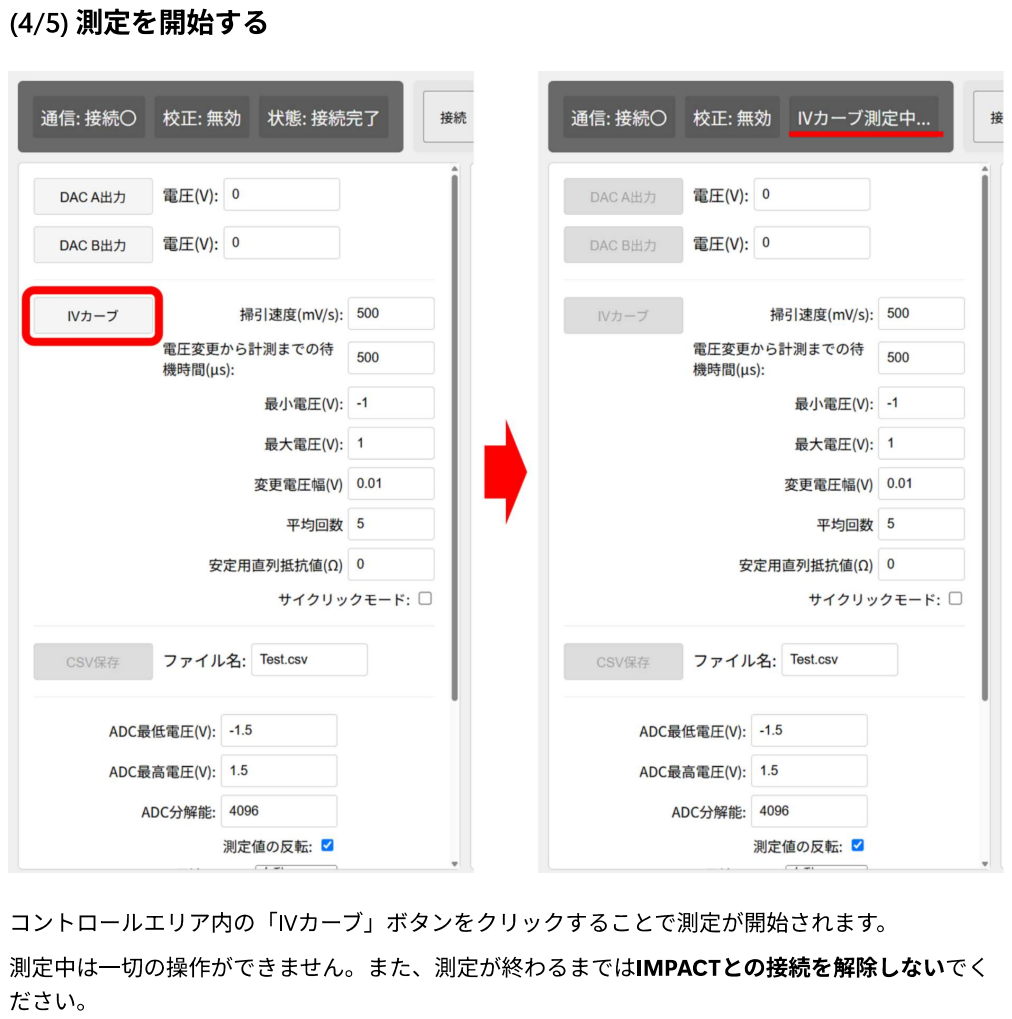
[picture p88: page 18]

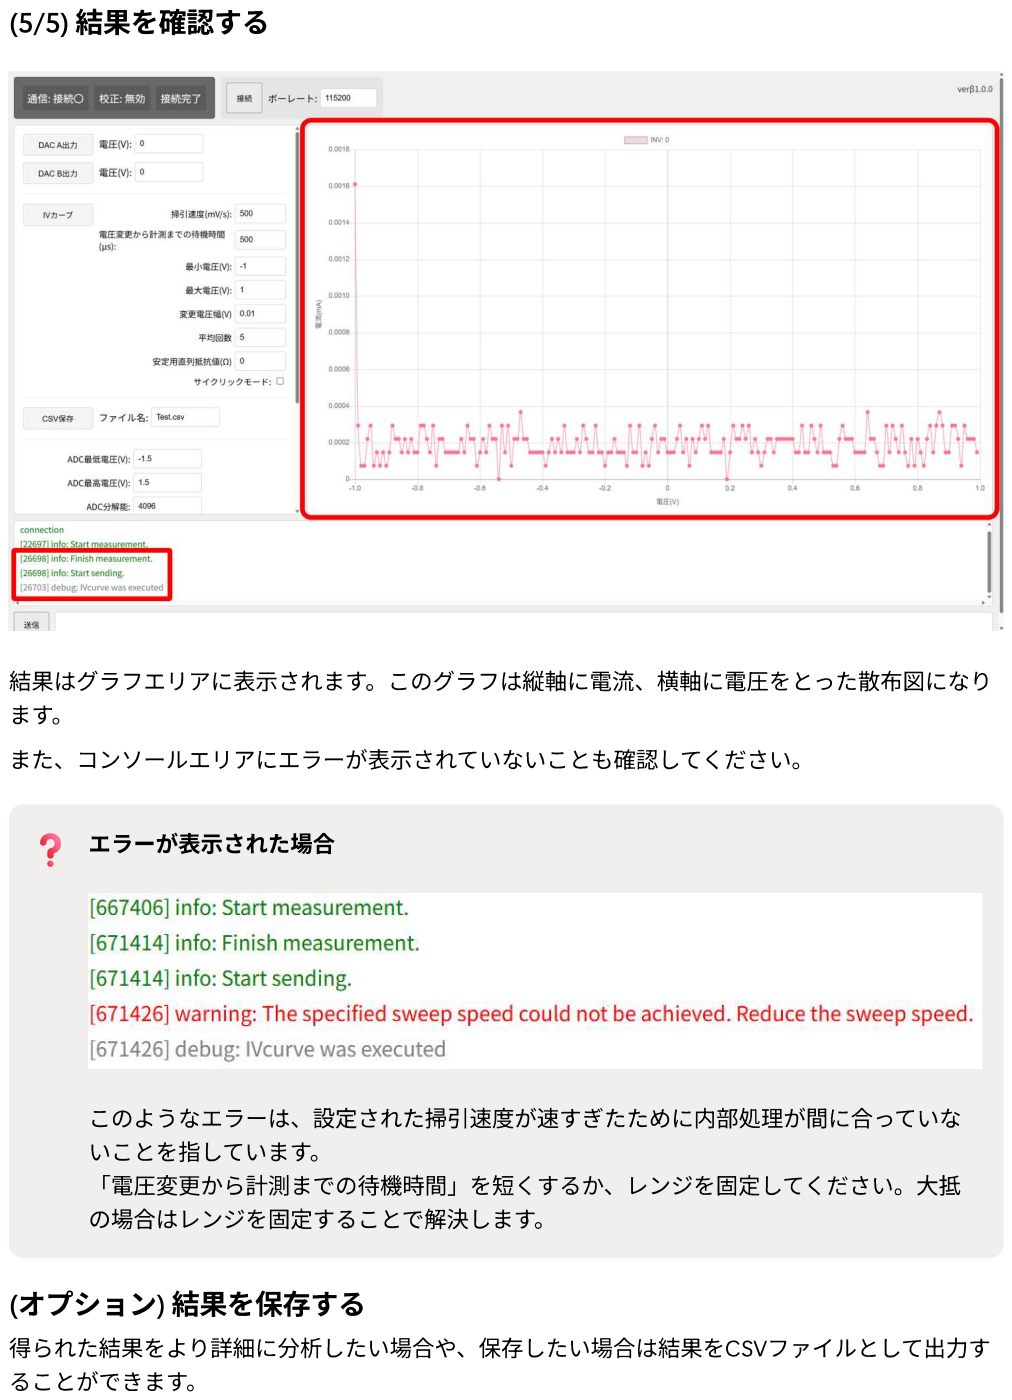
[picture p89: page 19]

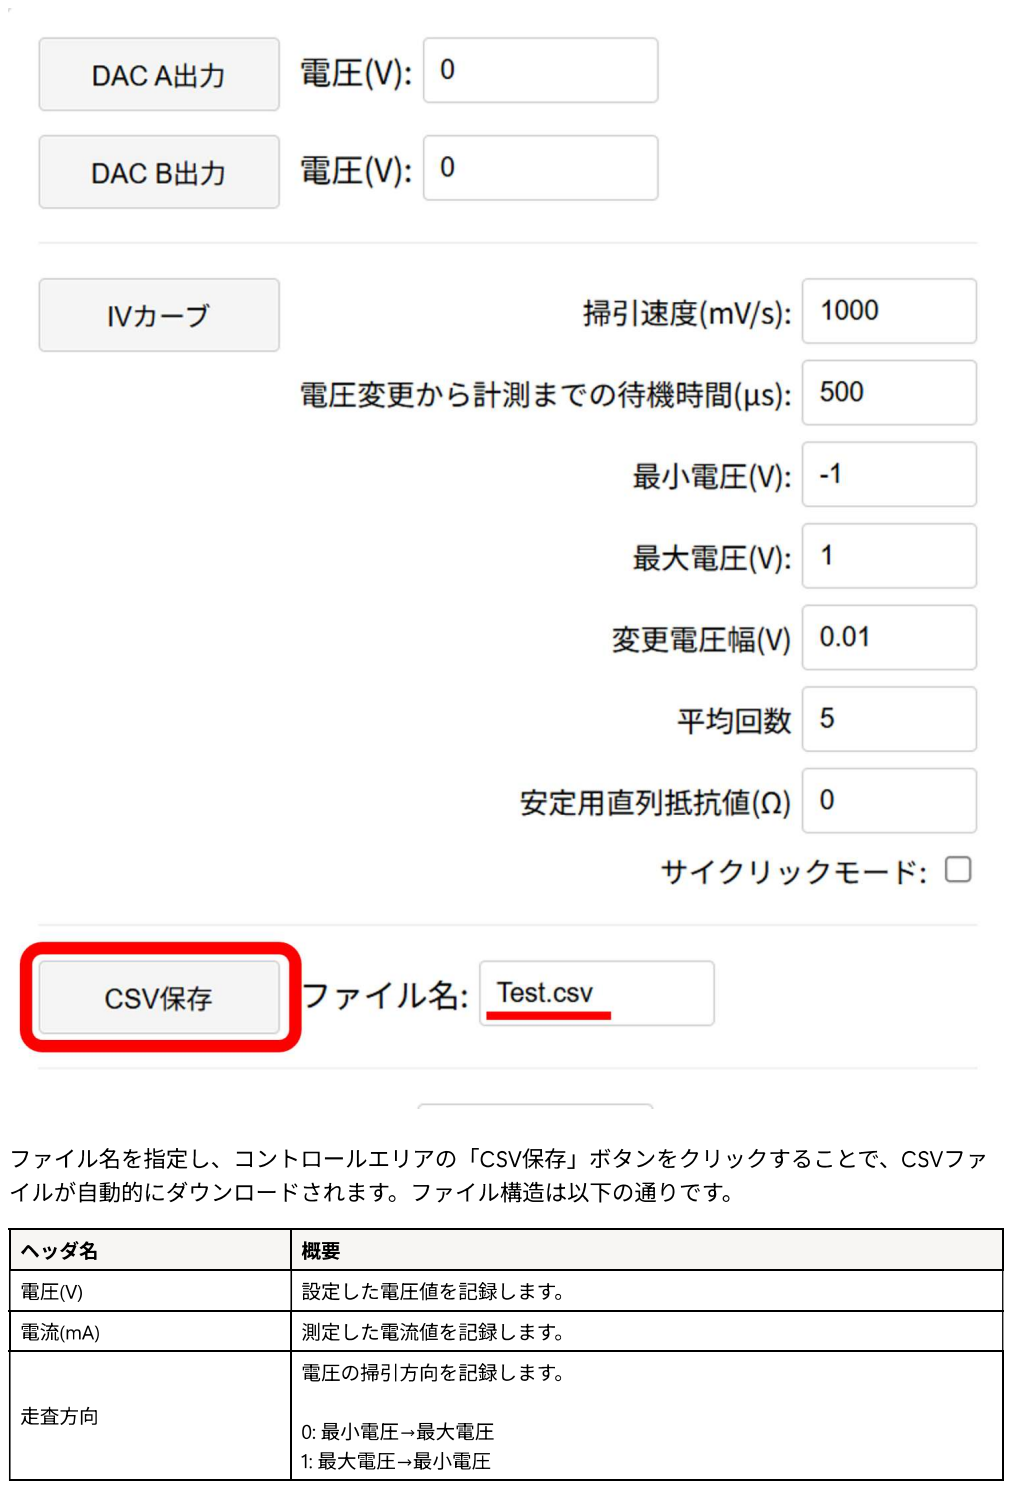
[picture p90: page 20]

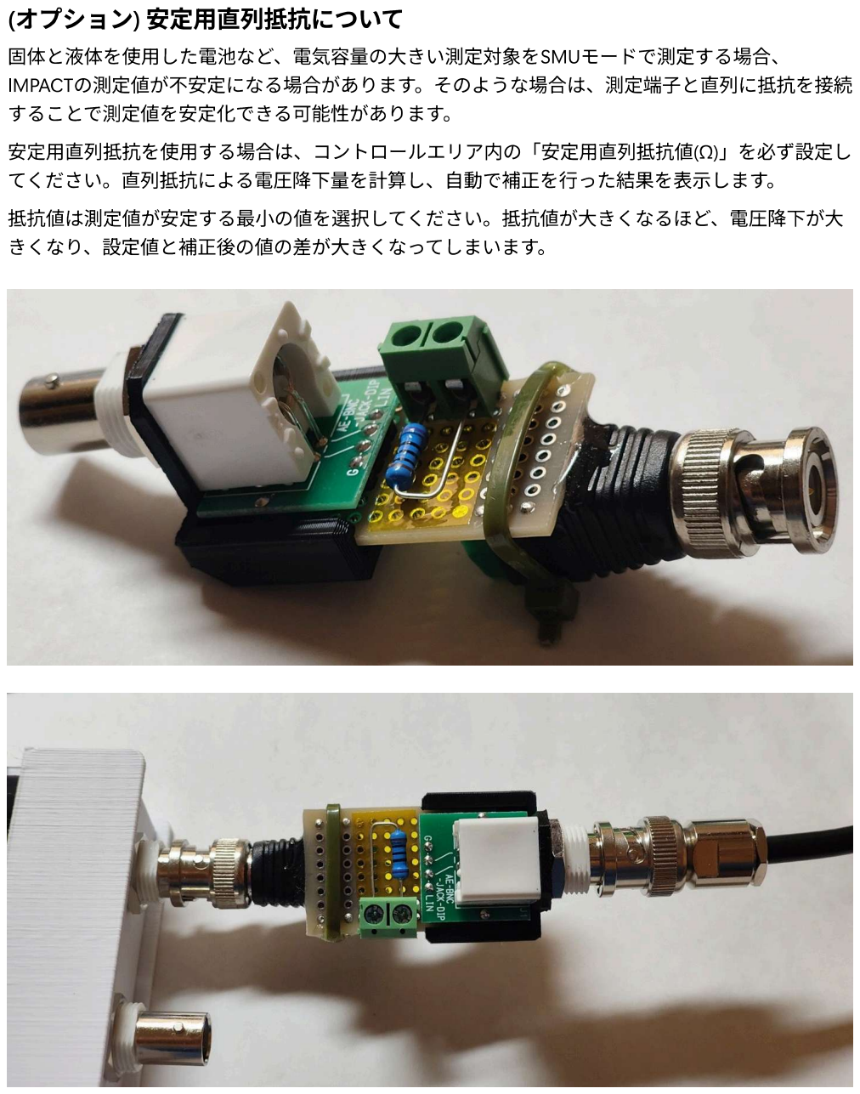
[picture p91: page 21]

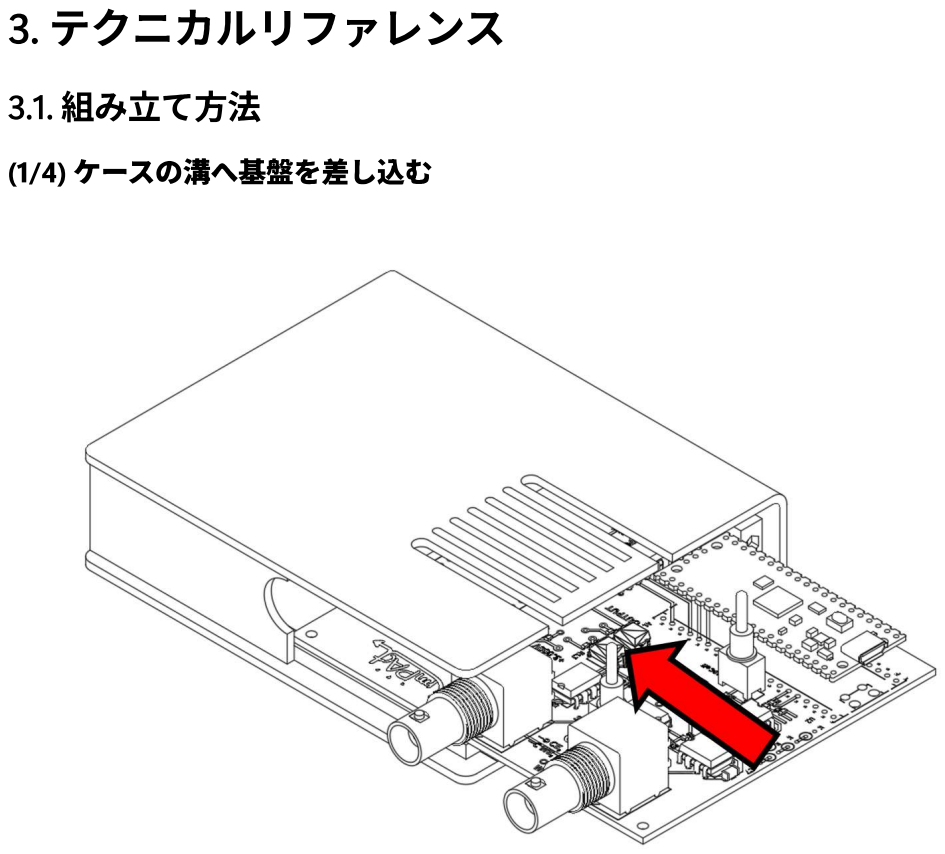
[picture p92: page 22]

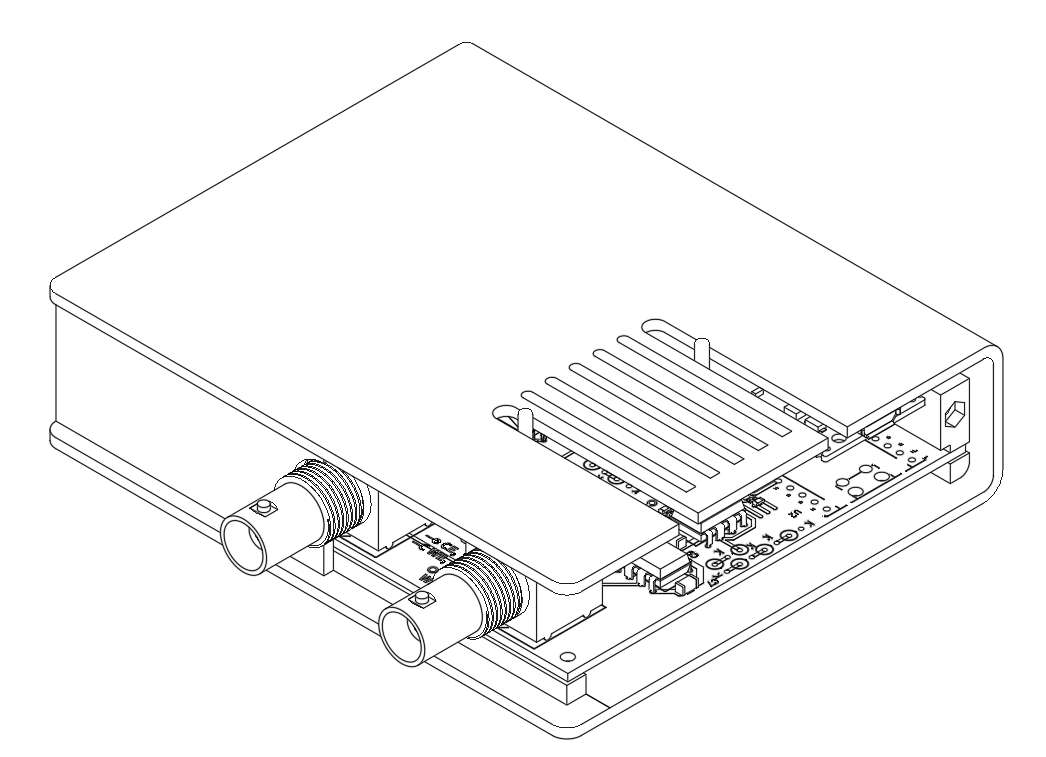
[picture p93: figure]
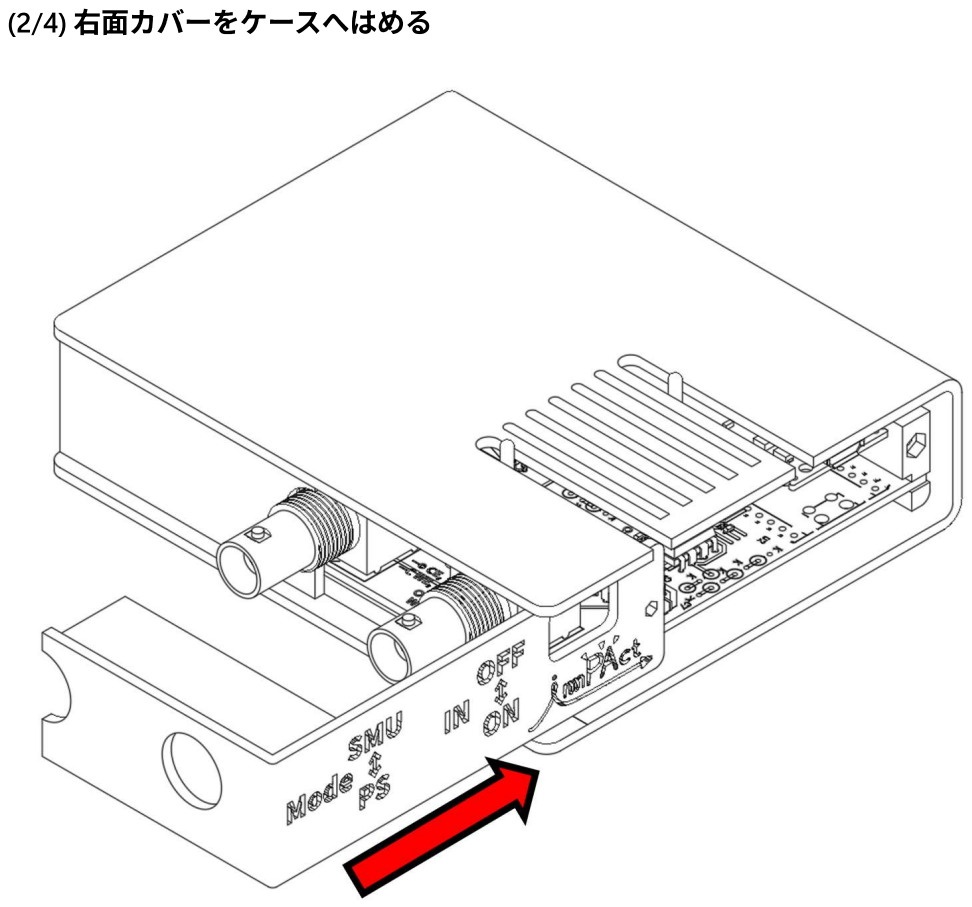
[picture p94: page 24]

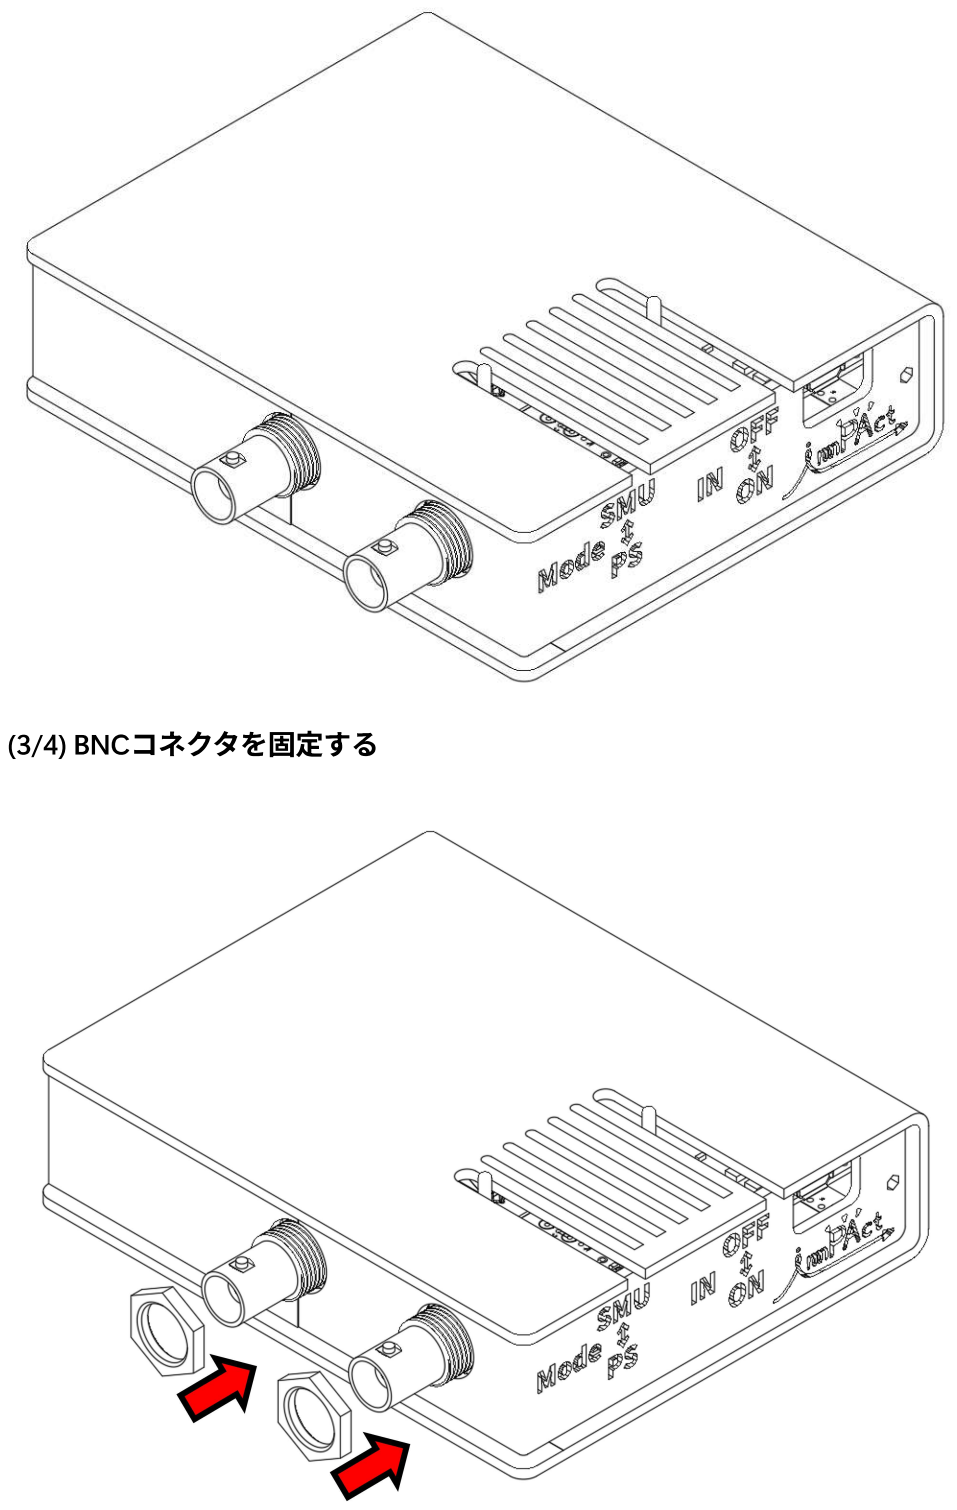
[picture p95: page 25]

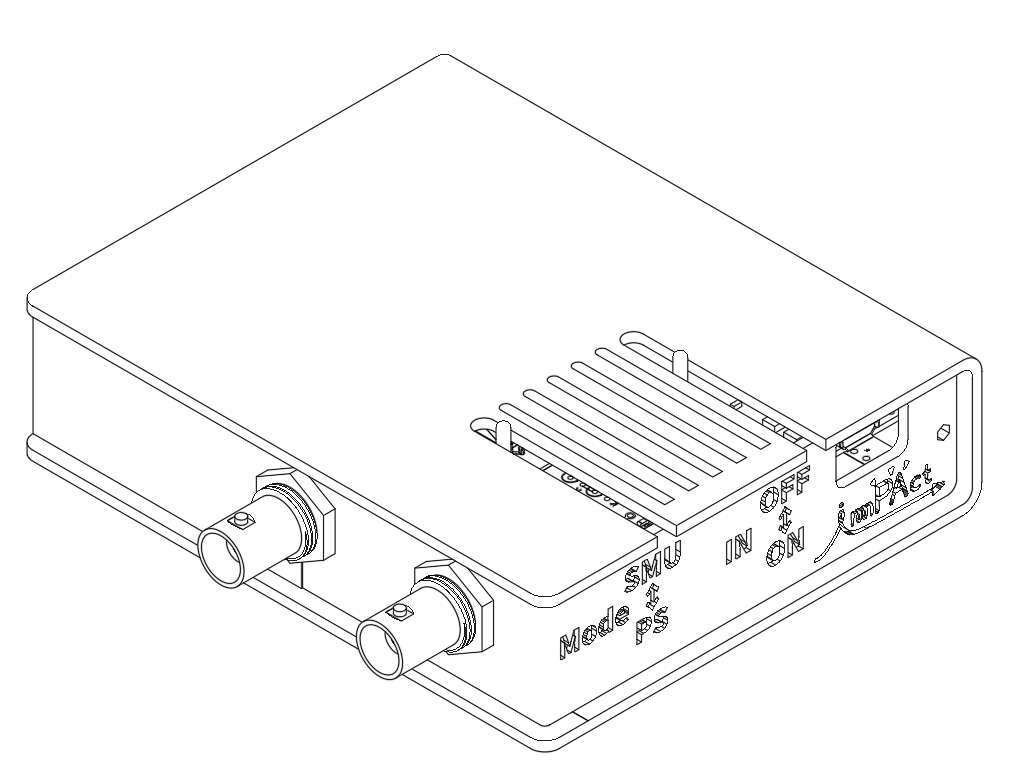
[picture p96: figure]
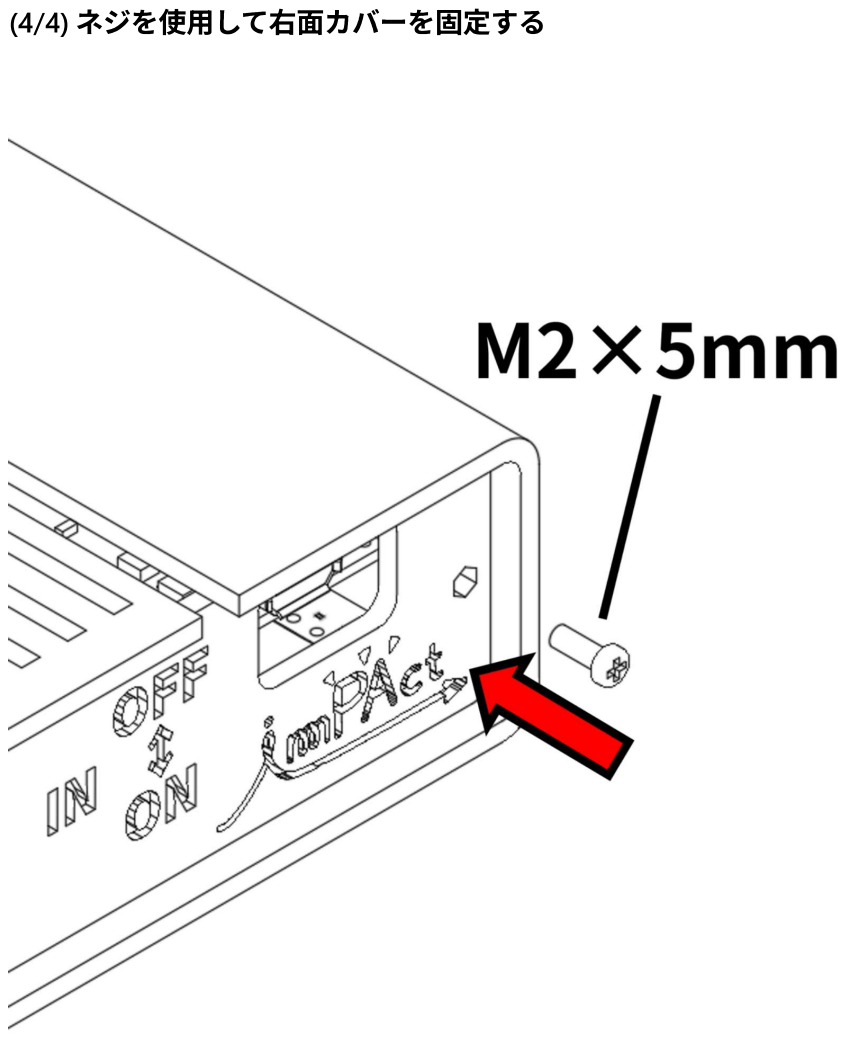
[picture p97: page 27]

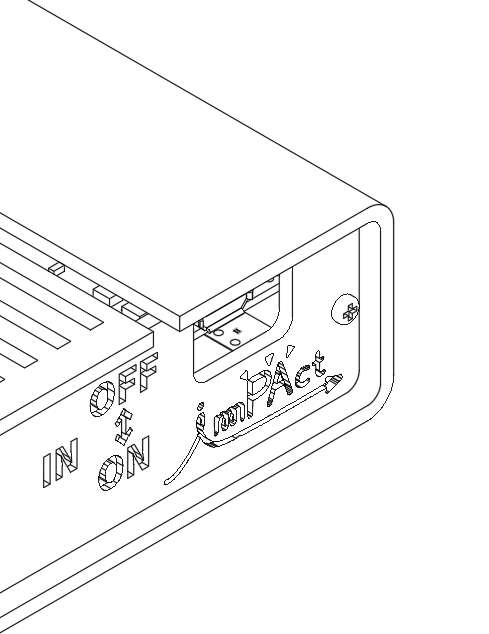
[picture p98: figure]
