oosan1/OriginalSMU_KKHS/(list of files, drawings)

Other design files:
Circuit/old/Sim/BD87521_HP_SPICE.olb
Circuit/old/Sim/BD87581_HP_SPICE.olb
Circuit/Sim/BD87521_HP_SPICE.olb
Circuit/Sim/BD87581_HP_SPICE.olb
