oosan1/OriginalSMU_KKHS/Circuit/PrintedCircuit3/SMU.kicad_pcb

## KiCad design Circuit/PrintedCircuit3/SMU.kicad_pcb (2026-03-12)

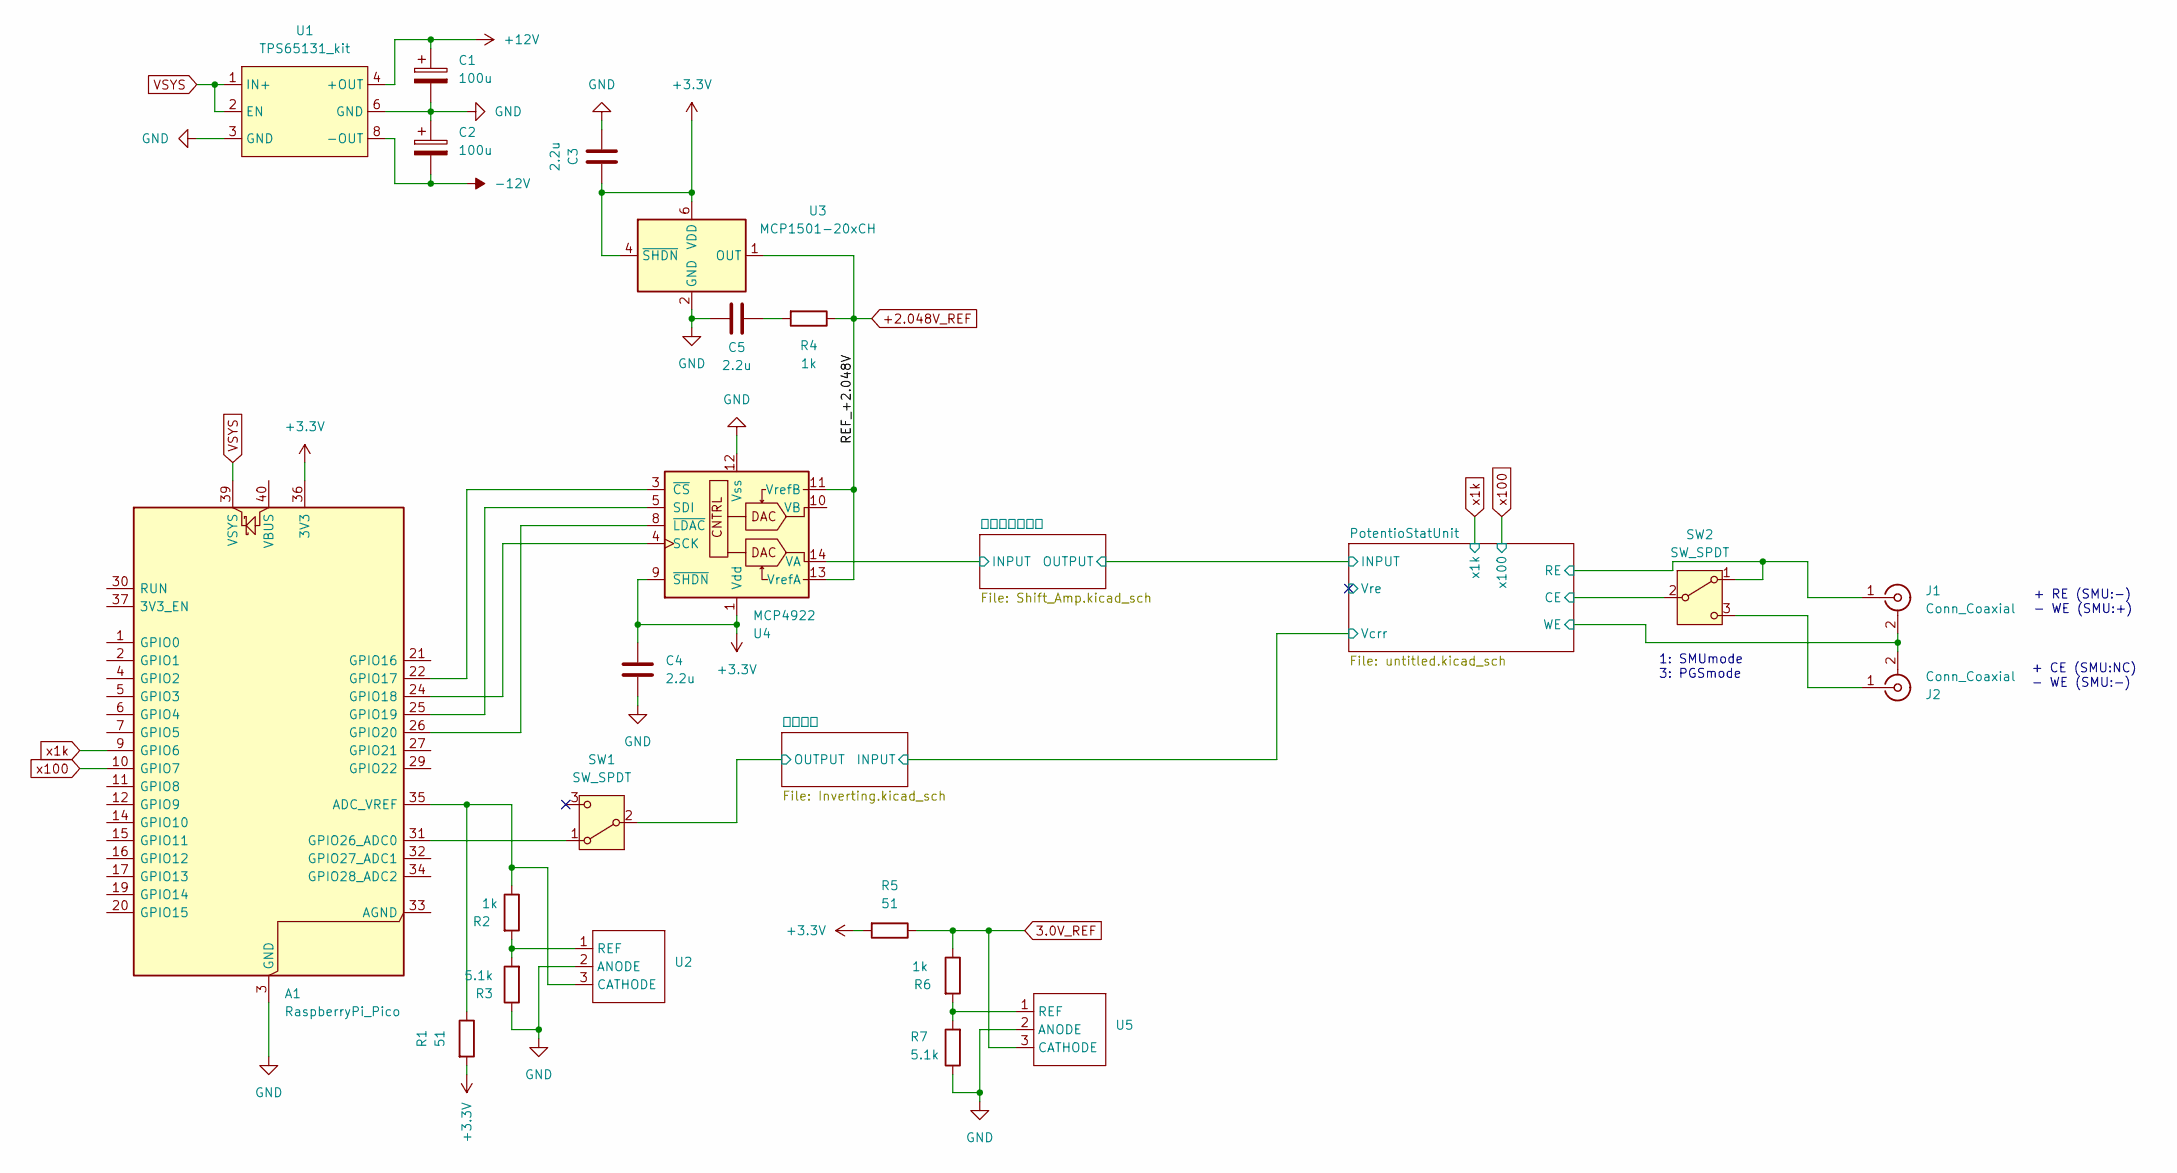
[picture p99: schematic SMU.kicad_sch]

Parts:
A1: RaspberryPi_Pico; RaspberryPi_Pico_Common_Unspecified
C1, C2: 100u; CP_Radial_D5.0mm_P2.00mm
C3, C4, C5: 2.2u; C_0603_1608Metric
J1, J2: Conn_Coaxial; BNC_Amphenol_B6252HB-NPP3G-50_Horizontal
R1, R5: 51; R_0603_1608Metric
R2, R4, R6: 1k; R_0603_1608Metric
R3, R7: 5.1k; R_0603_1608Metric
SW1, SW2: SW_SPDT; SW_Slide-03_Wuerth-WS-SLTV_10x2.5x6.4_P2.54mm
U1: TPS65131_kit
U2, U5: NJM1431AU
U3: MCP1501-20xCH; SOT-23-6
U4: MCP4922; DIP-14_W7.62mm

Connections:
3.0V_REF: R5.1, R6.1, U5.3 (CATHODE); also elsewhere on the board
+2.048V_REF: R4.1, U3.1 (OUT), U4.11 (VrefB), U4.13 (VrefA); also elsewhere on the board
+3.3V: A1.36 (3V3), C3.2, C4.1, R1.2, R5.2, U3.4 (~SHDN), U3.6 (VDD), U4.1 (Vdd), U4.9 (~SHDN)
+12V: C1.1, U1.4 (+OUT), U1.5 (+OUT); also elsewhere on the board
-12V: C2.2, U1.8 (-OUT), U1.9 (-OUT); also elsewhere on the board
/PotentioStatUnit/CE: SW2.2 (B); also elsewhere on the board
/PotentioStatUnit/RE: J1.1 (In), SW2.1 (A); also elsewhere on the board
/PotentioStatUnit/WE: J1.2 (Ext), J2.2 (Ext); also elsewhere on the board
/シフト増幅回路/INPUT: U4.14 (VA); also elsewhere on the board
/反転回路/OUTPUT: SW1.2 (B); also elsewhere on the board
GND: A1.3 (GND), A1.8 (GND), A1.13 (GND), A1.18 (GND), A1.23 (GND), A1.28 (GND), A1.38 (GND), C1.2, C2.1, C3.1, C4.2, C5.1, R3.1, R7.1, U1.3 (GND), U1.6 (GND), U1.7 (GND), U2.2 (ANODE), U3.2 (GND), U3.3 (GND), U3.5 (GND), U4.12 (Vss), U5.2 (ANODE); also elsewhere on the board
unnamed: A1.35 (ADC_VREF), R1.1, R2.1, U2.3 (CATHODE)
unnamed: A1.22 (GPIO17), U4.3 (~CS)
unnamed: A1.24 (GPIO18), U4.4 (SCK)
unnamed: A1.25 (GPIO19), U4.5 (SDI)
unnamed: A1.26 (GPIO20), U4.8 (~LDAC)
unnamed: A1.31 (GPIO26_ADC0), SW1.1 (A)
unnamed: C5.2, R4.2
unnamed: J2.1 (In), SW2.3 (C)
unnamed: R2.2, R3.2, U2.1 (REF)
unnamed: R6.2, R7.2, U5.1 (REF)
VSYS: A1.39 (VSYS), U1.1 (IN+), U1.2 (EN)
x1k: A1.9 (GPIO6); also elsewhere on the board
x100: A1.10 (GPIO7); also elsewhere on the board

Notes on the sheet:
1: SMUmode 3: PGSmode
+ CE (SMU:NC) - WE (SMU:-)
+ RE (SMU:-) - WE (SMU:+)

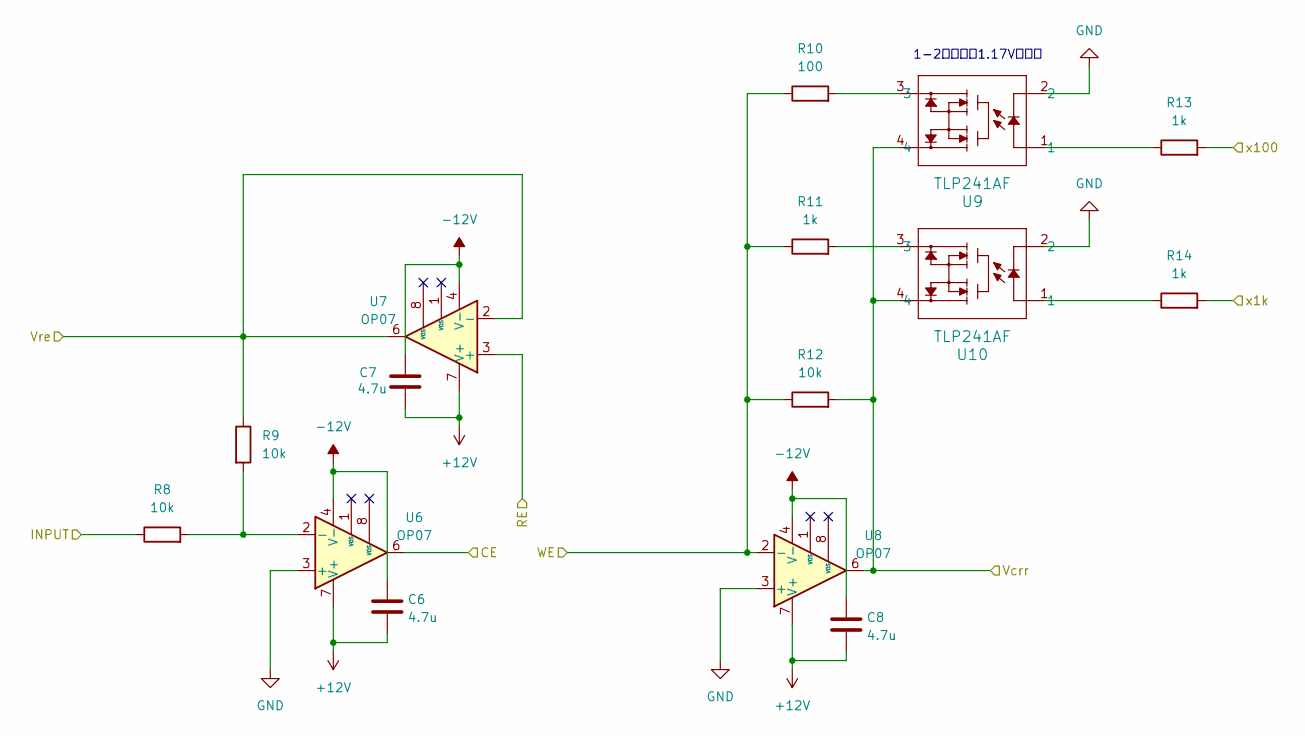
[picture p100: schematic untitled.kicad_sch]

Parts:
C6, C7, C8: 4.7u; C_1206_3216Metric
R8, R9, R12: 10k; R_0603_1608Metric
R10: 100; R_0603_1608Metric
R11, R13, R14: 1k; R_0603_1608Metric
U6, U7, U8: OP07; DIP-8_W7.62mm
U9, U10: TLP241AF; DIP4_TOS

Connections:
+12V: C6.1, C7.1, C8.1, U6.7 (V+), U7.7 (V+), U8.7 (V+); also elsewhere on the board
-12V: C6.2, C7.2, C8.2, U6.4 (V-), U7.4 (V-), U8.4 (V-); also elsewhere on the board
/PotentioStatUnit/CE: U6.6; also elsewhere on the board
/PotentioStatUnit/INPUT: R8.1; also elsewhere on the board
/PotentioStatUnit/RE: U7.3 (+); also elsewhere on the board
/PotentioStatUnit/Vcrr: R12.2, U8.6, U9.4, U10.4; also elsewhere on the board
/PotentioStatUnit/Vre: R9.1, U7.2 (-), U7.6
/PotentioStatUnit/WE: R10.1, R11.1, R12.1, U8.2 (-); also elsewhere on the board
GND: U6.3 (+), U8.3 (+), U9.2, U10.2; also elsewhere on the board
unnamed: R10.2, U9.3
unnamed: R11.2, U10.3
unnamed: R13.1, U9.1
unnamed: R14.1, U10.1
unnamed: R8.2, R9.2, U6.2 (-)
x1k: R14.2; also elsewhere on the board
x100: R13.2; also elsewhere on the board

Notes on the sheet:
1-2間電圧は1.17V以上に

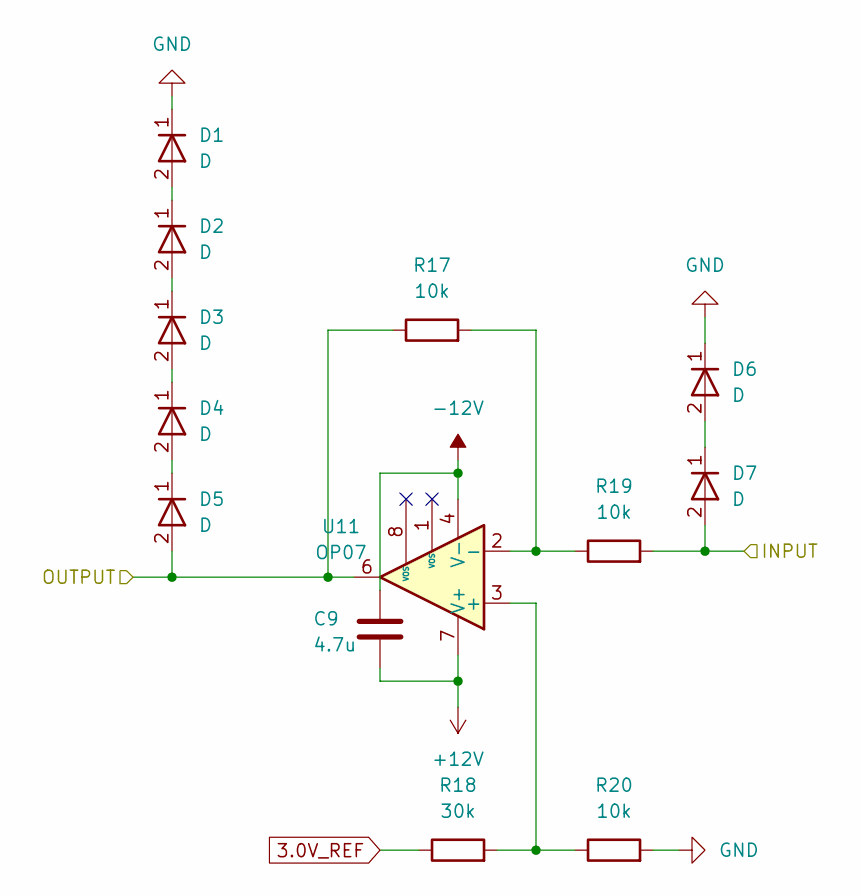
[picture p101: schematic Inverting.kicad_sch]

Parts:
C9: 4.7u; C_1206_3216Metric
D1, D2, D3, D4, D5, D6, D7: D; D_DO-34_SOD68_P2.54mm_Vertical_KathodeUp
R17, R19, R20: 10k; R_0603_1608Metric
R18: 30k; R_0603_1608Metric
U11: OP07; DIP-8_W7.62mm

Connections:
3.0V_REF: R18.1; also elsewhere on the board
+12V: C9.2, U11.7 (V+); also elsewhere on the board
-12V: C9.1, U11.4 (V-); also elsewhere on the board
/PotentioStatUnit/Vcrr: D7.2 (A), R19.2; also elsewhere on the board
/反転回路/OUTPUT: D5.2 (A), R17.1, U11.6; also elsewhere on the board
GND: D1.1 (K), D6.1 (K), R20.2; also elsewhere on the board
unnamed: D1.2 (A), D2.1 (K)
unnamed: D2.2 (A), D3.1 (K)
unnamed: D3.2 (A), D4.1 (K)
unnamed: D4.2 (A), D5.1 (K)
unnamed: D6.2 (A), D7.1 (K)
unnamed: R18.2, R20.1, U11.3 (+)
unnamed: R17.2, R19.1, U11.2 (-)

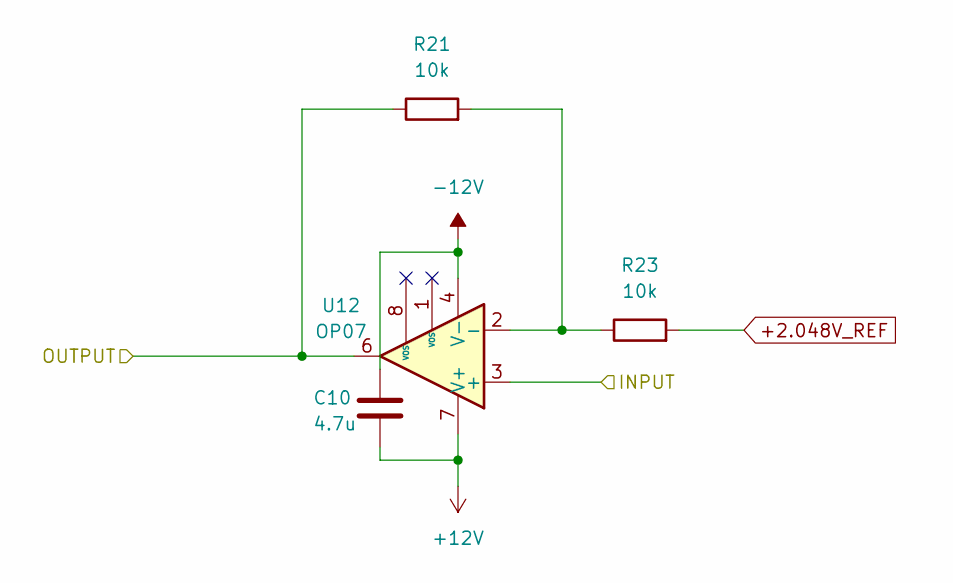
[picture p102: schematic Shift_Amp.kicad_sch]

Parts:
C10: 4.7u; C_1206_3216Metric
R21, R23: 10k; R_0603_1608Metric
U12: OP07; DIP-8_W7.62mm

Connections:
+2.048V_REF: R23.2; also elsewhere on the board
+12V: C10.2, U12.7 (V+); also elsewhere on the board
-12V: C10.1, U12.4 (V-); also elsewhere on the board
/PotentioStatUnit/INPUT: R21.1, U12.6; also elsewhere on the board
/シフト増幅回路/INPUT: U12.3 (+); also elsewhere on the board
unnamed: R21.2, R23.1, U12.2 (-)

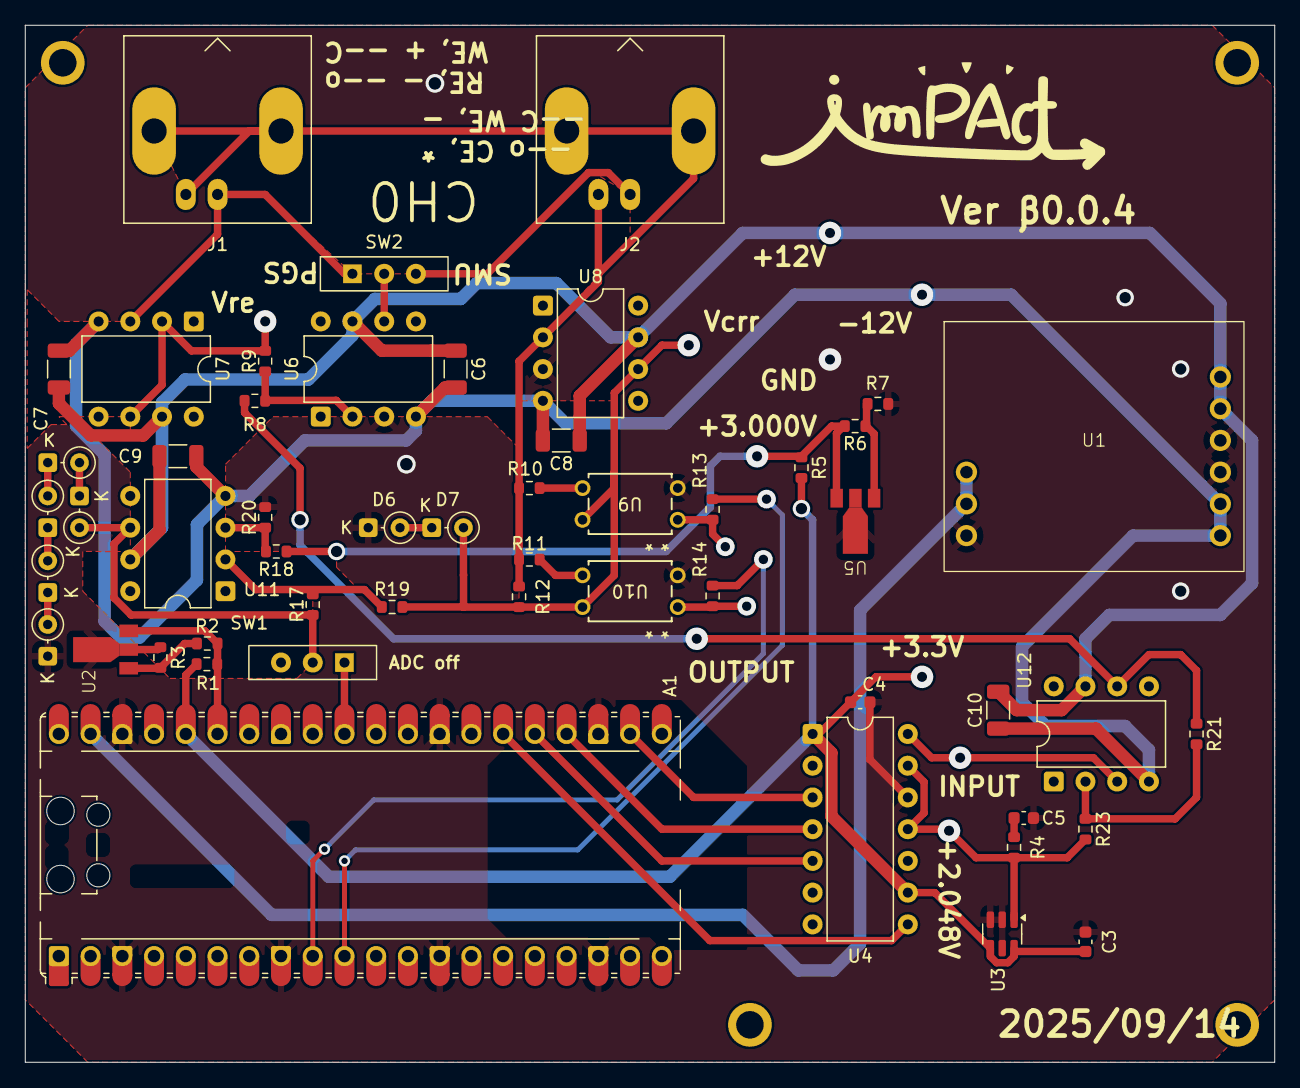
[picture p103: board Circuit/PrintedCircuit3/SMU.kicad_pcb from above]

Board: 2 copper layers, 100.0 x 83.0 mm, 52 parts (0 on the bottom side), 40 nets.
