oosan1/OriginalSMU_KKHS/Circuit/PrintedCircuit2/SMU2/SMU.kicad_pcb

## KiCad design Circuit/PrintedCircuit2/SMU2/SMU.kicad_pcb (2025-06-22, an earlier design)

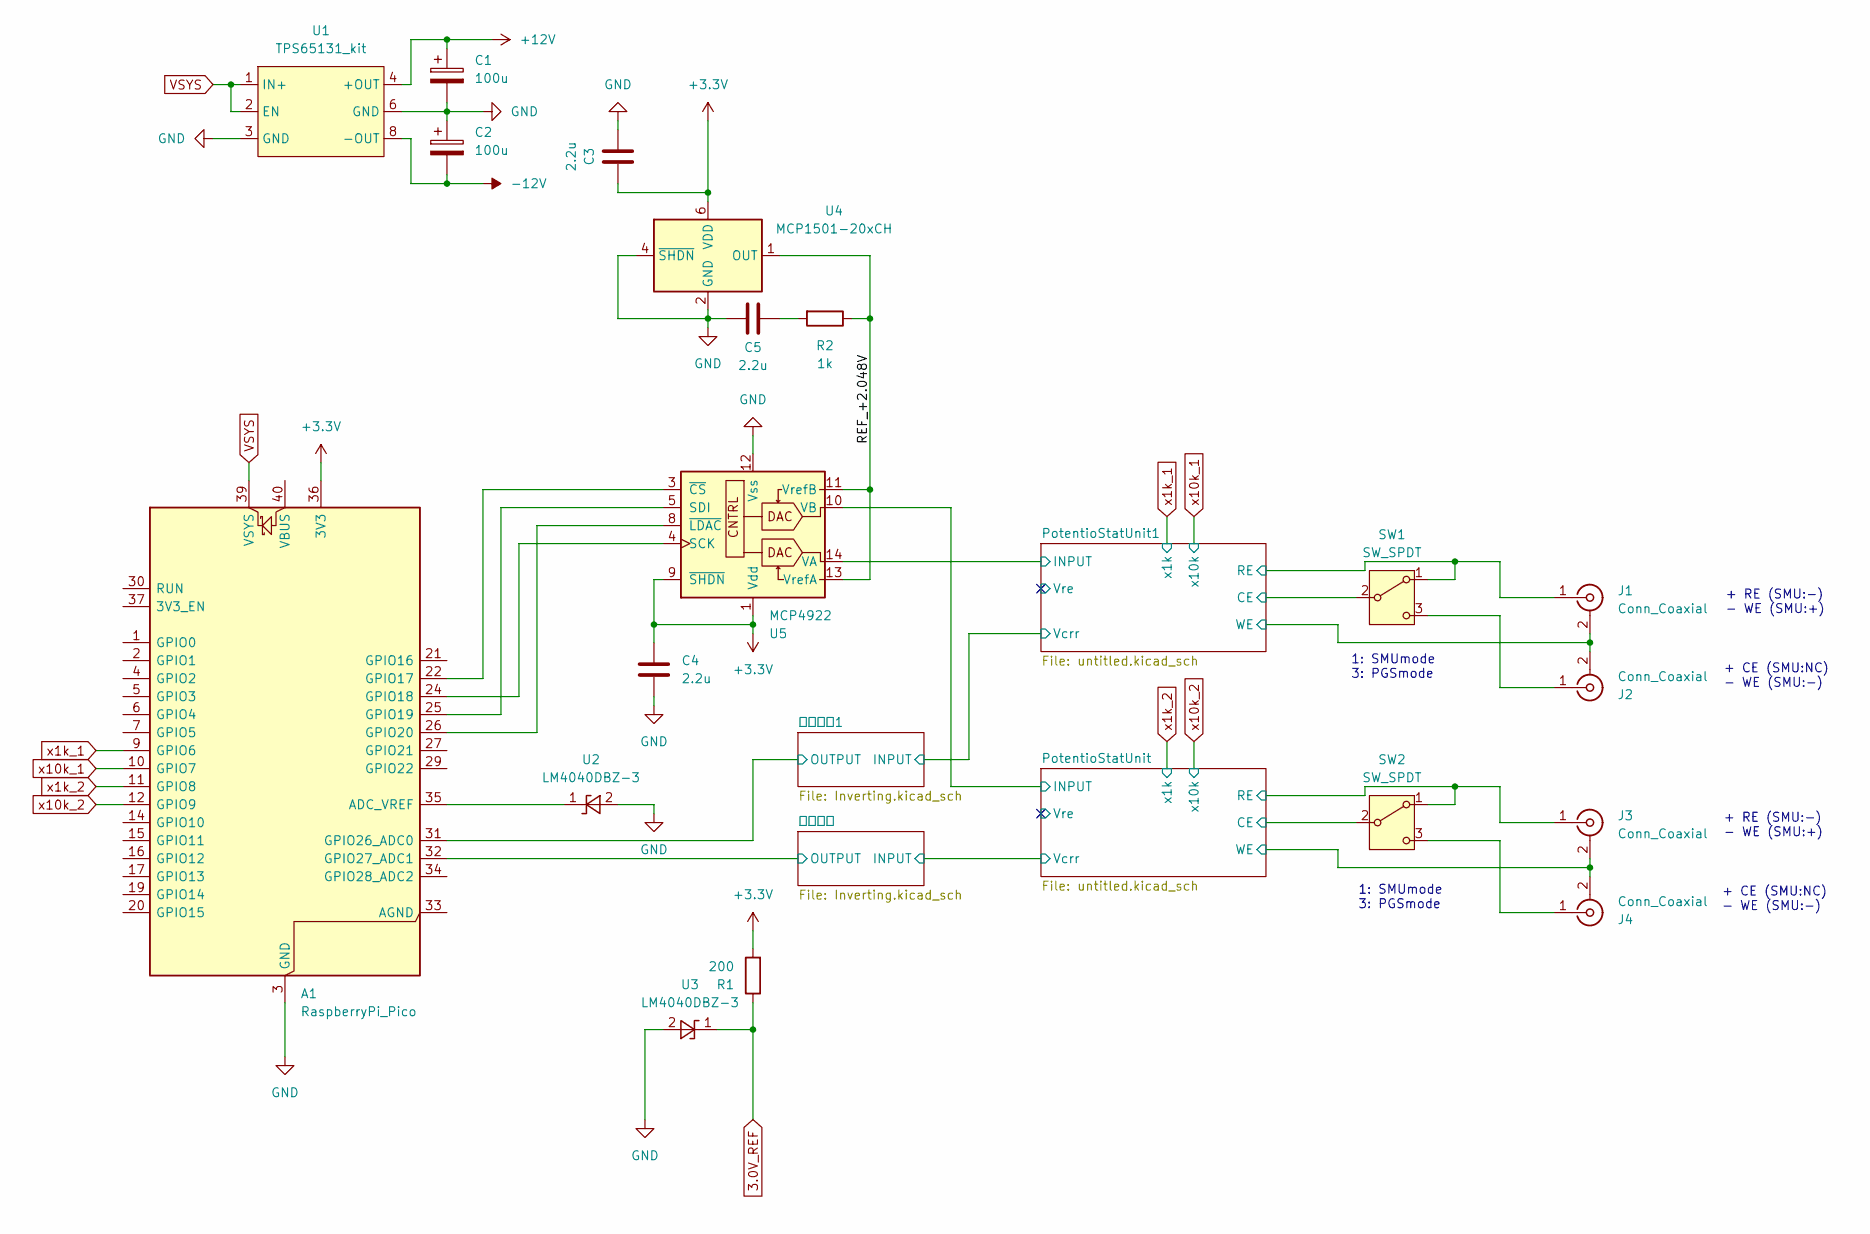
[picture p104: schematic SMU.kicad_sch]

Parts:
A1: RaspberryPi_Pico; RaspberryPi_Pico_Common_Unspecified
C1, C2: 100u; CP_Radial_D5.0mm_P2.00mm
C3, C4, C5: 2.2u; C_0603_1608Metric
J1, J2, J3, J4: Conn_Coaxial; BNC_Amphenol_B6252HB-NPP3G-50_Horizontal
R1: 200; R_0603_1608Metric
R2: 1k; R_0603_1608Metric
SW1, SW2: SW_SPDT; SW_Slide-03_Wuerth-WS-SLTV_10x2.5x6.4_P2.54mm
U1: TPS65131_kit
U2, U3: LM4040DBZ-3; SOT-23
U4: MCP1501-20xCH; SOT-23-6
U5: MCP4922; DIP-14_W7.62mm

Connections:
3.0V_REF: R1.1, U3.1 (K); also elsewhere on the board
+3.3V: A1.36 (3V3), C3.2, C4.1, R1.2, U4.6 (VDD), U5.1 (Vdd), U5.9 (~SHDN)
+12V: C1.1, U1.4 (+OUT), U1.5 (+OUT); also elsewhere on the board
-12V: C2.2, U1.8 (-OUT), U1.9 (-OUT); also elsewhere on the board
/PotentioStatUnit1/CE: SW1.2 (B); also elsewhere on the board
/PotentioStatUnit1/INPUT: U5.14 (VA); also elsewhere on the board
/PotentioStatUnit1/RE: J1.1 (In), SW1.1 (A); also elsewhere on the board
/PotentioStatUnit1/WE: J1.2 (Ext), J2.2 (Ext); also elsewhere on the board
/PotentioStatUnit/CE: SW2.2 (B); also elsewhere on the board
/PotentioStatUnit/INPUT: U5.10 (VB); also elsewhere on the board
/PotentioStatUnit/RE: J3.1 (In), SW2.1 (A); also elsewhere on the board
/PotentioStatUnit/WE: J3.2 (Ext), J4.2 (Ext); also elsewhere on the board
/REF_+2.048V: R2.1, U4.1 (OUT), U5.11 (VrefB), U5.13 (VrefA)
GND: A1.3 (GND), A1.8 (GND), A1.13 (GND), A1.18 (GND), A1.23 (GND), A1.28 (GND), A1.38 (GND), C1.2, C2.1, C3.1, C4.2, C5.1, U1.3 (GND), U1.6 (GND), U1.7 (GND), U2.2 (A), U3.2 (A), U4.2 (GND), U4.3 (GND), U4.4 (~SHDN), U4.5 (GND), U5.12 (Vss); also elsewhere on the board
unnamed: A1.35 (ADC_VREF), U2.1 (K)
unnamed: A1.22 (GPIO17), U5.3 (~CS)
unnamed: A1.24 (GPIO18), U5.4 (SCK)
unnamed: A1.25 (GPIO19), U5.5 (SDI)
unnamed: A1.26 (GPIO20), U5.8 (~LDAC)
unnamed 25: A1.31 (GPIO26_ADC0); also elsewhere on the board
unnamed 26: A1.32 (GPIO27_ADC1); also elsewhere on the board
unnamed: C5.2, R2.2
unnamed: J2.1 (In), SW1.3 (C)
unnamed: J4.1 (In), SW2.3 (C)
VSYS: A1.39 (VSYS), U1.1 (IN+), U1.2 (EN)
x1k_1: A1.9 (GPIO6); also elsewhere on the board
x1k_2: A1.11 (GPIO8); also elsewhere on the board
x10k_1: A1.10 (GPIO7); also elsewhere on the board
x10k_2: A1.12 (GPIO9); also elsewhere on the board

Notes on the sheet:
+ RE (SMU:-) - WE (SMU:+)
1: SMUmode 3: PGSmode
+ CE (SMU:NC) - WE (SMU:-)

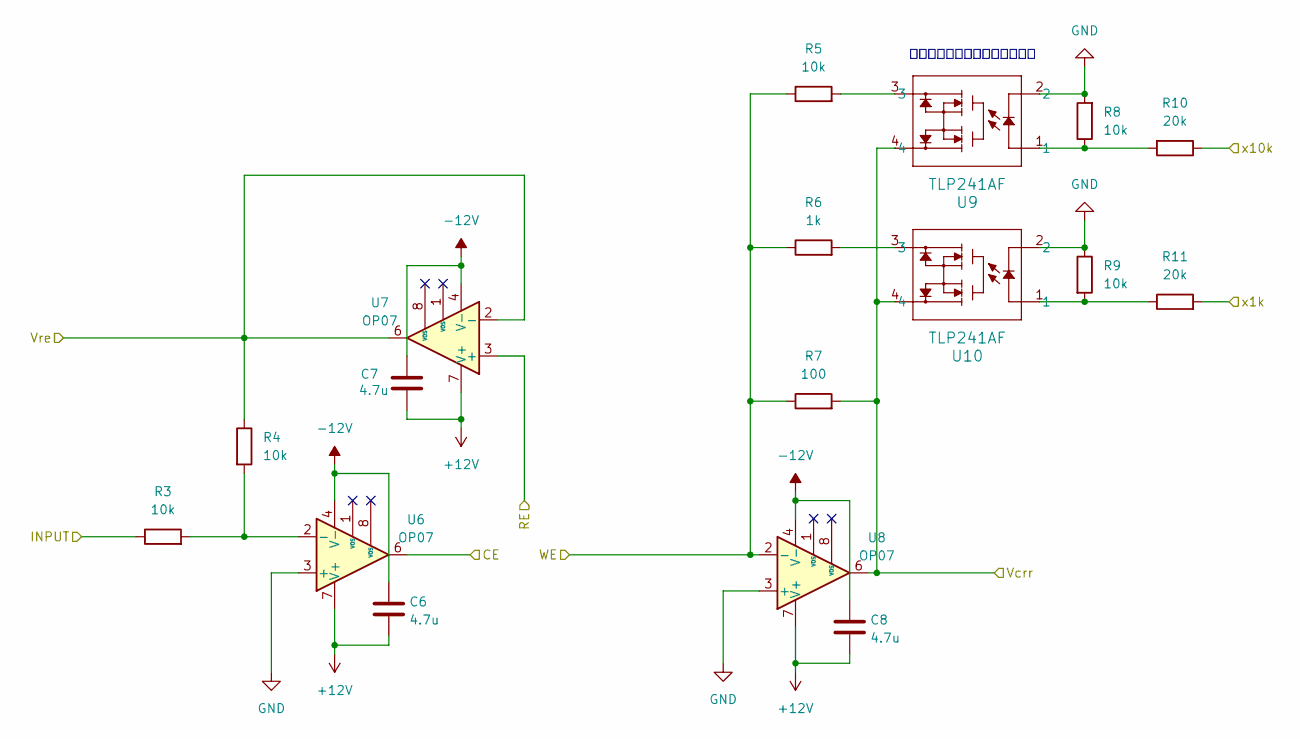
[picture p105: schematic untitled.kicad_sch]

Parts:
C6, C7, C8: 4.7u; C_1206_3216Metric
R3, R4, R5, R8, R9: 10k; R_0603_1608Metric
R6: 1k; R_0603_1608Metric
R7: 100; R_0603_1608Metric
R10, R11: 20k; R_0603_1608Metric
U6, U7, U8: OP07; DIP-8_W7.62mm
U9, U10: TLP241AF; DIP4_TOS

Connections:
+12V: C6.1, C7.1, C8.1, U6.7 (V+), U7.7 (V+), U8.7 (V+); also elsewhere on the board
-12V: C6.2, C7.2, C8.2, U6.4 (V-), U7.4 (V-), U8.4 (V-); also elsewhere on the board
/PotentioStatUnit/CE: U6.6; also elsewhere on the board
/PotentioStatUnit/INPUT: R3.1; also elsewhere on the board
/PotentioStatUnit/RE: U7.3 (+); also elsewhere on the board
/PotentioStatUnit/Vcrr: R7.2, U8.6, U9.4, U10.4; also elsewhere on the board
/PotentioStatUnit/Vre: R4.1, U7.2 (-), U7.6
/PotentioStatUnit/WE: R5.1, R6.1, R7.1, U8.2 (-); also elsewhere on the board
GND: R8.2, R9.1, U6.3 (+), U8.3 (+), U9.2, U10.2; also elsewhere on the board
unnamed: R5.2, U9.3
unnamed: R6.2, U10.3
unnamed: R8.1, R10.2, U9.1
unnamed: R9.2, R11.1, U10.1
unnamed: R3.2, R4.2, U6.2 (-)
x1k_2: R11.2; also elsewhere on the board
x10k_2: R10.1; also elsewhere on the board

Parts of its further copies:
C10, C11, C12: 4.7u; C_1206_3216Metric
R16, R17, R18, R21, R22: 10k; R_0603_1608Metric
R19: 1k; R_0603_1608Metric
R20: 100; R_0603_1608Metric
R23, R24: 20k; R_0603_1608Metric
U12, U13, U14: OP07; DIP-8_W7.62mm
U15, U16: TLP241AF; DIP4_TOS

Connections of its further copies:
+12V: C10.1, C11.1, C12.1, U12.7 (V+), U13.7 (V+), U14.7 (V+); also elsewhere on the board
-12V: C10.2, C11.2, C12.2, U12.4 (V-), U13.4 (V-), U14.4 (V-); also elsewhere on the board
/PotentioStatUnit1/CE: U12.6; also elsewhere on the board
/PotentioStatUnit1/INPUT: R16.1; also elsewhere on the board
/PotentioStatUnit1/RE: U13.3 (+); also elsewhere on the board
/PotentioStatUnit1/Vcrr: R20.2, U14.6, U15.4, U16.4; also elsewhere on the board
/PotentioStatUnit1/Vre: R17.1, U13.2 (-), U13.6
/PotentioStatUnit1/WE: R18.1, R19.1, R20.1, U14.2 (-); also elsewhere on the board
GND: R21.2, R22.1, U12.3 (+), U14.3 (+), U15.2, U16.2; also elsewhere on the board
unnamed: R18.2, U15.3
unnamed: R19.2, U16.3
unnamed: R21.1, R23.2, U15.1
unnamed: R22.2, R24.1, U16.1
unnamed: R16.2, R17.2, U12.2 (-)
x1k_1: R24.2; also elsewhere on the board
x10k_1: R23.1; also elsewhere on the board

Notes on the sheet:
推奨電流に足りていない可能性

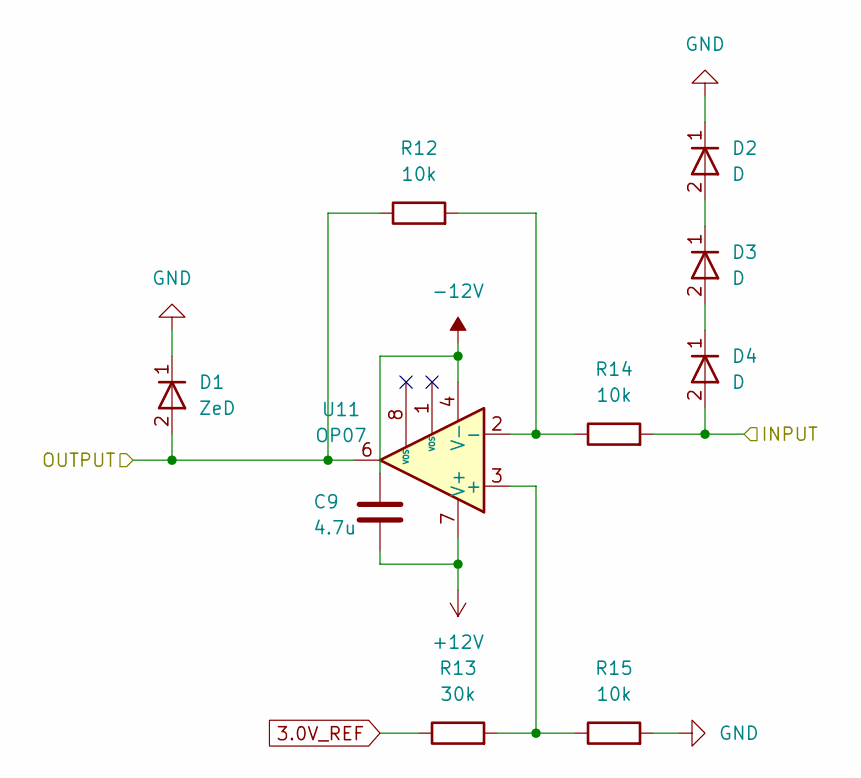
[picture p106: schematic Inverting.kicad_sch]

Parts:
C9: 4.7u; C_1206_3216Metric
D1: ZeD; D_DO-34_SOD68_P7.62mm_Horizontal
D2, D3, D4: D; D_DO-34_SOD68_P7.62mm_Horizontal
R12, R14, R15: 10k; R_0603_1608Metric
R13: 30k; R_0603_1608Metric
U11: OP07; DIP-8_W7.62mm

Connections:
3.0V_REF: R13.1; also elsewhere on the board
+12V: C9.2, U11.7 (V+); also elsewhere on the board
-12V: C9.1, U11.4 (V-); also elsewhere on the board
/PotentioStatUnit/Vcrr: D4.2 (A), R14.2; also elsewhere on the board
/反転回路/OUTPUT: D1.2 (A), R12.1, U11.6; also elsewhere on the board
GND: D1.1 (K), D2.1 (K), R15.2; also elsewhere on the board
unnamed: D2.2 (A), D3.1 (K)
unnamed: D3.2 (A), D4.1 (K)
unnamed: R13.2, R15.1, U11.3 (+)
unnamed: R12.2, R14.1, U11.2 (-)

Parts of its further copies:
C13: 4.7u; C_1206_3216Metric
D5: ZeD; D_DO-34_SOD68_P7.62mm_Horizontal
D6, D7, D8: D; D_DO-34_SOD68_P7.62mm_Horizontal
R25, R27, R28: 10k; R_0603_1608Metric
R26: 30k; R_0603_1608Metric
U17: OP07; DIP-8_W7.62mm

Connections of its further copies:
3.0V_REF: R26.1; also elsewhere on the board
+12V: C13.2, U17.7 (V+); also elsewhere on the board
-12V: C13.1, U17.4 (V-); also elsewhere on the board
/PotentioStatUnit1/Vcrr: D8.2 (A), R27.2; also elsewhere on the board
/反転回路1/OUTPUT: D5.2 (A), R25.1, U17.6; also elsewhere on the board
GND: D5.1 (K), D6.1 (K), R28.2; also elsewhere on the board
unnamed: D6.2 (A), D7.1 (K)
unnamed: D7.2 (A), D8.1 (K)
unnamed: R26.2, R28.1, U17.3 (+)
unnamed: R25.2, R27.1, U17.2 (-)

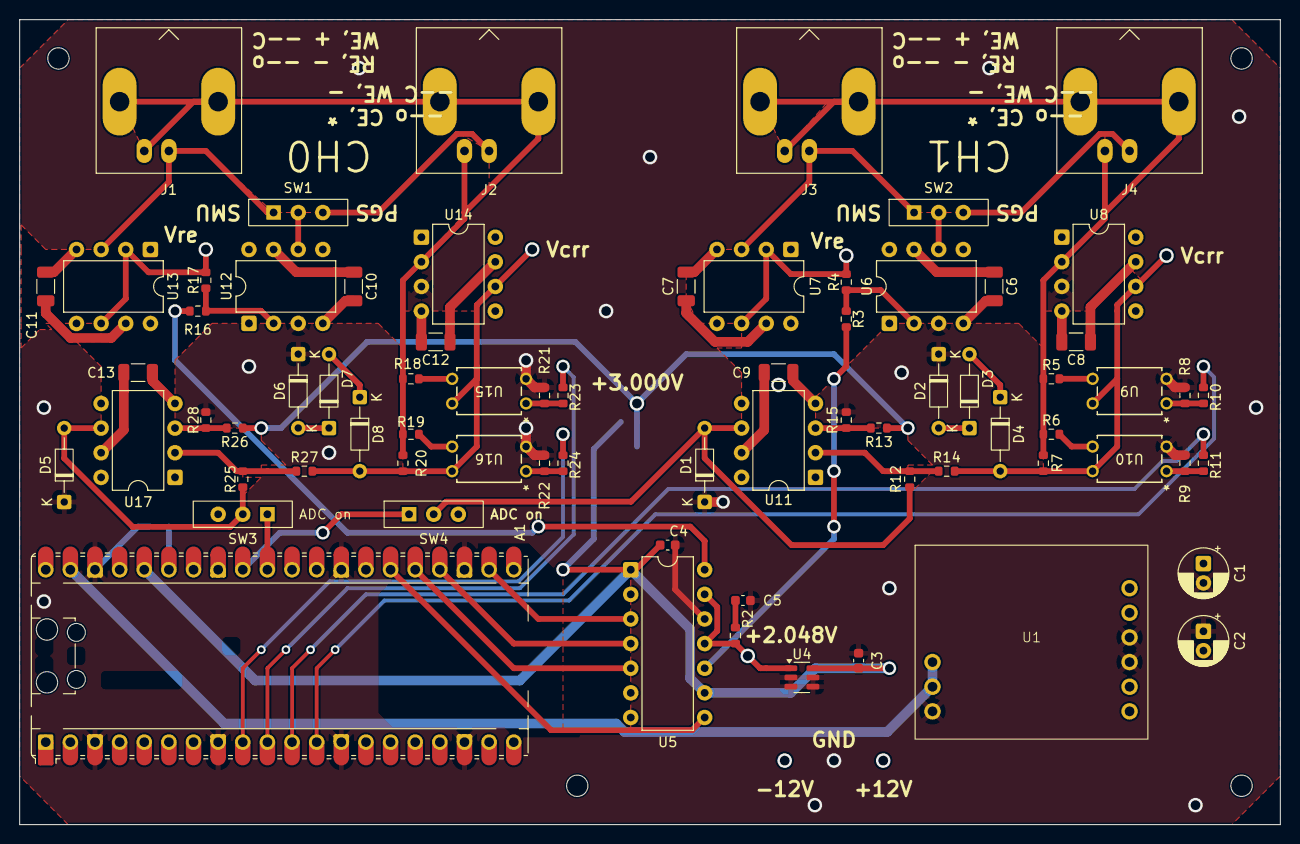
[picture p107: board Circuit/PrintedCircuit2/SMU2/SMU.kicad_pcb from above]

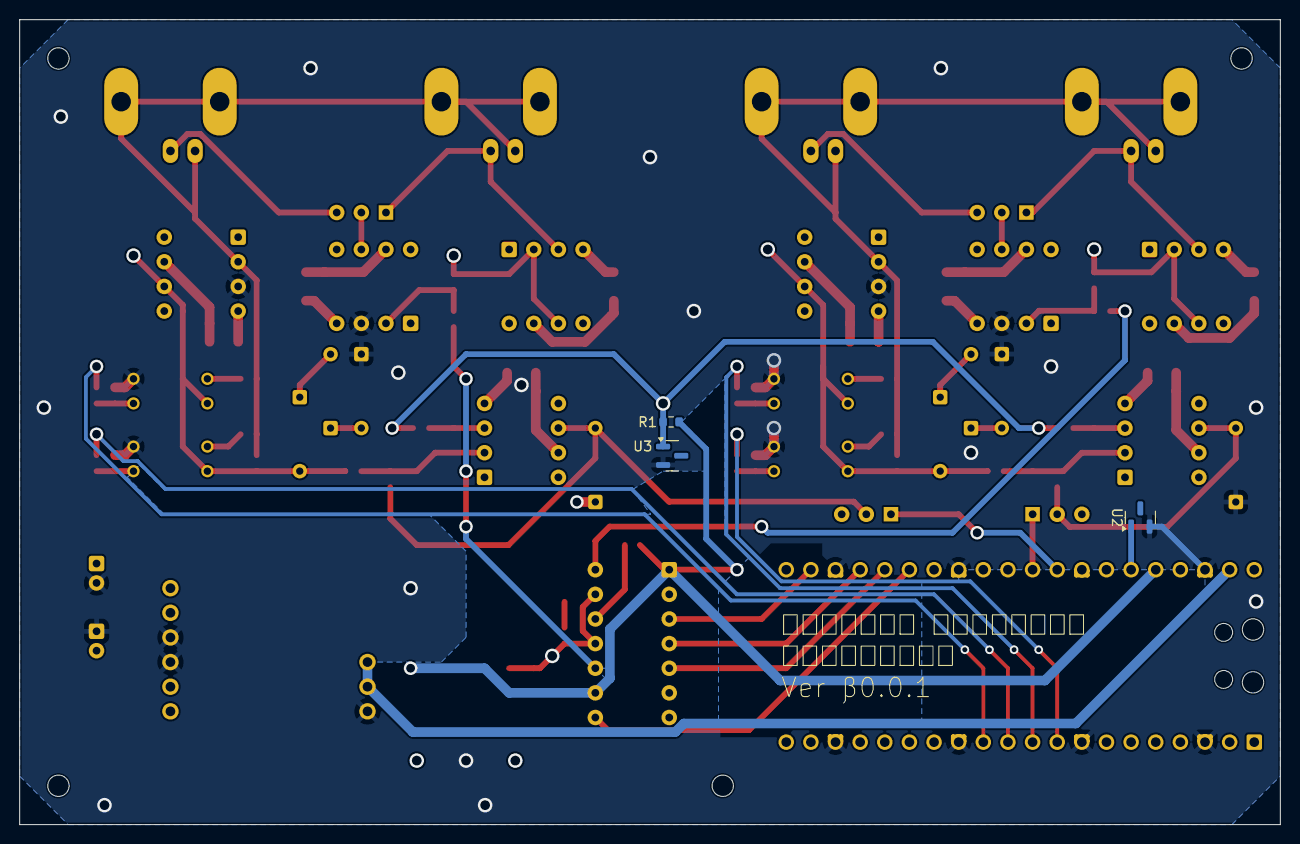
[picture p108: board Circuit/PrintedCircuit2/SMU2/SMU.kicad_pcb from below]

Board: 6 copper layers, 130.0 x 83.0 mm, 75 parts (3 on the bottom side), 53 nets.

Other parts of the board:
SW3, SW4: SW_SPDT; SW_Slide-03_Wuerth-WS-SLTV_10x2.5x6.4_P2.54mm

Their connections:
/反転回路1/OUTPUT: SW3.2 (B); also elsewhere on the board
/反転回路/OUTPUT: SW4.2 (B); also elsewhere on the board
unnamed 25: SW3.1 (A); also elsewhere on the board
unnamed 26: SW4.1 (A); also elsewhere on the board
