oosan1/OriginalSMU_KKHS/Circuit/PrintedCircuit2/SMU/SMU.kicad_pcb

## KiCad design Circuit/PrintedCircuit2/SMU/SMU.kicad_pcb (2025-06-21, an earlier design)

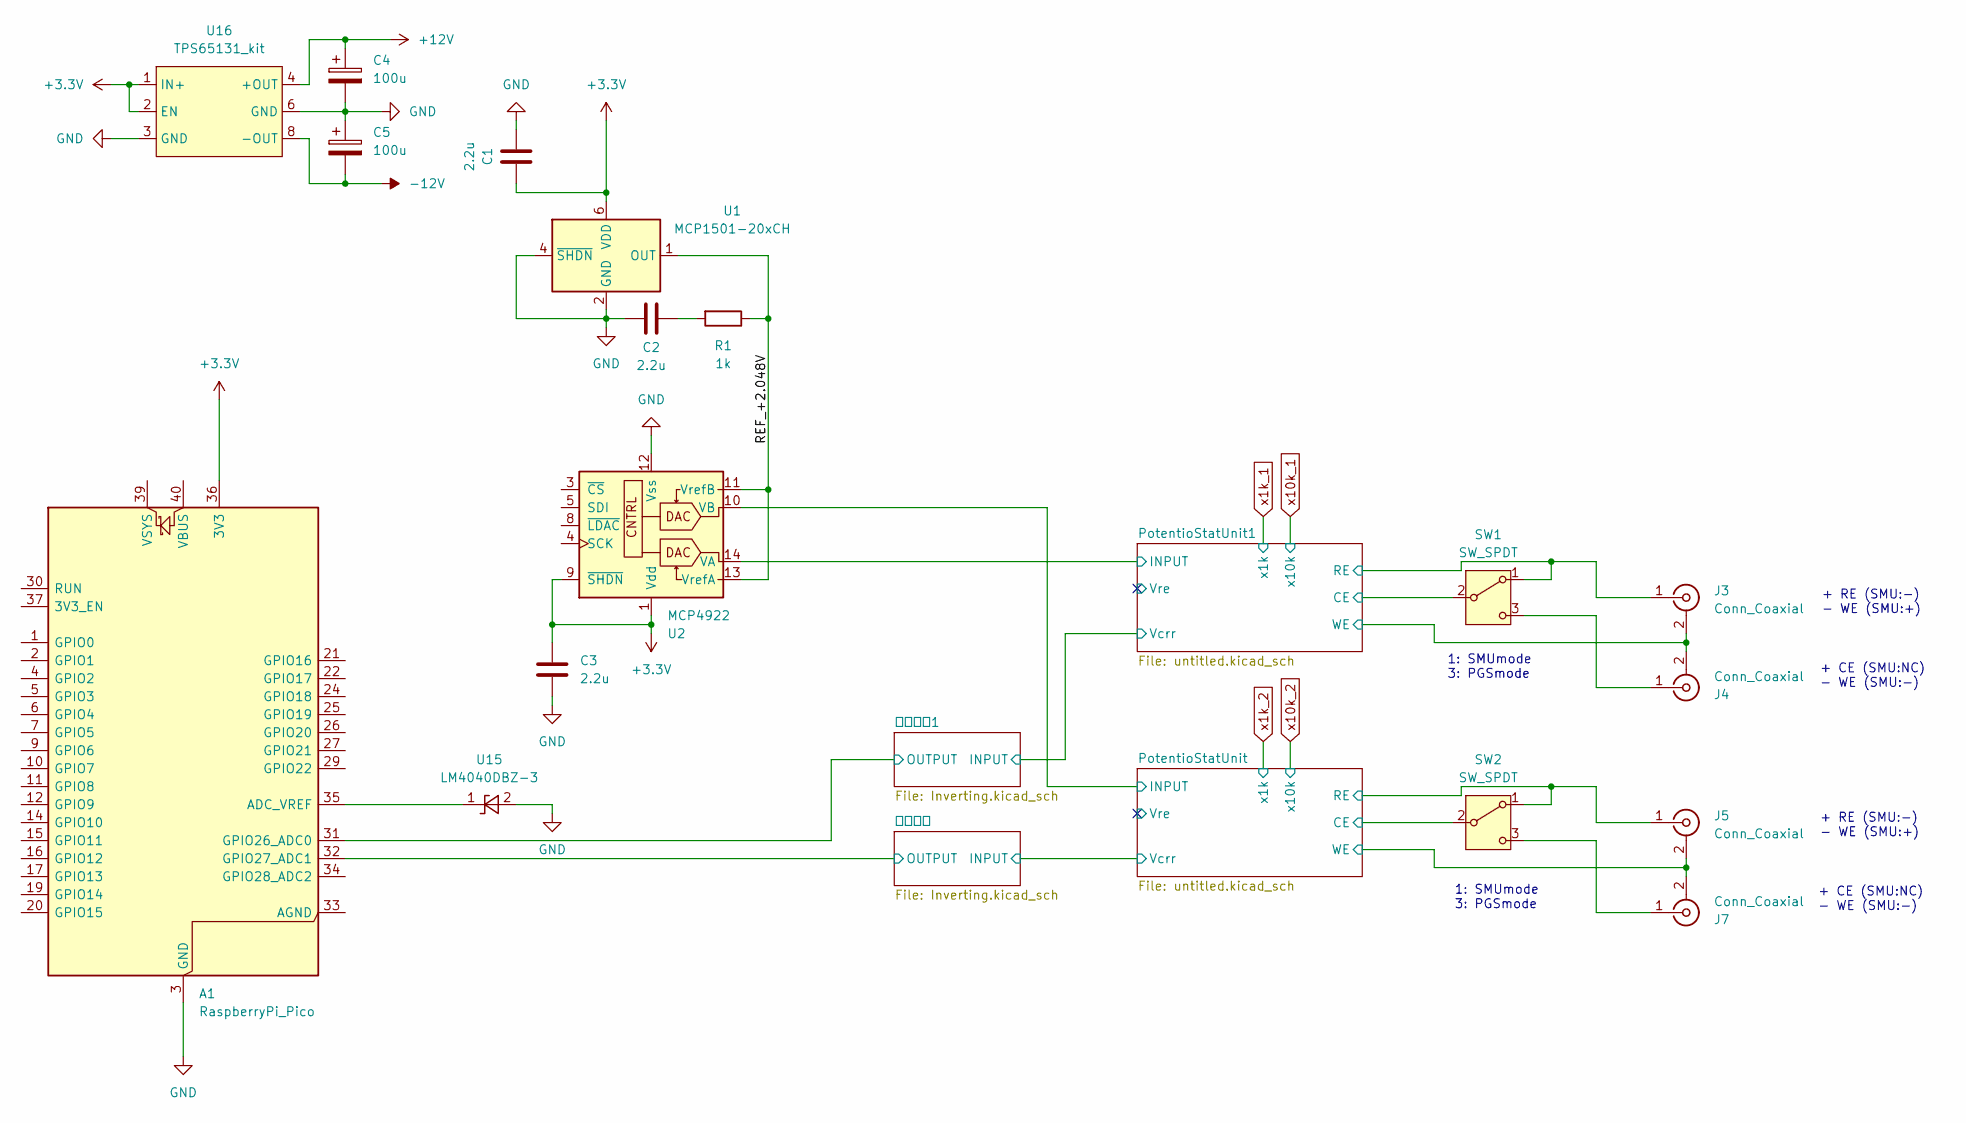
[picture p109: schematic SMU.kicad_sch]

Parts:
A1: RaspberryPi_Pico; RaspberryPi_Pico_Common_Unspecified
C1, C2, C3: 2.2u; C_0603_1608Metric
C4, C5: 100u
J3, J4, J5, J7: Conn_Coaxial; BNC_Amphenol_B6252HB-NPP3G-50_Horizontal
R1: 1k; R_0603_1608Metric
SW1, SW2: SW_SPDT; SW_Slide-03_Wuerth-WS-SLTV_10x2.5x6.4_P2.54mm
U1: MCP1501-20xCH; SOT-23-6
U2: MCP4922; DIP-14_W7.62mm
U15: LM4040DBZ-3; SOT-23
U16: TPS65131_kit

Connections:
+3.3V: A1.36 (3V3), C1.2, C3.1, U1.6 (VDD), U2.1 (Vdd), U2.9 (~SHDN), U16.1 (IN+), U16.2 (EN)
+12V: C4.1, U16.4 (+OUT), U16.5 (+OUT); also elsewhere on the board
-12V: C5.2, U16.8 (-OUT), U16.9 (-OUT); also elsewhere on the board
/PotentioStatUnit1/CE: SW1.2 (B); also elsewhere on the board
/PotentioStatUnit1/INPUT: U2.14 (VA); also elsewhere on the board
/PotentioStatUnit1/RE: J3.1 (In), SW1.1 (A); also elsewhere on the board
/PotentioStatUnit1/WE: J3.2 (Ext), J4.2 (Ext); also elsewhere on the board
/PotentioStatUnit/CE: SW2.2 (B); also elsewhere on the board
/PotentioStatUnit/INPUT: U2.10 (VB); also elsewhere on the board
/PotentioStatUnit/RE: J5.1 (In), SW2.1 (A); also elsewhere on the board
/PotentioStatUnit/WE: J5.2 (Ext), J7.2 (Ext); also elsewhere on the board
/REF_+2.048V: R1.1, U1.1 (OUT), U2.11 (VrefB), U2.13 (VrefA)
/反転回路1/OUTPUT: A1.31 (GPIO26_ADC0); also elsewhere on the board
/反転回路/OUTPUT: A1.32 (GPIO27_ADC1); also elsewhere on the board
GND: A1.3 (GND), A1.8 (GND), A1.13 (GND), A1.18 (GND), A1.23 (GND), A1.28 (GND), A1.38 (GND), C1.1, C2.1, C3.2, C4.2, C5.1, U1.2 (GND), U1.3 (GND), U1.4 (~SHDN), U1.5 (GND), U2.12 (Vss), U15.2 (A), U16.3 (GND), U16.6 (GND), U16.7 (GND); also elsewhere on the board
unnamed: A1.35 (ADC_VREF), U15.1 (K)
unnamed: A1.22 (GPIO17), U2.3 (~CS)
unnamed: A1.24 (GPIO18), U2.4 (SCK)
unnamed: A1.25 (GPIO19), U2.5 (SDI)
unnamed: A1.26 (GPIO20), U2.8 (~LDAC)
unnamed: C2.2, R1.2
unnamed: J4.1 (In), SW1.3 (C)
unnamed: J7.1 (In), SW2.3 (C)
x1k_1: A1.9 (GPIO6); also elsewhere on the board
x1k_2: A1.11 (GPIO8); also elsewhere on the board
x10k_1: A1.10 (GPIO7); also elsewhere on the board
x10k_2: A1.12 (GPIO9); also elsewhere on the board

Notes on the sheet:
+ RE (SMU:-) - WE (SMU:+)
1: SMUmode 3: PGSmode
+ CE (SMU:NC) - WE (SMU:-)
