oosan1/OriginalSMU_KKHS/Circuit/PrintedCircuit2/SMU/SMU.kicad_pcb

## KiCad design Circuit/PrintedCircuit2/SMU/SMU.kicad_pcb (continued)

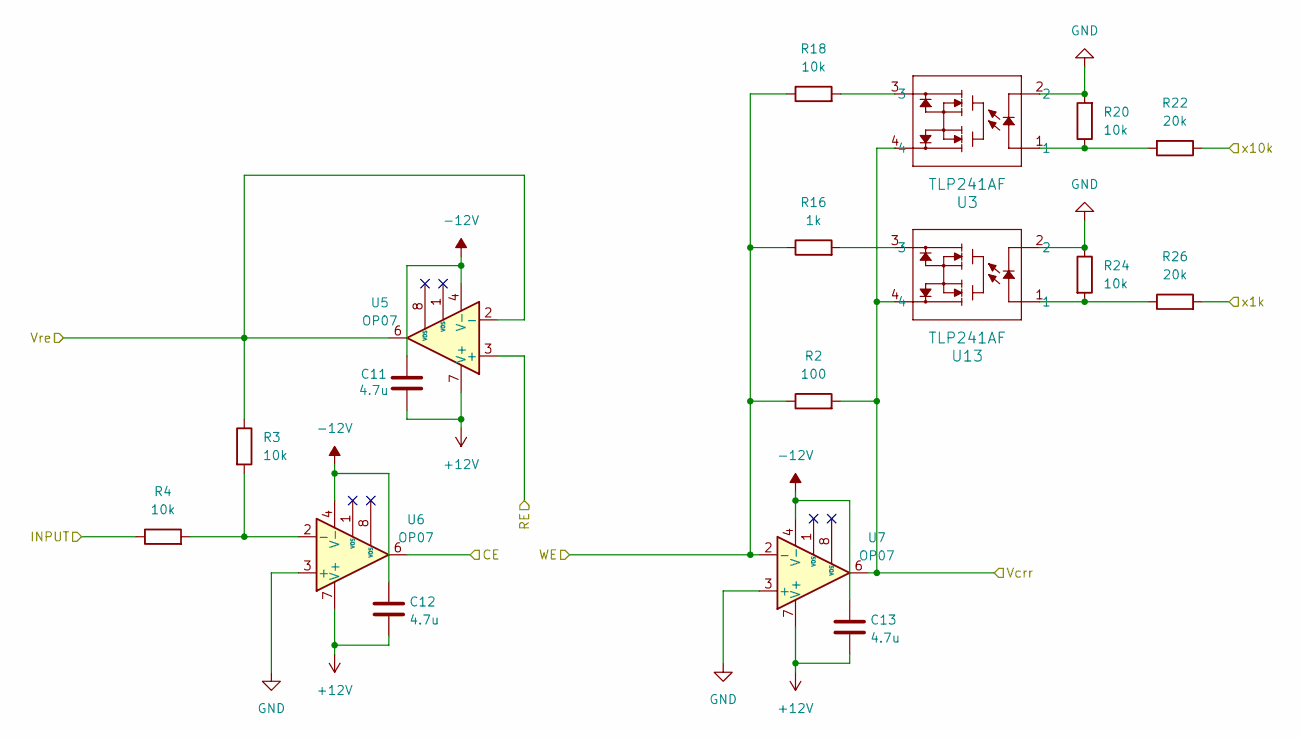
[picture p110: schematic untitled.kicad_sch]

Parts:
C11, C12, C13: 4.7u; C_1206_3216Metric
R2: 100
R3, R4: 10k; R_0603_1608Metric
R16: 1k
R18, R20, R24: 10k
R22, R26: 20k
U3, U13: TLP241AF; DIP4_TOS
U5, U6, U7: OP07; DIP-8_W7.62mm

Connections:
+12V: C11.1, C12.1, C13.1, U5.7 (V+), U6.7 (V+), U7.7 (V+); also elsewhere on the board
-12V: C11.2, C12.2, C13.2, U5.4 (V-), U6.4 (V-), U7.4 (V-); also elsewhere on the board
/PotentioStatUnit/CE: U6.6; also elsewhere on the board
/PotentioStatUnit/INPUT: R4.1; also elsewhere on the board
/PotentioStatUnit/RE: U5.3 (+); also elsewhere on the board
/PotentioStatUnit/Vcrr: R2.2, U3.4, U7.6, U13.4; also elsewhere on the board
/PotentioStatUnit/Vre: R3.1, U5.2 (-), U5.6
/PotentioStatUnit/WE: R2.1, R16.1, R18.1, U7.2 (-); also elsewhere on the board
GND: R20.2, R24.1, U3.2, U6.3 (+), U7.3 (+), U13.2; also elsewhere on the board
unnamed: R16.2, U13.3
unnamed: R18.2, U3.3
unnamed: R20.1, R22.2, U3.1
unnamed: R24.2, R26.1, U13.1
unnamed: R3.2, R4.2, U6.2 (-)
x1k_2: R26.2; also elsewhere on the board
x10k_2: R22.1; also elsewhere on the board

Parts of its further copies:
C16, C17, C18: 4.7u; C_1206_3216Metric
R9: 100
R10, R11: 10k; R_0603_1608Metric
R17: 1k
R19, R21, R25: 10k
R23, R27: 20k
U4, U14: TLP241AF; DIP4_TOS
U9, U10, U11: OP07; DIP-8_W7.62mm

Connections of its further copies:
+12V: C16.1, C17.1, C18.1, U9.7 (V+), U10.7 (V+), U11.7 (V+); also elsewhere on the board
-12V: C16.2, C17.2, C18.2, U9.4 (V-), U10.4 (V-), U11.4 (V-); also elsewhere on the board
/PotentioStatUnit1/CE: U10.6; also elsewhere on the board
/PotentioStatUnit1/INPUT: R11.1; also elsewhere on the board
/PotentioStatUnit1/RE: U9.3 (+); also elsewhere on the board
/PotentioStatUnit1/Vcrr: R9.2, U4.4, U11.6, U14.4; also elsewhere on the board
/PotentioStatUnit1/Vre: R10.1, U9.2 (-), U9.6
/PotentioStatUnit1/WE: R9.1, R17.1, R19.1, U11.2 (-); also elsewhere on the board
GND: R21.2, R25.1, U4.2, U10.3 (+), U11.3 (+), U14.2; also elsewhere on the board
unnamed: R17.2, U14.3
unnamed: R19.2, U4.3
unnamed: R21.1, R23.2, U4.1
unnamed: R25.2, R27.1, U14.1
unnamed: R10.2, R11.2, U10.2 (-)
x1k_1: R27.2; also elsewhere on the board
x10k_1: R23.1; also elsewhere on the board

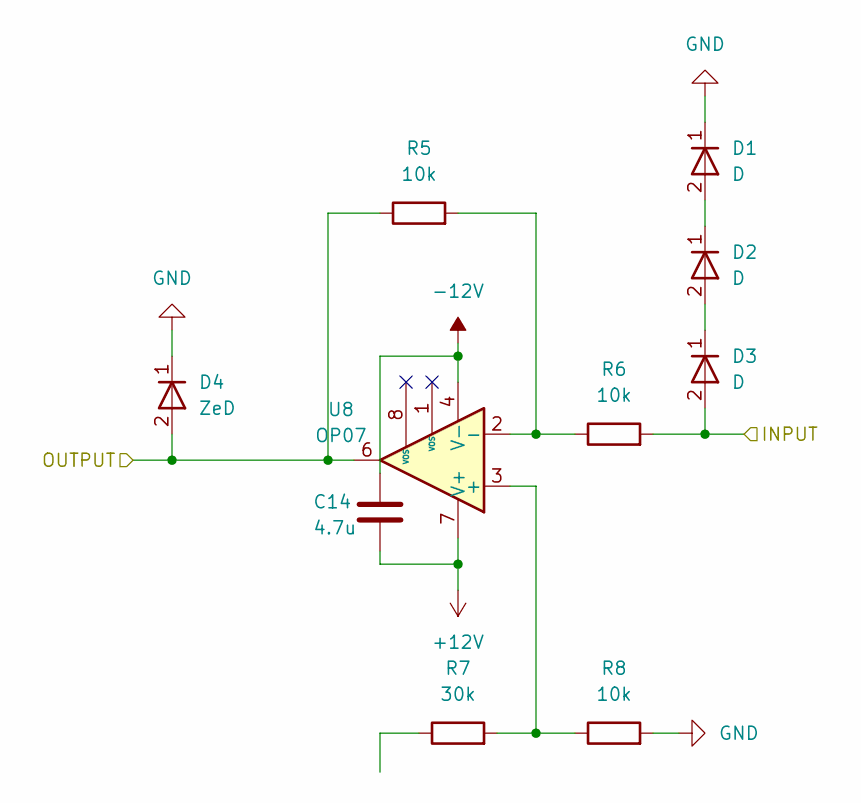
[picture p111: schematic Inverting.kicad_sch]

Parts:
C14: 4.7u; C_1206_3216Metric
D1, D2, D3: D; D_T-1_P5.08mm_Horizontal
D4: ZeD; D_T-1_P5.08mm_Horizontal
R5, R6, R8: 10k; R_0603_1608Metric
R7: 30k; R_0603_1608Metric
U8: OP07; DIP-8_W7.62mm

Connections:
+12V: C14.2, U8.7 (V+); also elsewhere on the board
-12V: C14.1, U8.4 (V-); also elsewhere on the board
/PotentioStatUnit/Vcrr: D3.2 (A), R6.2; also elsewhere on the board
/反転回路/OUTPUT: D4.2 (A), R5.1, U8.6; also elsewhere on the board
GND: D1.1 (K), D4.1 (K), R8.2; also elsewhere on the board
unnamed: D1.2 (A), D2.1 (K)
unnamed: D2.2 (A), D3.1 (K)
unnamed: R7.2, R8.1, U8.3 (+)
unnamed: R5.2, R6.1, U8.2 (-)

Parts of its further copies:
C19: 4.7u; C_1206_3216Metric
D5, D6, D7: D; D_T-1_P5.08mm_Horizontal
D8: ZeD; D_T-1_P5.08mm_Horizontal
R12, R13, R15: 10k; R_0603_1608Metric
R14: 30k; R_0603_1608Metric
U12: OP07; DIP-8_W7.62mm

Connections of its further copies:
+12V: C19.2, U12.7 (V+); also elsewhere on the board
-12V: C19.1, U12.4 (V-); also elsewhere on the board
/PotentioStatUnit1/Vcrr: D7.2 (A), R13.2; also elsewhere on the board
/反転回路1/OUTPUT: D8.2 (A), R12.1, U12.6; also elsewhere on the board
GND: D5.1 (K), D8.1 (K), R15.2; also elsewhere on the board
unnamed: D5.2 (A), D6.1 (K)
unnamed: D6.2 (A), D7.1 (K)
unnamed: R14.2, R15.1, U12.3 (+)
unnamed: R12.2, R13.1, U12.2 (-)

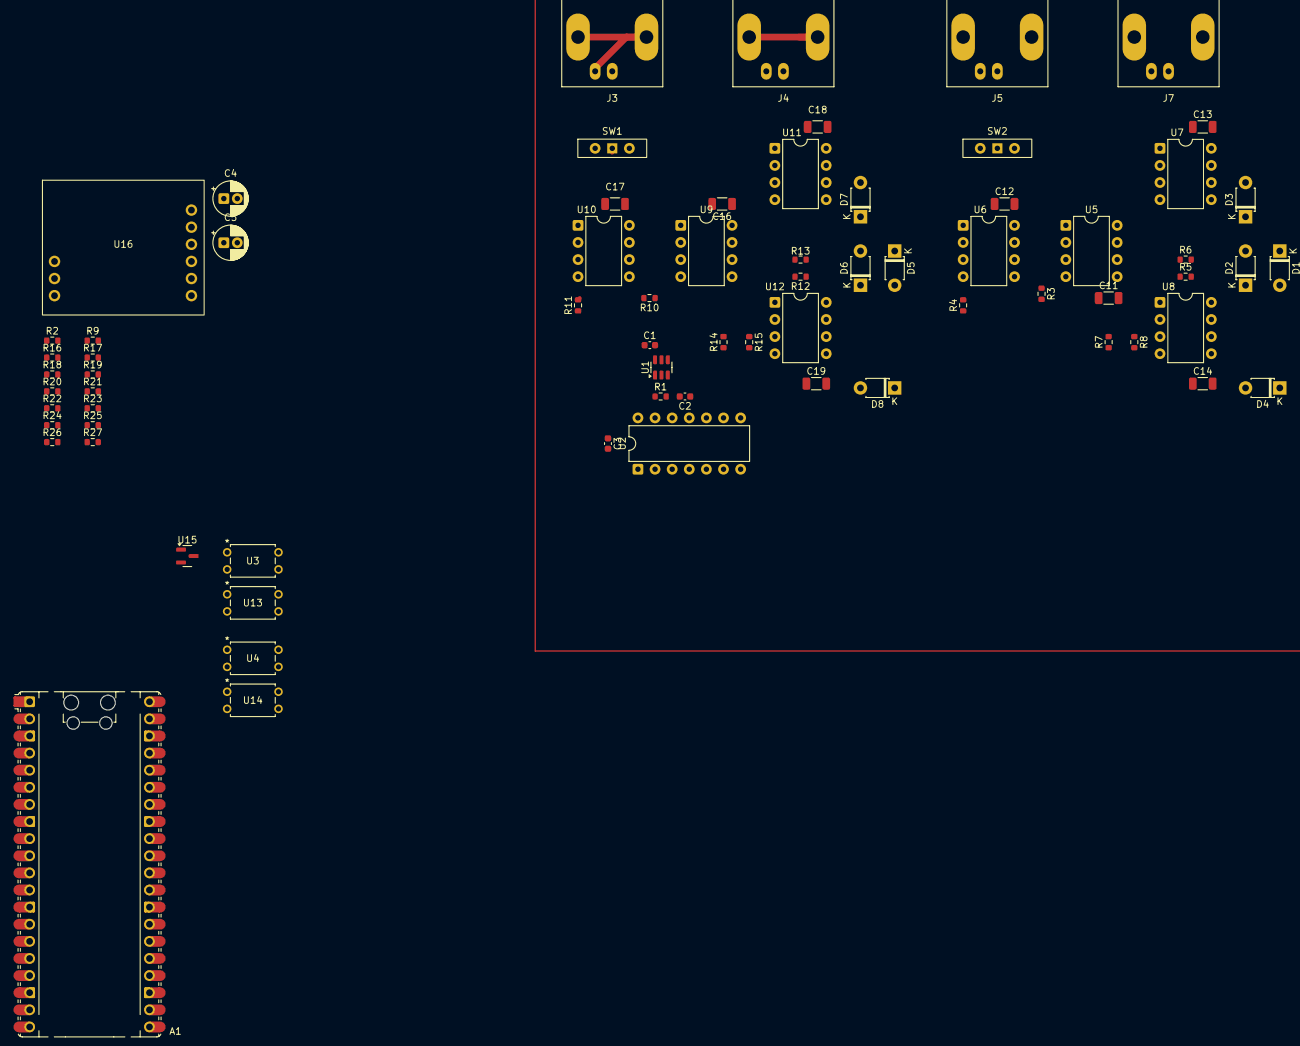
[picture p112: board Circuit/PrintedCircuit2/SMU/SMU.kicad_pcb from above]

Board: 6 copper layers, 71 parts (0 on the bottom side), 49 nets.
