oosan1/OriginalSMU_KKHS/(commit log)

2025-01-30 webクライアントを追加
2025-01-30 SMUの回路図等を追加
    [ADconverter.kicad_sch, DAconverter.kicad_sch, Potentiostat.kicad_sch, PowerSupply.kicad_sch, RootProject_SMU.kicad_pcb, RootProject_SMU.kicad_sch]
2025-01-30 シリアルの接続処理を追加
2025-01-30 シリアルコンソールの表示部分を追加
2025-01-30 シリアルの書き込み機能を追加
2025-01-30 シリアルの読み取り処理を追加(バグあり)
2025-02-02 SMUの各部分の配線を追加
    [Potentiostat.kicad_sch, PowerSupply.kicad_sch, RootProject_SMU.kicad_sch]
2025-02-02 各部品の配線が完了。部品表を作り、発注書を作成。
    [Potentiostat.kicad_sch, RootProject_SMU.kicad_sch]
2025-02-10 PWMのテスト用プログラム追加
2025-02-10 シリアル読み込みのバグ除去
2025-02-10 電気化学インピーダンス法用のシミュレーション回路を追加
    [Electrochemical_impedance.kicad_pcb, Electrochemical_impedance.kicad_sch, imTest01.csv, imTest01_converd.csv, imTest02.csv, imTest02_converd.csv, imTest03.csv, imTest03_converd.csv]
2025-02-11 ファイル名変更(長すぎるとエラーが出るため)
    [E_im.kicad_pcb, E_im.kicad_sch, Electrochemical_impedance.kicad_pcb, Electrochemical_impedance.kicad_sch, imData01_conv.csv, imData02_conv.csv, imData06_conv.csv, imData07_conv.csv]
2025-03-09 シリアル書き込みの不具合を修正
2025-03-09 ファイル構成を変更、シミュレーション用ファイルを追加
    [ADconverter.kicad_sch, BD87521_HP_SPICE.olb, BD87581_HP_SPICE.olb, DAconverter.kicad_sch, Potentiostat.kicad_sch, PowerSupply.kicad_sch, RootProject_SMU.kicad_pcb, RootProject_SMU.kicad_sch]
2025-03-17 実回路に合わせてシミュレーション回路を調整
    [potentio_stat.kicad_sch]
2025-03-17 シリアル通信プロトコルに合わせてIVカーブ測定プログラムを変更
2025-03-17 コントロールパネル、グラフエリアを追加 IVカーブの測定、CSV出力をブラウザで完結可能に
2025-03-17 Kicadのバックアップファイルを追跡しないよう変更 Testフォルダは不要なため、削除
2025-03-19 gitignoreを修正
2025-03-19 プリント基板: 電源ユニット
    [PowerSupply.kicad_pcb, PowerSupply.kicad_sch]
2025-03-25 プリント基板: マイコン基板完成
    [Control.kicad_pcb, Control.kicad_sch]
2025-03-26 MicroPython版を更新
2025-03-26 C言語版を追加
2025-03-29 main3に校正機能を追加
2025-03-29 main3の校正機能にウェブクライアントとの連携機能を追加
2025-03-29 校正状態を表示するよう変更、displayをflexに変更
2025-03-30 シリアルコンソールの色変更機能追加 記録中のコンソール出力を無効にし、軽量化
2025-03-30 Control基板完成
    [Control.kicad_sch, SMU.kicad_pcb, SMU.kicad_sch]
2025-03-30 C版にコマンド解析を追加
2025-03-30 C版にADC,DAC制御コマンドを追加
2025-03-30 C版にIVsweepとIVcurveコマンド追加
2025-03-30 C版に対応
2025-03-30 C版完成、フラッシュ用に変更
2025-04-01 基盤にテストポイントを追加、SMUにDACとPSを追加
    [Control.kicad_sch, SMU.kicad_sch, Sim2.kicad_pcb, Sim2.kicad_sch, untitled.kicad_sch]
2025-04-02 保護回路のシミュレーションを追加
    [Control.kicad_sch, SMU.kicad_sch, sim.kicad_pcb, sim.kicad_sch, untitled.kicad_sch]
2025-04-03 SMUのプリント基板回路図完成
    [Inverting.kicad_sch, SMU.kicad_sch, potentio_stat.kicad_sch, untitled.kicad_sch]
2025-04-04 フットプリント設定
    [Control.kicad_sch, Inverting.kicad_sch, SMU.kicad_sch, untitled.kicad_sch]
2025-04-13 電気化学インピーダンス用アップデート
    [Inverting.kicad_sch, SMU.kicad_pcb, SMU.kicad_sch, potentio_stat.kicad_sch, untitled.kicad_sch]
2025-04-24 EISコマンドを追加
2025-04-24 EISシミュレーションを追加
    [potentio_stat.kicad_sch]
2025-04-26 WEとCEが逆転していた不具合を修正
    [SMU.kicad_sch, untitled.kicad_sch]
2025-05-03 SMUのPCBを編集
    [ADconverter.kicad_sch, DAconverter.kicad_sch, Inverting.kicad_sch, Potentiostat.kicad_sch, PowerSupply.kicad_sch, RootProject_SMU.kicad_pcb, RootProject_SMU.kicad_sch, SMU.kicad_pcb]
2025-05-05 クライアントとマイコンにEISを追加
2025-05-10 クライアントをEISに対応
2025-05-10 マイコンのEISを反転回路に対応
2025-05-25 デザイン等を変更
2025-05-25 EISで周期性を向上
2025-05-25 EISの連続実行、colabでの自動解析に対応
2025-06-21 回路を更新
    [Control.kicad_pcb, Control.kicad_sch, DIP4_90deg.stl, Inverting.kicad_sch, Potentiostat.kicad_sch, PowerSupply.kicad_pcb, PowerSupply.kicad_sch, SMU.kicad_pcb]
2025-06-21 回路を更新2
    [DIP4_90deg.stl, Inverting.kicad_sch, SMU.kicad_pcb, SMU.kicad_sch, sim5.kicad_pcb, sim5.kicad_sch, untitled.kicad_sch]
2025-06-22 β0.0.1の基板データが完成
    [BOM-SMU.csv, DIP4_90deg.step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]
2025-06-24 チャンネルを減らし、基板層数を削減
    [BOM-SMU.csv, DIP4_90deg.step, DIP4_90deg.stl, Inverting.kicad_sch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]
2025-06-25 実装を表に集中
    [SMU.kicad_pcb]
2025-07-04 3Dモデルを更新
    [73100-0131.STEP, BNC_3D.step, BOM-SMU.csv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]
2025-07-12 ロゴ画像を追加
2025-07-14 β0.0.3
    [Inverting.kicad_sch, SMU.kicad_pcb, SMU.kicad_sch, logo.dxf, untitled.kicad_sch, v2_case_huta.3mf, v2_case_top.3mf, v2_case_under.3mf]
2025-07-18 保護回路を変更
    [Inverting.kicad_sch, SMU.kicad_pcb, SMU.kicad_sch, untitled.kicad_sch]
2025-07-18 ADC.DAC電圧の可変に対応
    [BOM-SMU.csv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]
2025-07-24 平均化機能を追加
    [ADconverter.kicad_sch, DAconverter.kicad_sch, Potentiostat.kicad_sch, PowerSupply.kicad_sch, RootProject_SMU.kicad_sch]
2025-07-24 ケースを更新
    [ADconverter.kicad_sch, DAconverter.kicad_sch, Potentiostat.kicad_sch, PowerSupply.kicad_sch, RootProject_SMU.kicad_sch, v3_case_huta.3mf, v3_case_top.3mf, v3_case_under.3mf]
2025-07-24 電流電圧変換抵抗の制御プログラムを追加
2025-08-05 測定待機時間を変更
    [Potentiostat.kicad_sch]
2025-09-23 電圧データをstep表記かつ、生データへ統一。 ただし、未完成、実機では未検証
2025-09-23 ver0.0.4の基板データ完成
    [73100-0131.STEP, BNC_3D.step, BOM-SMU.csv, DIP4_90deg.step, DIP4_90deg.stl, Inverting.kicad_sch, Potentiostat.kicad_sch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]
2025-09-24 マイコンにおいて、setVol, readVol, IVsweepコマンドをstep表記に統一。電圧の変化を可変ステップにすることに対応。他のコマンドは非推奨。
2025-09-24 step表記でのコマンド、ブラウザ上でのDAC, ADC設定の変更、可変電圧間隔のIVカーブ測定に対応。 EIS測定はまだ非対応
2025-09-27 マイコンが電流のレンジ操作に対応
2025-09-27 電流レンジの操作をクライアントに追加
2025-09-28 サイクリックモードにて、抵抗切り替え時間が長くなってしまう不具合を修正
2025-09-28 平均化機能をマイコンに追加
2025-09-28 平均化機能と安定用直列抵抗の補正機能をクライアントに追加
2025-10-05 クライアントソフトにバージョン表示を追加
2025-10-06 説明書を追加
2025-10-28 マイコン: 掃引方向の反転、リアルタイム送信に対応
2025-10-28 クライアント: 掃引方向の反転、リアルタイム送信に対応
2025-10-29 クライアント,マイコン：連続測定に対応
2025-10-30 IVカーブ測定時のボタン無効j化タイミングを調整
2025-10-30 オフラインモードを追加
2025-11-01 USBシリアルのカスタム名に対応
2025-11-01 32bitカウンターのオーバーフローにより、測定速度が不安定になる不具合を解消。ログに含まれる起動時間をより見やすく。
2025-11-01 picoへの書き込みを容易にするバッチファイルを追加
2025-11-01 デバッグ用命令を追加
2025-11-02 デバッグ用関数を追加
2025-11-02 RaspberrypiPicoのみを表示するよう、フィルターを追加
2025-11-02 接続時の例外処理を追加
2025-11-02 アイコン関係を追加
2025-11-02 機器バージョンの取得、定期的な機器状態の更新に対応。ファームウェアバージョンを追加。Cliant:β1.2.0、Firm:β1.0.0
2025-11-03 LEDの点灯動作を変更
2025-11-03 ヘッダーをよりシンプルに変更
2025-11-03 バージョン表記を更新
2025-11-18 bodyのpage-containerがはみ出ている不具合を修正
2025-11-18 ボード名を変更
2025-11-18 校正機能を追加
2026-03-12 主にケースの更新
    [RaspberrypiPico2.step, SMU.kicad_pcb, SMU.step, SMU_ver0-0-4.step, ケース_メイン_ver1.3mf, ケース_メイン_ver2.3mf, ケース_メイン_ver3.3mf, ケース_メイン_ver4.3mf]
2026-03-13 ファームウェアをより安定したEIS測定に対応
2026-03-13 クライアントをより安定したEIS測定に対応
2026-03-13 電源モード変更ピンをPico2用に更新
2026-03-14 テキストデコーダやそのパイプ処理を接続時のみ行うように変更
2026-03-14 前コミットの訂正
2026-03-15 古いコードを削除、受信データ数を表示
2026-03-15 古いコードを削除
2026-03-20 コードを整理
2026-03-20 バージョン番号を更新
2026-03-20 誤って消していたコードを修正
2026-03-25 フォルダを整理
    [73100-0131.STEP, ADconverter.kicad_sch, BD87521_HP_SPICE.olb, BD87581_HP_SPICE.olb, BNC_3D.step, BOM-SMU.csv, Control.kicad_pcb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]
2026-04-03 ドキュメントを整理
